kangyuzhe666/kintex-410t-devboard/clocks.kicad_sch

## KiCad design clocks.kicad_sch (2023-04-08)

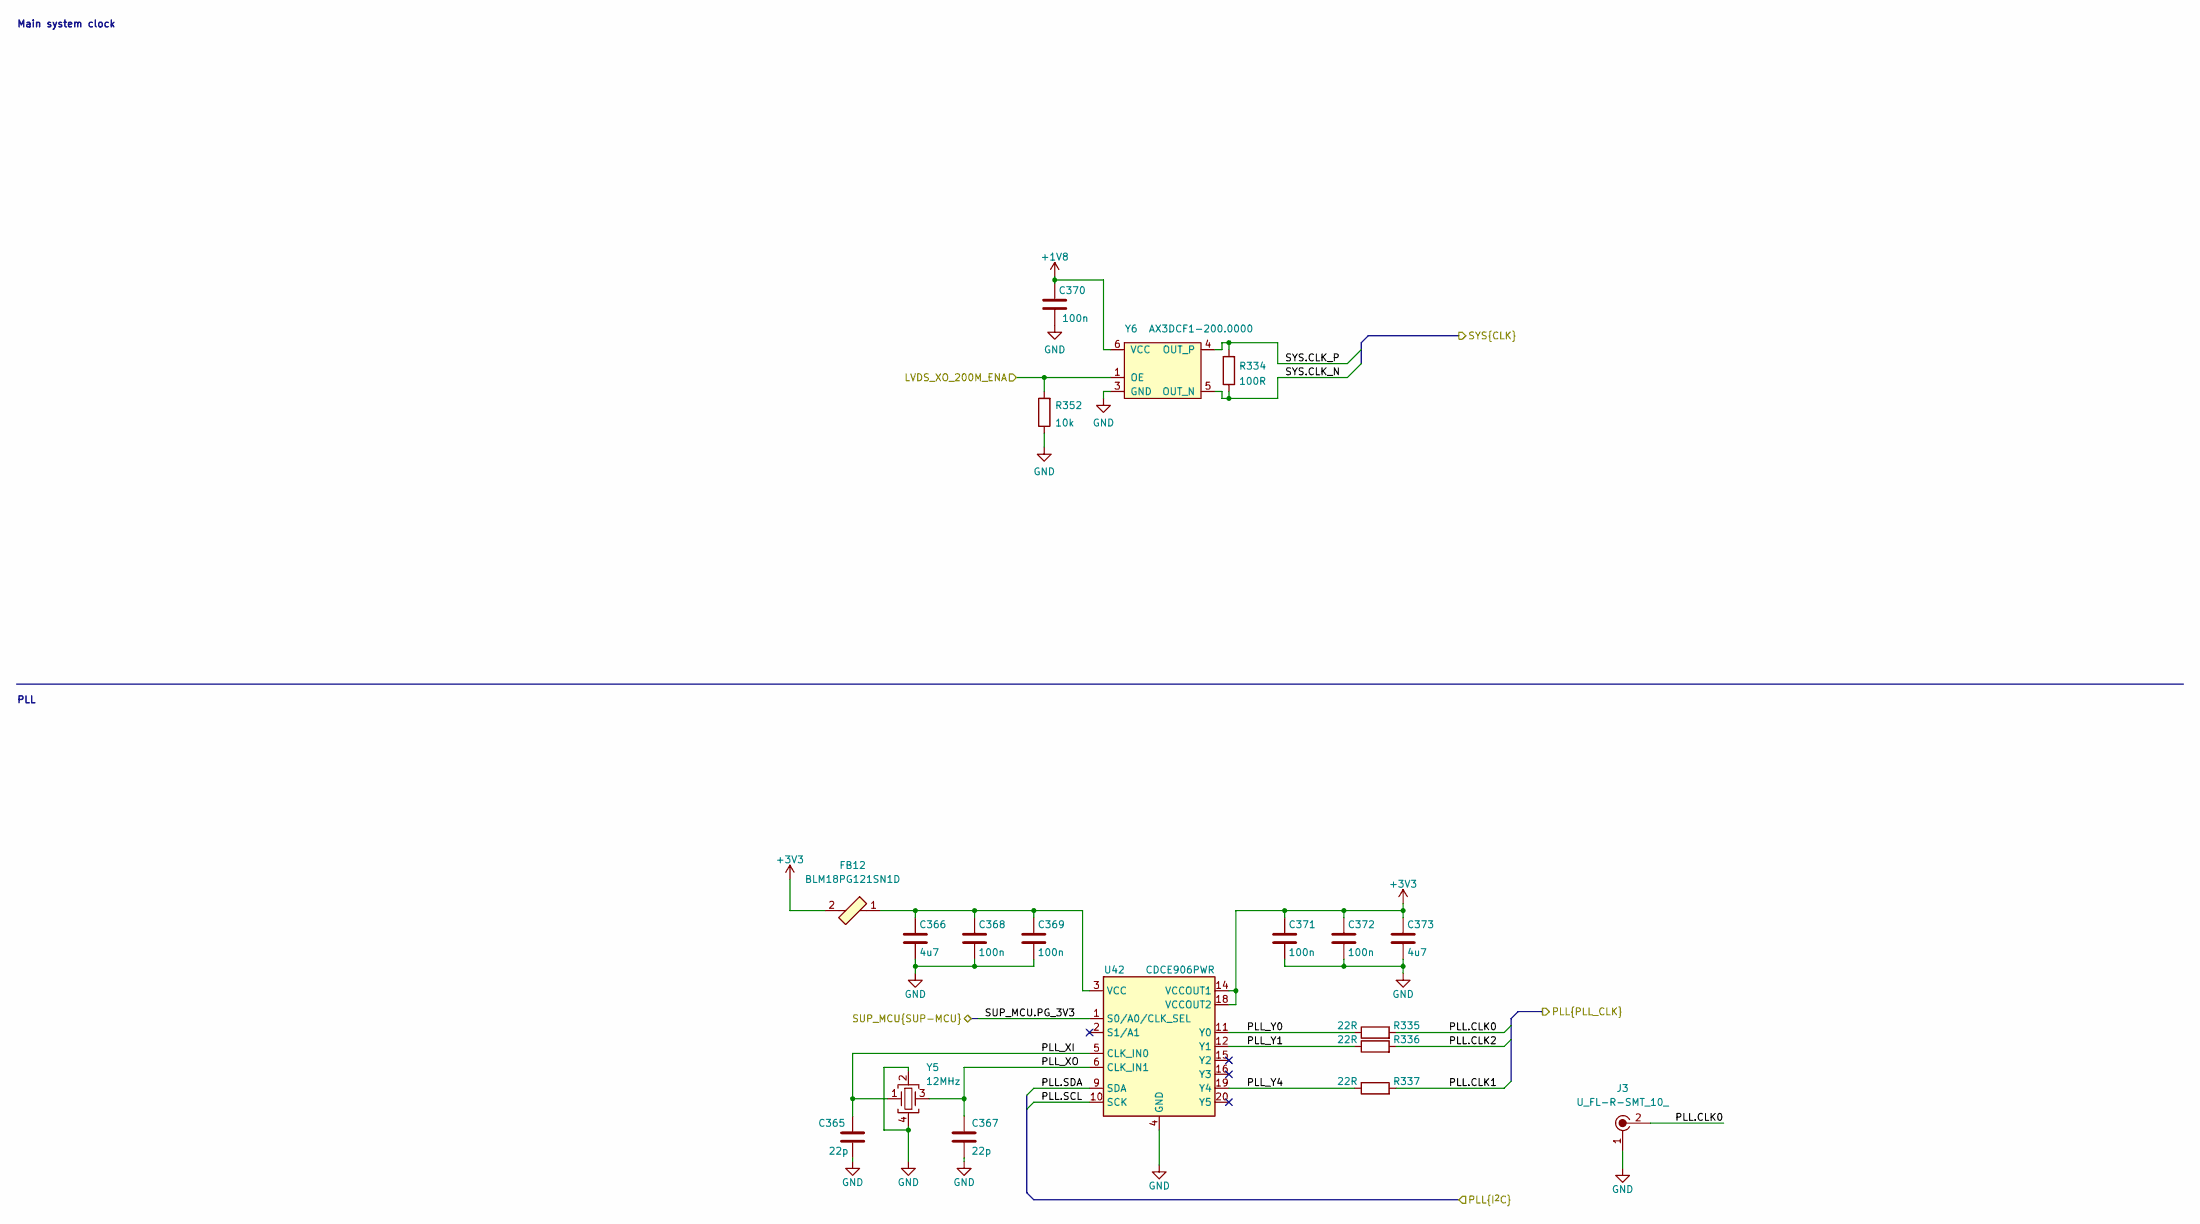
[picture p3: schematic clocks.kicad_sch]

Parts:
C365, C367: C_22p_0402; 0402-cap; MPN CC0402JRNPO9BN220
C366, C373: C_4u7_0201; 0201-cap; MPN GRM035R60J475ME15D
C368, C369, C370, C371, C372: C_100n_0402; 0402-cap; MPN GRM155R61H104KE14D
FB12: BLM18PG121SN1D; 0603-res; MPN BLM18PG121SN1D
J3: U_FL-R-SMT_10_; Coax_Conn_U.FL; MPN U.FL-R-SMT(10)
R334: R_100R_0402; 0402-res; MPN CR0402-FX-1000GLF
R335, R336, R337: R_22R_0402; 0402-res; MPN CRCW040222R0FKED
R352: R_10k_0402; 0402-res; MPN CRCW040210K0FKEDHP
U42: CDCE906PWR; TSSOP-20_W4.4mm; MPN CDCE906PWR
Y5: ABM8G-12.000MHZ-18-D2Y-T; KX-7; MPN ABM8G-12.000MHZ-18-D2Y-T
Y6: AX3DCF1-200.0000; AX3DAF1; MPN AX3DCF1-200.0000

Connections:
+1V8: C370.1, Y6.6 (VCC)
+3V3: C371.1, C372.1, C373.1, FB12.2, U42.14 (VCCOUT1), U42.18 (VCCOUT2)
GND: C365.2, C366.2, C367.2, C368.2, C369.2, C370.2, C371.2, C372.2, C373.2, J3.1, R352.1, U42.4 (GND), U42.8 (GND), U42.13 (GND), U42.17 (GND), Y5.2, Y5.4, Y6.3 (GND)
LVDS_XO_200M_ENA: R352.2, Y6.1 (OE)
unnamed: C366.1, C368.1, C369.1, FB12.1, U42.3 (VCC), U42.7 (VCC)
PLL.CLK0: J3.2, R335.2
PLL.CLK1: R337.2
PLL.CLK2: R336.2
PLL.SCL: U42.10 (SCK)
PLL.SDA: U42.9 (SDA)
PLL_XI: C365.1, U42.5 (CLK_IN0), Y5.1
PLL_XO: C367.1, U42.6 (CLK_IN1), Y5.3
PLL_Y0: R335.1, U42.11 (Y0)
PLL_Y1: R336.1, U42.12 (Y1)
PLL_Y4: R337.1, U42.19 (Y4)
SUP_MCU.PG_3V3: U42.1 (S0/A0/CLK_SEL)
SYS.CLK_N: R334.1, Y6.5 (OUT_N)
SYS.CLK_P: R334.2, Y6.4 (OUT_P)

Notes on the sheet:
Main system clock
PLL
