kangyuzhe666/kintex-410t-devboard/dc-dc.kicad_sch

## KiCad design dc-dc.kicad_sch (2023-02-02)

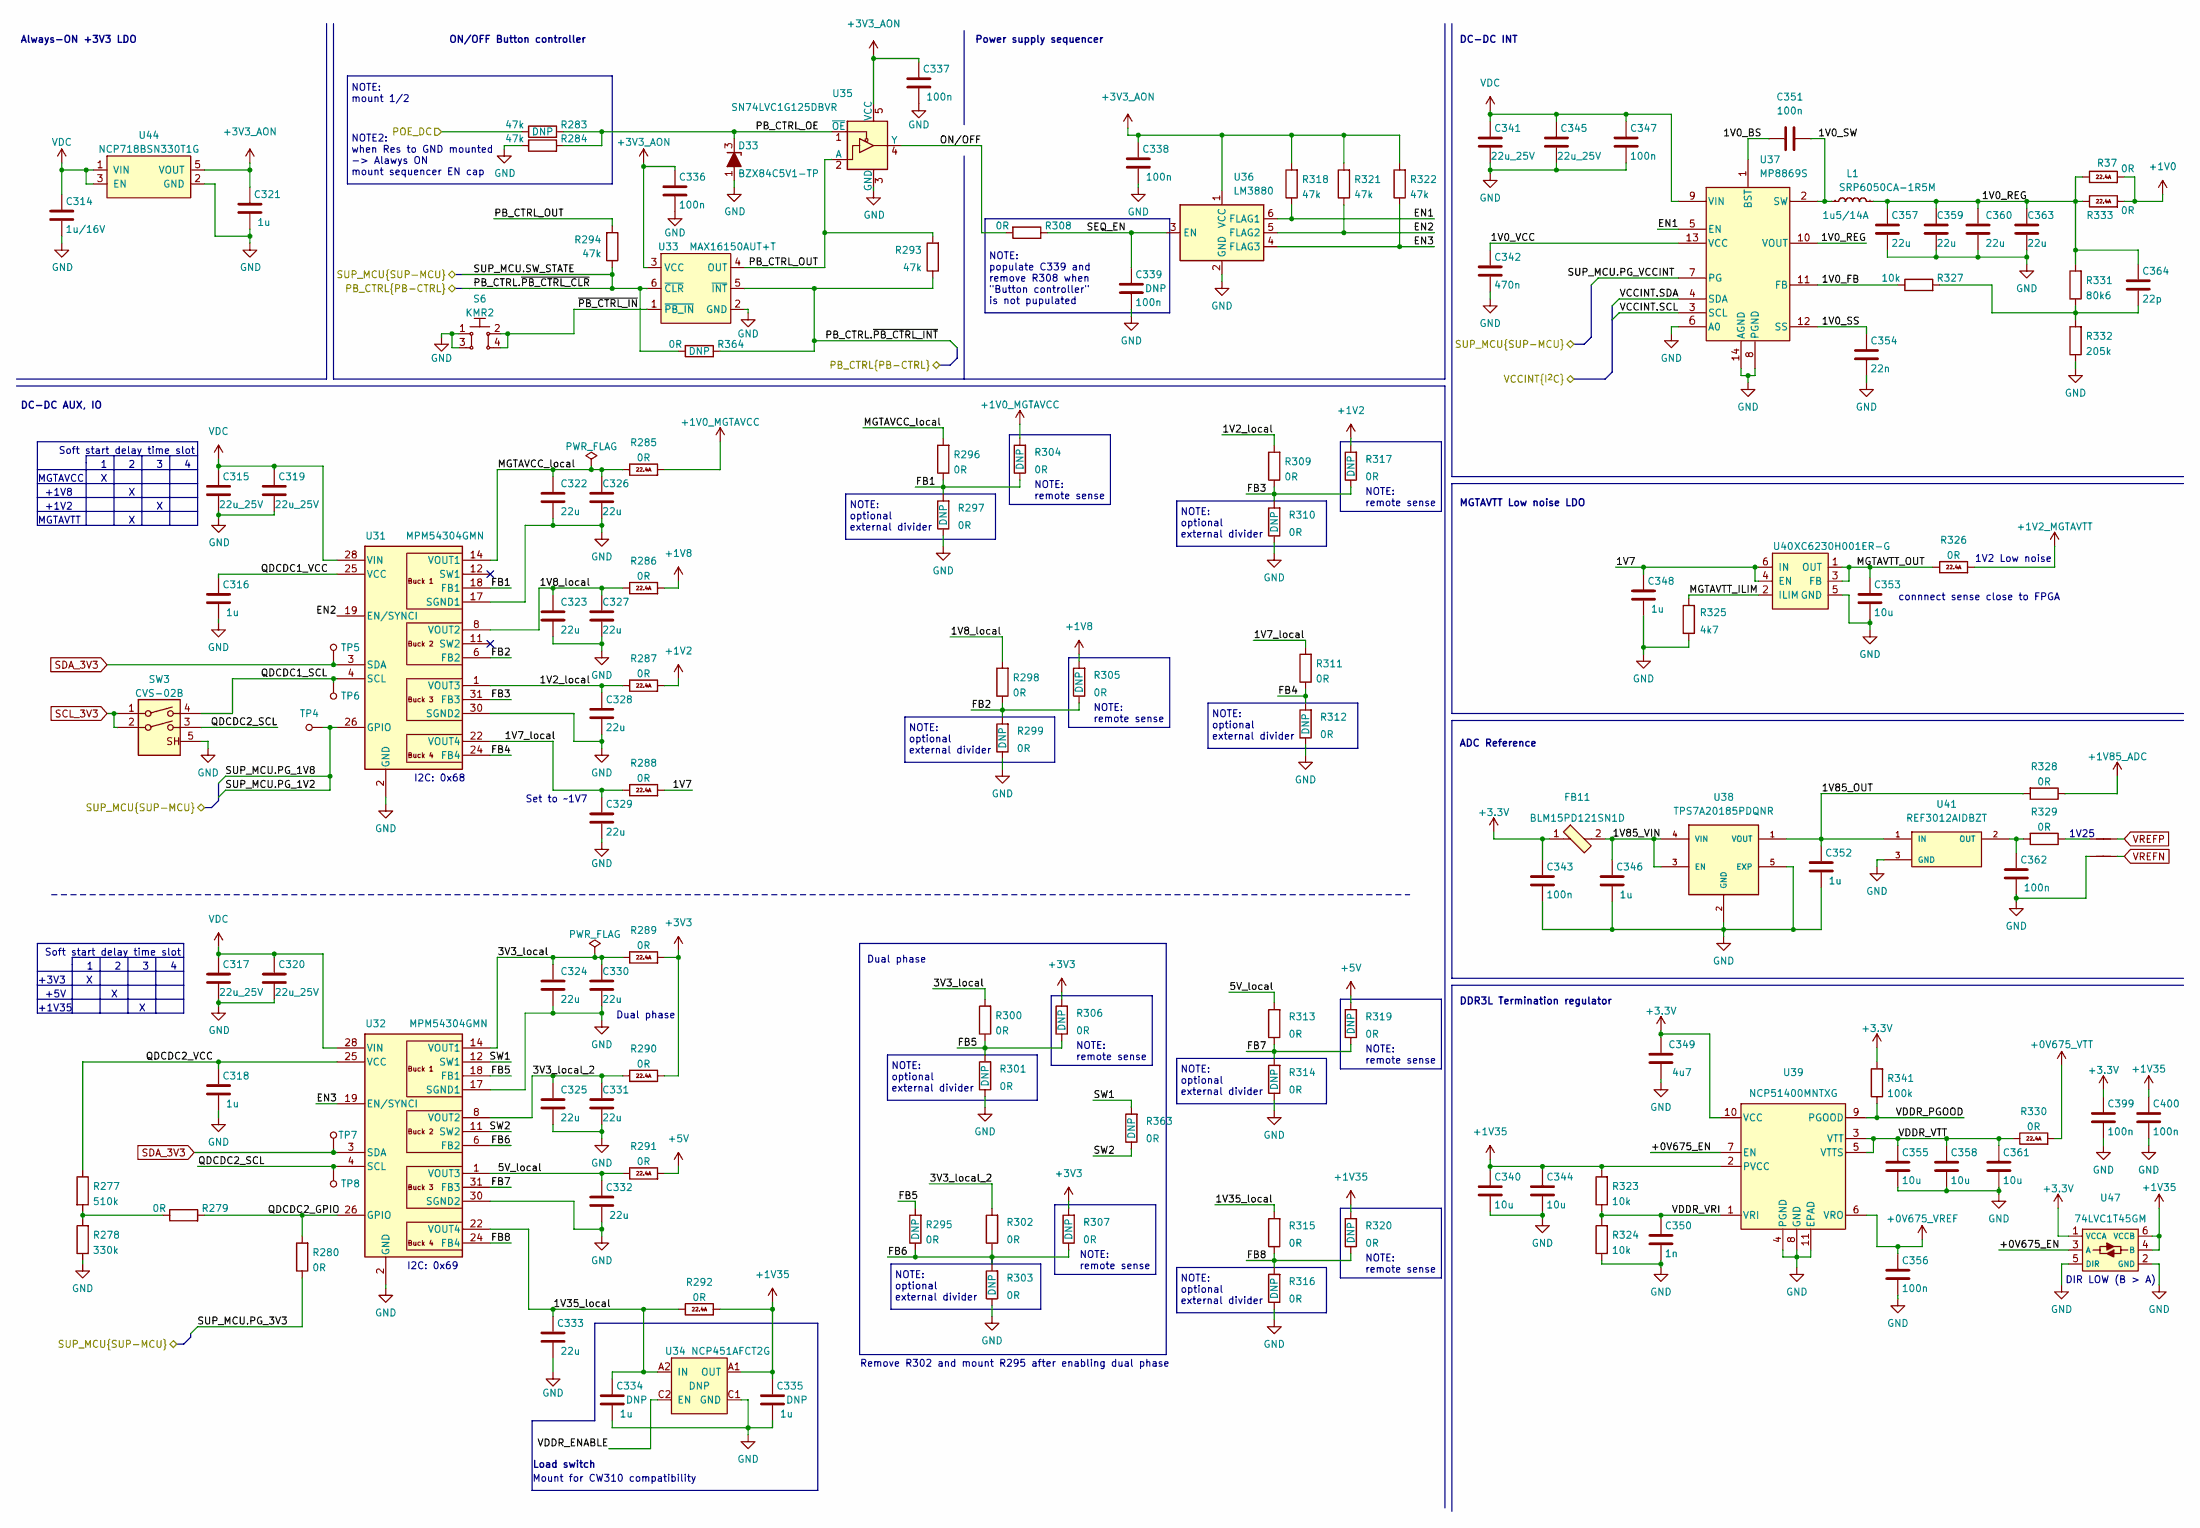
[picture p4: schematic dc-dc.kicad_sch]

Parts:
C314: C_1u_0402_16V; 0402-cap; MPN C0402C105M4PACTU
C315, C317, C319, C320, C341, C345: C_22u_0805_25V; 0805-cap; MPN CL21A226MAYNNNE
C316, C318, C321, C334, C335, C346, C348, C352: C_1u_0402; 0402-cap; MPN C1005X6S1A105K050BC
C322, C323, C324, C325, C326, C327, C328, C329, C330, C331, C332, C333, C357, C359, C360, C363: C_22u_0603; 0603-cap; MPN GRM188R60J226MEA0D
C336, C337, C338, C339, C343, C347, C351, C356, C362, C399, C400: C_100n_0402; 0402-cap; MPN GRM155R61H104KE14D
C340, C344, C353, C355, C358, C361: C_10u_0402; 0402-cap; MPN CC0402MRX5R5BB106
C342: C_470n_0402; 0402-cap; MPN C1005X5R1E474M050BB
C349: C_4u7_0201; 0201-cap; MPN GRM035R60J475ME15D
C350: C_1n_0402; 0402-res; MPN CC0402KRX7R9BB102
C354: C_22n_0402; 0402-cap; MPN GCM155R71H223MA55D
C364: C_22p_0402; 0402-cap; MPN CC0402JRNPO9BN220
D33: BZX84C5V1-TP; SOT-23-3; MPN BZX84C5V1-TP
FB11: BLM15PD121SN1D; 0402-res; MPN BLM15PD121SN1D
L1: SRP6050CA-1R5M; Bourns-SRP6050CA; MPN SRP6050CA-1R5M
NT1, NT2: NetTie_2; NetTie-2_SMD_Pad0.127mm
R37, R285, R286, R287, R288, R289, R290, R291, R292, R326, R330, R333: R_0R_0603_HPWR; 0603-res; MPN PMR03EZPJ000
R277: R_510k_0402; 0402-res; MPN MCWR04X5103FTL
R278: R_330k_0402; 0402-res; MPN ERJ-2RKF3303X
R279, R280, R295, R296, R297, R298, R299, R300, R301, R302, R303, R304, R305, R306, R307, R308, R309, R310, R311, R312, R313, R314, R315, R316, R317, R319, R320, R328, R329, R363, R364: R_0R_0402; 0402-res; MPN ERJ2GE0R00X
R283, R284, R293, R294, R318, R321, R322: R_47k_0402; 0402-res; MPN MCMR04X4702FTL
R323, R324, R327: R_10k_0402; 0402-res; MPN CRCW040210K0FKEDHP
R325: R_4k7_0402; 0402-res; MPN MCS04020C4701FE000
R331: R_80k6_0402; 0402-res; MPN ERJ2RKF8062X
R332: R_205k_0402; 0402-res; MPN CR0402-FX-2053GLF
R341: R_100k_0402; 0402-res; MPN CRCW0402100KFKEDHP
S6: KMR2; SW_SPST_4.2x2.8; MPN KMR211NGLFS
SW3: CVS-02B; SW_DIP_SPSTx02_Slide_Copal_CVS-02xB_W5.9mm_P1mm; MPN CVS-02B
TP4, TP5, TP6, TP7, TP8: TP_SMD_0_75MM; Testpoint_smd_0_75mm
U31, U32: MPM54304GMN; MPS_LGA-33; MPN MPM54304GMN-0000
U33: MAX16150AUT+T; SOT-23-6; MPN MAX16150AUT+T
U34: NCP451AFCT2G; Onsemi_WLCSP6_1.40x0.90; MPN NCP451AFCT2G
U35: SN74LVC1G125DBVR; SOT-753; MPN SN74LVC1G125DBVR
U36: LM3880; SOT-23-6; MPN LM3880MFX-1AA/NOPB
U37: MP8869S; MPS_QFN-14_MP8869S; MPN MP8869SGL-P
U38: TPS7A20185PDQNR; XDFN4; MPN TPS7A20185PDQNR
U39: NCP51400MNTXG; DFN-10-1EP_3x3mm; MPN NCP51400MNTXG
U40: XC6230H001ER-G; Torex_USP-6C; MPN XC6230H001ER-G
U41: REF3012AIDBZT; SOT-23-3; MPN REF3012AIDBZT
U44: NCP718BSN330T1G; SOT-23-5; MPN NCP718BSN330T1G
U47: 74LVC1T45GM; SOT-886; MPN 74LVC1T45GM-Q100X

Connections:
1V0_BS: C351.1, U37.1 (BST)
1V0_FB: R327.1, U37.11 (FB)
1V0_REG: C357.1, C359.1, C360.1, C363.1, C364.1, L1.2, R37.1, R331.2, R333.1, U37.10 (VOUT)
1V0_SS: C354.1, U37.12 (SS)
1V0_SW: C351.2, L1.1, U37.2 (SW)
1V0_VCC: C342.1, U37.13 (VCC)
1V2_local: C328.1, R287.1, R309.2, U31.1 (VOUT3), U31.32 (VOUT3)
1V7: C348.1, R288.2, U40.4 (EN), U40.6 (IN)
1V7_local: C329.1, R288.1, R311.2, U31.22 (VOUT4), U31.23 (VOUT4)
1V8_local: C323.1, C327.1, R286.1, R298.2, U31.8 (VOUT2), U31.9 (VOUT2)
1V35_local: C333.1, C334.1, R292.1, R315.2, U32.22 (VOUT4), U32.23 (VOUT4), U34.A2 (IN), U34.B2 (IN)
1V85_OUT: C352.1, R328.2, U38.1 (VOUT), U41.1 (IN)
1V85_VIN: C346.1, FB11.2, U38.3 (EN), U38.4 (VIN)
3V3_local: C324.1, C330.1, R289.1, R300.2, U32.14 (VOUT1), U32.15 (VOUT1)
3V3_local_2: C325.1, C331.1, R290.1, R302.2, U32.8 (VOUT2), U32.9 (VOUT2)
5V_local: C332.1, R291.1, R313.2, U32.1 (VOUT3), U32.32 (VOUT3)
+0V675_EN: U39.7 (EN), U47.3 (A)
+0V675_VREF: C356.1, U39.6 (VRO)
+0V675_VTT: R330.2
+1V0: R37.2, R333.2
+1V0_MGTAVCC: R285.2, R304.2
+1V2: R287.2, R317.2
+1V2_MGTAVTT: R326.2
+1V8: R286.2, R305.2
+1V35: C335.1, C340.1, C344.1, C400.1, R292.2, R320.2, R323.2, U34.A1 (OUT), U34.B1 (OUT), U39.2 (PVCC), U47.4 (B), U47.6 (VCCB)
+1V85_ADC: R328.1
+3.3V: C343.1, C349.1, C399.1, FB11.1, R341.2, U39.10 (VCC), U47.1 (VCCA)
+3V3: R289.2, R290.2, R306.2, R307.2
+3V3_AON: C321.1, C336.1, C337.1, C338.1, R318.2, R321.2, R322.2, U33.3 (VCC), U35.5 (VCC), U36.1 (VCC), U44.5 (VOUT)
+5V: R291.2, R319.2
EN1: R318.1, U36.6 (FLAG1), U37.5 (EN)
EN2: R321.1, U31.19 (EN/SYNCI), U36.5 (FLAG2)
EN3: R322.1, U32.19 (EN/SYNCI), U36.4 (FLAG3)
FB1: R296.1, R297.2, R304.1, U31.18 (FB1)
FB2: R298.1, R299.2, R305.1, U31.6 (FB2)
FB3: R309.1, R310.2, R317.1, U31.31 (FB3)
FB4: R311.1, R312.2, U31.24 (FB4)
FB5: R295.2, R300.1, R301.2, R306.1, U32.18 (FB1)
FB6: R295.1, R302.1, R303.2, R307.1, U32.6 (FB2)
FB7: R313.1, R314.2, R319.1, U32.31 (FB3)
FB8: R315.1, R316.2, R320.1, U32.24 (FB4)
GND: C314.2, C315.2, C316.2, C317.2, C318.2, C319.2, C320.2, C321.2, C322.2, C323.2, C324.2, C325.2, C326.2, C327.2, C328.2, C329.2, C330.2, C331.2, C332.2, C333.2, C334.2, C335.2, C336.2, C337.2, C338.2, C339.2, C340.2, C341.2, C342.2, C343.2, C344.2, C345.2, C346.2, C347.2, C348.2, C349.2, C350.2, C352.2, C353.2, C354.2, C355.2, C356.2, C357.2, C358.2, C359.2, C360.2, C361.2, C362.2, C363.2, C399.2, C400.2, D33.1, NT2.1, R278.1, R284.1, R297.1, R299.1, R301.1, R303.1, R310.1, R312.1, R314.1, R316.1, R324.1, R325.1, R332.1, S6.1, S6.3, SW3.5 (SH), U31.2 (GND), U31.5 (GND), U31.7 (GND), U31.10 (GND), U31.13 (GND), U31.16 (GND), U31.17 (SGND1), U31.20 (GND), U31.21 (GND), U31.27 (GND), U31.30 (SGND2), U31.33 (GND), U32.2 (GND), U32.5 (GND), U32.7 (GND), U32.10 (GND), U32.13 (GND), U32.16 (GND), U32.17 (SGND1), U32.20 (GND), U32.21 (GND), U32.27 (GND), U32.30 (SGND2), U32.33 (GND), U33.2 (GND), U34.C1 (GND), U35.3 (GND), U36.2 (GND), U37.6 (A0), U37.8 (PGND), U37.14 (AGND), U38.2 (GND), U38.5 (EXP), U39.4 (PGND), U39.8 (GND), U39.11 (EPAD), U40.5 (GND), U40.7 (EP), U41.3 (GND), U44.2 (GND), U47.2 (GND), U47.5 (DIR)
MGTAVCC_local: C322.1, C326.1, R285.1, R296.2, U31.14 (VOUT1), U31.15 (VOUT1)
MGTAVTT_ILIM: R325.2, U40.2 (ILIM)
MGTAVTT_OUT: C353.1, R326.1, U40.1 (OUT), U40.3 (FB)
unnamed: C362.1, R329.2, U41.2 (OUT)
unnamed: C364.2, R327.2, R331.1, R332.2
unnamed: NT1.1, R329.1
unnamed: R277.2, R278.2, R279.1
ON/OFF: R308.2, U35.4 (Y)
PB_CTRL.~PB_CTRL_CLR: R294.1, R364.2, U33.6 (~CLR)
PB_CTRL.~PB_CTRL_INT: R293.1, R364.1, U33.5 (~INT)
PB_CTRL_OE: D33.3, R283.2, R284.2, U35.1 (~OE)
PB_CTRL_OUT: R293.2, R294.2, U33.4 (OUT), U35.2 (A)
POE_DC: R283.1
QDCDC1_SCL: SW3.4, TP6.1, U31.4 (SCL)
QDCDC1_VCC: C316.1, U31.25 (VCC)
QDCDC2_GPIO: R279.2, R280.2, U32.26 (GPIO)
QDCDC2_SCL: SW3.3, TP8.1, U32.4 (SCL)
QDCDC2_VCC: C318.1, R277.1, U32.25 (VCC)
SCL_3V3: SW3.1, SW3.2
SDA_3V3: TP5.1, TP7.1, U31.3 (SDA), U32.3 (SDA)
SEQ_EN: C339.1, R308.1, U36.3 (EN)
SUP_MCU.PG_1V2: TP4.1, U31.26 (GPIO)
SUP_MCU.PG_3V3: R280.1
SUP_MCU.PG_VCCINT: U37.7 (PG)
SW1: R363.2, U32.12 (SW1)
SW2: R363.1, U32.11 (SW2)
VCCINT.SCL: U37.3 (SCL)
VCCINT.SDA: U37.4 (SDA)
VDC: C314.1, C315.1, C317.1, C319.1, C320.1, C341.1, C345.1, C347.1, U31.28 (VIN), U31.29 (VIN), U32.28 (VIN), U32.29 (VIN), U37.9 (VIN), U44.1 (VIN), U44.3 (EN)
VDDR_ENABLE: U34.C2 (EN)
VDDR_PGOOD: R341.1, U39.9 (PGOOD)
VDDR_VRI: C350.1, R323.1, R324.2, U39.1 (VRI)
VDDR_VTT: C355.1, C358.1, C361.1, R330.1, U39.3 (VTT), U39.5 (VTTS)
VREFN: NT2.2
VREFP: NT1.2
~PB_CTRL_IN: S6.2, S6.4, U33.1 (~PB_IN)

Notes on the sheet:
Dual phase
MGTAVCC
Always-ON +3V3 LDO
I2C: 0x68
Soft start delay time slot
Mount for CW310 compatibility
+1V8
ADC Reference
NOTE: populate C339 and remove R308 when "Button controller" is not pupulated
MGTAVTT
NOTE: optional external divider
NOTE: remote sense
DIR LOW (B > A)
Set to ~1V7
1 2 3 4
+1V35
connnect sense close to FPGA
+5V
MGTAVTT Low noise LDO
Power supply sequencer
DC-DC INT
Load switch
I2C: 0x69
DC-DC AUX, IO
+1V2
1V2 Low noise
1V25
ON/OFF Button controller
Remove R302 and mount R295 after enabling dual phase
NOTE: mount 1/2
+3V3
DDR3L Termination regulator
NOTE2: when Res to GND mounted -> Alawys ON mount sequencer EN cap
