kangyuzhe666/kintex-410t-devboard/fmc-hspc.kicad_sch

## KiCad design fmc-hspc.kicad_sch (2023-04-08)

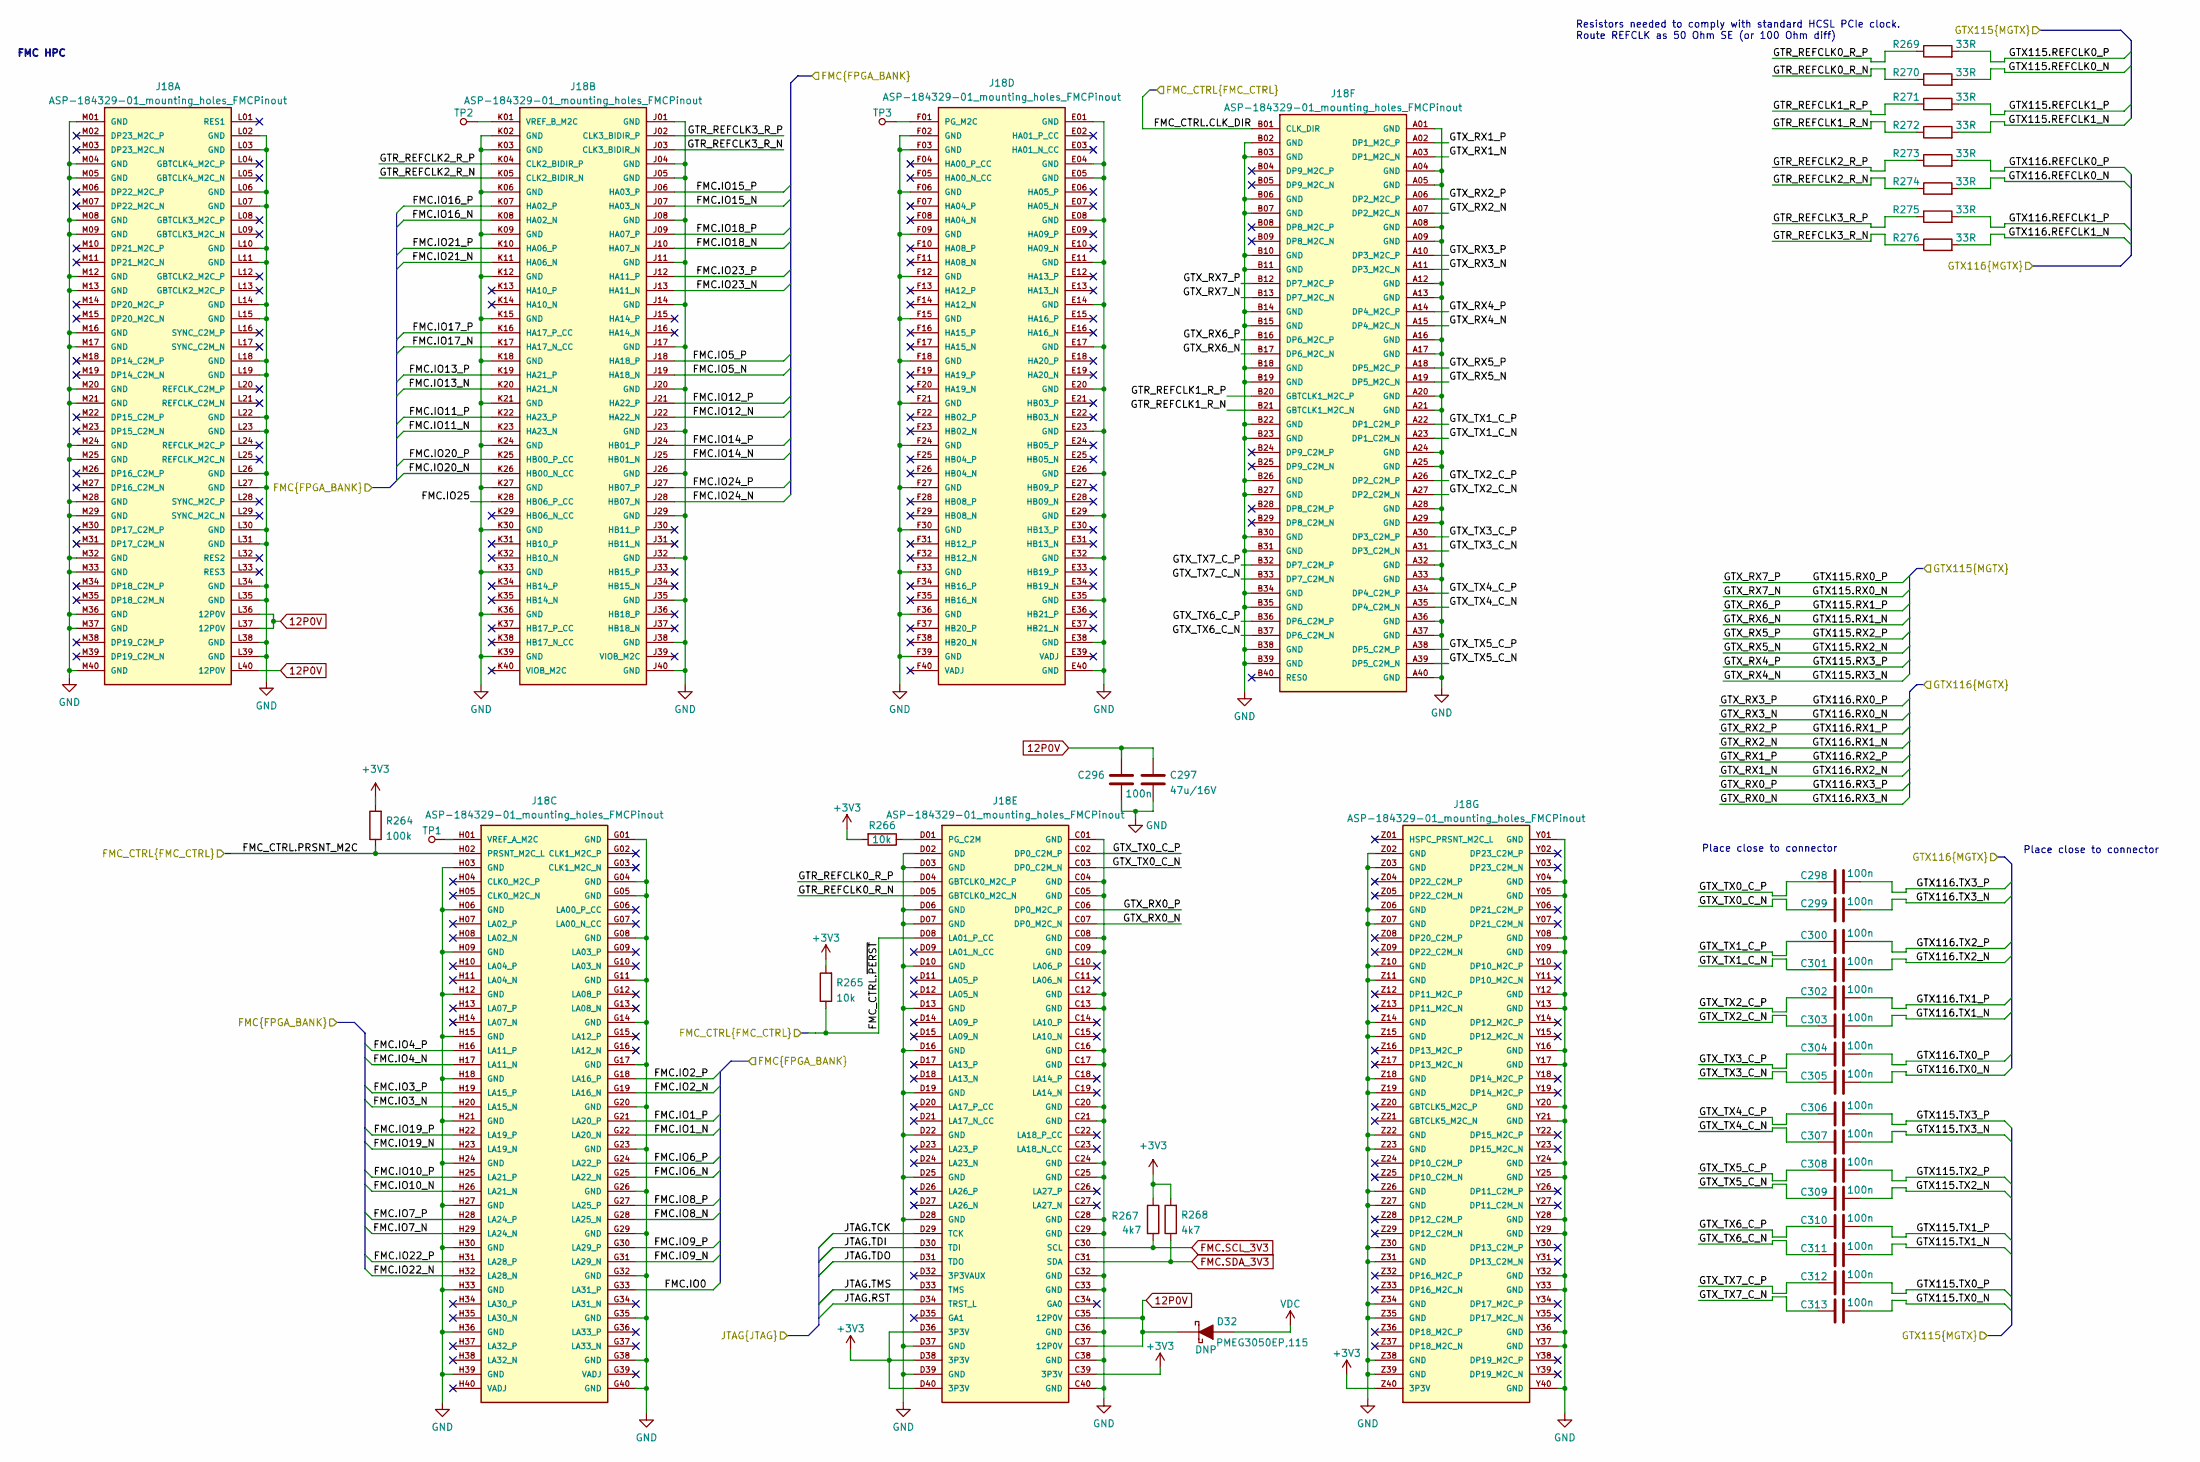
[picture p5: schematic fmc-hspc.kicad_sch]

Parts:
C296: C_100n_0402_EIA; 0402-cap_EIA; MPN GRM155R61H104KE14D
C297: C_47u_16V_1206; 1206-cap; MPN C3216X5R1C476M160AB
C298, C299, C300, C301, C302, C303, C304, C305, C306, C307, C308, C309, C310, C311, C312, C313: C_100n_0402; 0402-cap; MPN GRM155R61H104KE14D
D32: PMEG3050EP,115; Nexperia_SOD128; MPN PMEG3050EP,115
J18: ASP-184329-01_mounting_holes_FMCPinout; ASP-184329-01_mounting_holes; MPN ASP-184329-01
R264: R_100k_0402; 0402-res; MPN CRCW0402100KFKEDHP
R265, R266: R_10k_0402; 0402-res; MPN CRCW040210K0FKEDHP
R267, R268: R_4k7_0402; 0402-res; MPN MCS04020C4701FE000
R269, R270, R271, R272, R273, R274, R275, R276: R_33R_0402; 0402-res; MPN CRCW040233R0FKED
TP1, TP2, TP3: TP_SMD_0_75MM; Testpoint_smd_0_75mm

Connections:
12P0V: C296.1, C297.1, D32.1, J18.C35 (12P0V), J18.C37 (12P0V), J18.L36 (12P0V), J18.L37 (12P0V), J18.L40 (12P0V)
+3V3: J18.C39 (3P3V), J18.D36 (3P3V), J18.D38 (3P3V), J18.D40 (3P3V), J18.Z40 (3P3V), R264.2, R265.2, R266.2, R267.1, R268.2
FMC.IO0: J18.G33 (LA31_P)
FMC.IO1_N: J18.G22 (LA20_N)
FMC.IO1_P: J18.G21 (LA20_P)
FMC.IO2_N: J18.G19 (LA16_N)
FMC.IO2_P: J18.G18 (LA16_P)
FMC.IO3_N: J18.H20 (LA15_N)
FMC.IO3_P: J18.H19 (LA15_P)
FMC.IO4_N: J18.H17 (LA11_N)
FMC.IO4_P: J18.H16 (LA11_P)
FMC.IO5_N: J18.J19 (HA18_N)
FMC.IO5_P: J18.J18 (HA18_P)
FMC.IO6_N: J18.G25 (LA22_N)
FMC.IO6_P: J18.G24 (LA22_P)
FMC.IO7_N: J18.H29 (LA24_N)
FMC.IO7_P: J18.H28 (LA24_P)
FMC.IO8_N: J18.G28 (LA25_N)
FMC.IO8_P: J18.G27 (LA25_P)
FMC.IO9_N: J18.G31 (LA29_N)
FMC.IO9_P: J18.G30 (LA29_P)
FMC.IO10_N: J18.H26 (LA21_N)
FMC.IO10_P: J18.H25 (LA21_P)
FMC.IO11_N: J18.K23 (HA23_N)
FMC.IO11_P: J18.K22 (HA23_P)
FMC.IO12_N: J18.J22 (HA22_N)
FMC.IO12_P: J18.J21 (HA22_P)
FMC.IO13_N: J18.K20 (HA21_N)
FMC.IO13_P: J18.K19 (HA21_P)
FMC.IO14_N: J18.J25 (HB01_N)
FMC.IO14_P: J18.J24 (HB01_P)
FMC.IO15_N: J18.J07 (HA03_N)
FMC.IO15_P: J18.J06 (HA03_P)
FMC.IO16_N: J18.K08 (HA02_N)
FMC.IO16_P: J18.K07 (HA02_P)
FMC.IO17_N: J18.K17 (HA17_N_CC)
FMC.IO17_P: J18.K16 (HA17_P_CC)
FMC.IO18_N: J18.J10 (HA07_N)
FMC.IO18_P: J18.J09 (HA07_P)
FMC.IO19_N: J18.H23 (LA19_N)
FMC.IO19_P: J18.H22 (LA19_P)
FMC.IO20_N: J18.K26 (HB00_N_CC)
FMC.IO20_P: J18.K25 (HB00_P_CC)
FMC.IO21_N: J18.K11 (HA06_N)
FMC.IO21_P: J18.K10 (HA06_P)
FMC.IO22_N: J18.H32 (LA28_N)
FMC.IO22_P: J18.H31 (LA28_P)
FMC.IO23_N: J18.J13 (HA11_N)
FMC.IO23_P: J18.J12 (HA11_P)
FMC.IO24_N: J18.J28 (HB07_N)
FMC.IO24_P: J18.J27 (HB07_P)
FMC.IO25: J18.K28 (HB06_P_CC)
FMC.SCL_3V3: J18.C30 (SCL), R267.2
FMC.SDA_3V3: J18.C31 (SDA), R268.1
FMC_CTRL.CLK_DIR: J18.B01 (CLK_DIR)
FMC_CTRL.PRSNT_M2C: J18.H02 (PRSNT_M2C_L), R264.1
FMC_CTRL.~PERST: J18.D08 (LA01_P_CC), R265.1
GND: C296.2, C297.2, J18.A01 (GND), J18.A04 (GND), J18.A05 (GND), J18.A08 (GND), J18.A09 (GND), J18.A12 (GND), J18.A13 (GND), J18.A16 (GND), J18.A17 (GND), J18.A20 (GND), J18.A21 (GND), J18.A24 (GND), J18.A25 (GND), J18.A28 (GND), J18.A29 (GND), J18.A32 (GND), J18.A33 (GND), J18.A36 (GND), J18.A37 (GND), J18.A40 (GND), J18.B02 (GND), J18.B03 (GND), J18.B06 (GND), J18.B07 (GND), J18.B10 (GND), J18.B11 (GND), J18.B14 (GND), J18.B15 (GND), J18.B18 (GND), J18.B19 (GND), J18.B22 (GND), J18.B23 (GND), J18.B26 (GND), J18.B27 (GND), J18.B30 (GND), J18.B31 (GND), J18.B34 (GND), J18.B35 (GND), J18.B38 (GND), J18.B39 (GND), J18.C01 (GND), J18.C04 (GND), J18.C05 (GND), J18.C08 (GND), J18.C09 (GND), J18.C12 (GND), J18.C13 (GND), J18.C16 (GND), J18.C17 (GND), J18.C20 (GND), J18.C21 (GND), J18.C24 (GND), J18.C25 (GND), J18.C28 (GND), J18.C29 (GND), J18.C32 (GND), J18.C33 (GND), J18.C36 (GND), J18.C38 (GND), J18.C40 (GND), J18.D02 (GND), J18.D03 (GND), J18.D06 (GND), J18.D07 (GND), J18.D10 (GND), J18.D13 (GND), J18.D16 (GND), J18.D19 (GND), J18.D22 (GND), J18.D25 (GND), J18.D28 (GND), J18.D37 (GND), J18.D39 (GND), J18.E01 (GND), J18.E04 (GND), J18.E05 (GND), J18.E08 (GND), J18.E11 (GND), J18.E14 (GND), J18.E17 (GND), J18.E20 (GND), J18.E23 (GND), J18.E26 (GND), J18.E29 (GND), J18.E32 (GND), J18.E35 (GND), J18.E38 (GND), J18.E40 (GND), J18.F02 (GND), J18.F03 (GND), J18.F06 (GND), J18.F09 (GND), J18.F12 (GND), J18.F15 (GND), J18.F18 (GND), J18.F21 (GND), J18.F24 (GND), J18.F27 (GND), J18.F30 (GND), J18.F33 (GND), J18.F36 (GND), J18.F39 (GND), J18.G01 (GND), J18.G04 (GND), J18.G05 (GND), J18.G08 (GND), J18.G11 (GND), J18.G14 (GND), J18.G17 (GND), J18.G20 (GND), J18.G23 (GND), J18.G26 (GND), J18.G29 (GND), J18.G32 (GND), J18.G35 (GND), J18.G38 (GND), J18.G40 (GND), J18.H03 (GND), J18.H06 (GND), J18.H09 (GND), J18.H12 (GND), J18.H15 (GND), J18.H18 (GND), J18.H21 (GND), J18.H24 (GND), J18.H27 (GND), J18.H30 (GND), J18.H33 (GND), J18.H36 (GND), J18.H39 (GND), J18.J01 (GND), J18.J04 (GND), J18.J05 (GND), J18.J08 (GND), J18.J11 (GND), J18.J14 (GND), J18.J17 (GND), J18.J20 (GND), J18.J23 (GND), J18.J26 (GND), J18.J29 (GND), J18.J32 (GND), J18.J35 (GND), J18.J38 (GND), J18.J40 (GND), J18.K02 (GND), J18.K03 (GND), J18.K06 (GND), J18.K09 (GND), J18.K12 (GND), J18.K15 (GND), J18.K18 (GND), J18.K21 (GND), J18.K24 (GND), J18.K27 (GND), J18.K30 (GND), J18.K33 (GND), J18.K36 (GND), J18.K39 (GND), J18.L02 (GND), J18.L03 (GND), J18.L06 (GND), J18.L07 (GND), J18.L10 (GND), J18.L11 (GND), J18.L14 (GND), J18.L15 (GND), J18.L18 (GND), J18.L19 (GND), J18.L22 (GND), J18.L23 (GND), J18.L26 (GND), J18.L27 (GND), J18.L30 (GND), J18.L31 (GND), J18.L34 (GND), J18.L35 (GND), J18.L38 (GND), J18.L39 (GND), J18.M01 (GND), J18.M04 (GND), J18.M05 (GND), J18.M08 (GND), J18.M09 (GND), J18.M12 (GND), J18.M13 (GND), J18.M16 (GND), J18.M17 (GND), J18.M20 (GND), J18.M21 (GND), J18.M24 (GND), J18.M25 (GND), J18.M28 (GND), J18.M29 (GND), J18.M32 (GND), J18.M33 (GND), J18.M36 (GND), J18.M37 (GND), J18.M40 (GND), J18.Y01 (GND), J18.Y04 (GND), J18.Y05 (GND), J18.Y08 (GND), J18.Y09 (GND), J18.Y12 (GND), J18.Y13 (GND), J18.Y16 (GND), J18.Y17 (GND), J18.Y20 (GND), J18.Y21 (GND), J18.Y24 (GND), J18.Y25 (GND), J18.Y28 (GND), J18.Y29 (GND), J18.Y32 (GND), J18.Y33 (GND), J18.Y36 (GND), J18.Y37 (GND), J18.Y40 (GND), J18.Z02 (GND), J18.Z03 (GND), J18.Z06 (GND), J18.Z07 (GND), J18.Z10 (GND), J18.Z11 (GND), J18.Z14 (GND), J18.Z15 (GND), J18.Z18 (GND), J18.Z19 (GND), J18.Z22 (GND), J18.Z23 (GND), J18.Z26 (GND), J18.Z27 (GND), J18.Z30 (GND), J18.Z31 (GND), J18.Z34 (GND), J18.Z35 (GND), J18.Z38 (GND), J18.Z39 (GND)
GTR_REFCLK0_R_N: J18.D05 (GBTCLK0_M2C_N), R270.1
GTR_REFCLK0_R_P: J18.D04 (GBTCLK0_M2C_P), R269.1
GTR_REFCLK1_R_N: J18.B21 (GBTCLK1_M2C_N), R272.1
GTR_REFCLK1_R_P: J18.B20 (GBTCLK1_M2C_P), R271.1
GTR_REFCLK2_R_N: J18.K05 (CLK2_BIDIR_N), R274.1
GTR_REFCLK2_R_P: J18.K04 (CLK2_BIDIR_P), R273.1
GTR_REFCLK3_R_N: J18.J03 (CLK3_BIDIR_N), R276.1
GTR_REFCLK3_R_P: J18.J02 (CLK3_BIDIR_P), R275.1
GTX115.REFCLK0_N: R270.2
GTX115.REFCLK0_P: R269.2
GTX115.REFCLK1_N: R272.2
GTX115.REFCLK1_P: R271.2
GTX115.RX0_N: J18.B13 (DP7_M2C_N)
GTX115.RX0_P: J18.B12 (DP7_M2C_P)
GTX115.RX1_N: J18.B17 (DP6_M2C_N)
GTX115.RX1_P: J18.B16 (DP6_M2C_P)
GTX115.RX2_N: J18.A19 (DP5_M2C_N)
GTX115.RX2_P: J18.A18 (DP5_M2C_P)
GTX115.RX3_N: J18.A15 (DP4_M2C_N)
GTX115.RX3_P: J18.A14 (DP4_M2C_P)
GTX115.TX0_N: C313.2
GTX115.TX0_P: C312.2
GTX115.TX1_N: C311.2
GTX115.TX1_P: C310.2
GTX115.TX2_N: C309.2
GTX115.TX2_P: C308.2
GTX115.TX3_N: C307.2
GTX115.TX3_P: C306.2
GTX116.REFCLK0_N: R274.2
GTX116.REFCLK0_P: R273.2
GTX116.REFCLK1_N: R276.2
GTX116.REFCLK1_P: R275.2
GTX116.RX0_N: J18.A11 (DP3_M2C_N)
GTX116.RX0_P: J18.A10 (DP3_M2C_P)
GTX116.RX1_N: J18.A07 (DP2_M2C_N)
GTX116.RX1_P: J18.A06 (DP2_M2C_P)
GTX116.RX2_N: J18.A03 (DP1_M2C_N)
GTX116.RX2_P: J18.A02 (DP1_M2C_P)
GTX116.RX3_N: J18.C07 (DP0_M2C_N)
GTX116.RX3_P: J18.C06 (DP0_M2C_P)
GTX116.TX0_N: C305.2
GTX116.TX0_P: C304.2
GTX116.TX1_N: C303.2
GTX116.TX1_P: C302.2
GTX116.TX2_N: C301.2
GTX116.TX2_P: C300.2
GTX116.TX3_N: C299.2
GTX116.TX3_P: C298.2
GTX_TX0_C_N: C299.1, J18.C03 (DP0_C2M_N)
GTX_TX0_C_P: C298.1, J18.C02 (DP0_C2M_P)
GTX_TX1_C_N: C301.1, J18.A23 (DP1_C2M_N)
GTX_TX1_C_P: C300.1, J18.A22 (DP1_C2M_P)
GTX_TX2_C_N: C303.1, J18.A27 (DP2_C2M_N)
GTX_TX2_C_P: C302.1, J18.A26 (DP2_C2M_P)
GTX_TX3_C_N: C305.1, J18.A31 (DP3_C2M_N)
GTX_TX3_C_P: C304.1, J18.A30 (DP3_C2M_P)
GTX_TX4_C_N: C307.1, J18.A35 (DP4_C2M_N)
GTX_TX4_C_P: C306.1, J18.A34 (DP4_C2M_P)
GTX_TX5_C_N: C309.1, J18.A39 (DP5_C2M_N)
GTX_TX5_C_P: C308.1, J18.A38 (DP5_C2M_P)
GTX_TX6_C_N: C311.1, J18.B37 (DP6_C2M_N)
GTX_TX6_C_P: C310.1, J18.B36 (DP6_C2M_P)
GTX_TX7_C_N: C313.1, J18.B33 (DP7_C2M_N)
GTX_TX7_C_P: C312.1, J18.B32 (DP7_C2M_P)
JTAG.RST: J18.D34 (TRST_L)
JTAG.TCK: J18.D29 (TCK)
JTAG.TDI: J18.D30 (TDI)
JTAG.TDO: J18.D31 (TDO)
JTAG.TMS: J18.D33 (TMS)
unnamed: J18.D01 (PG_C2M), R266.1
unnamed: J18.F01 (PG_M2C), TP3.1
unnamed: J18.H01 (VREF_A_M2C), TP1.1
unnamed: J18.K01 (VREF_B_M2C), TP2.1
VDC: D32.2

Notes on the sheet:
FMC HPC
Place close to connector
Resistors needed to comply with standard HCSL PCIe clock. Route REFCLK as 50 Ohm SE (or 100 Ohm diff)
