kangyuzhe666/kintex-410t-devboard/fpga-bank-34.kicad_sch

## KiCad design fpga-bank-34.kicad_sch (2023-04-08)

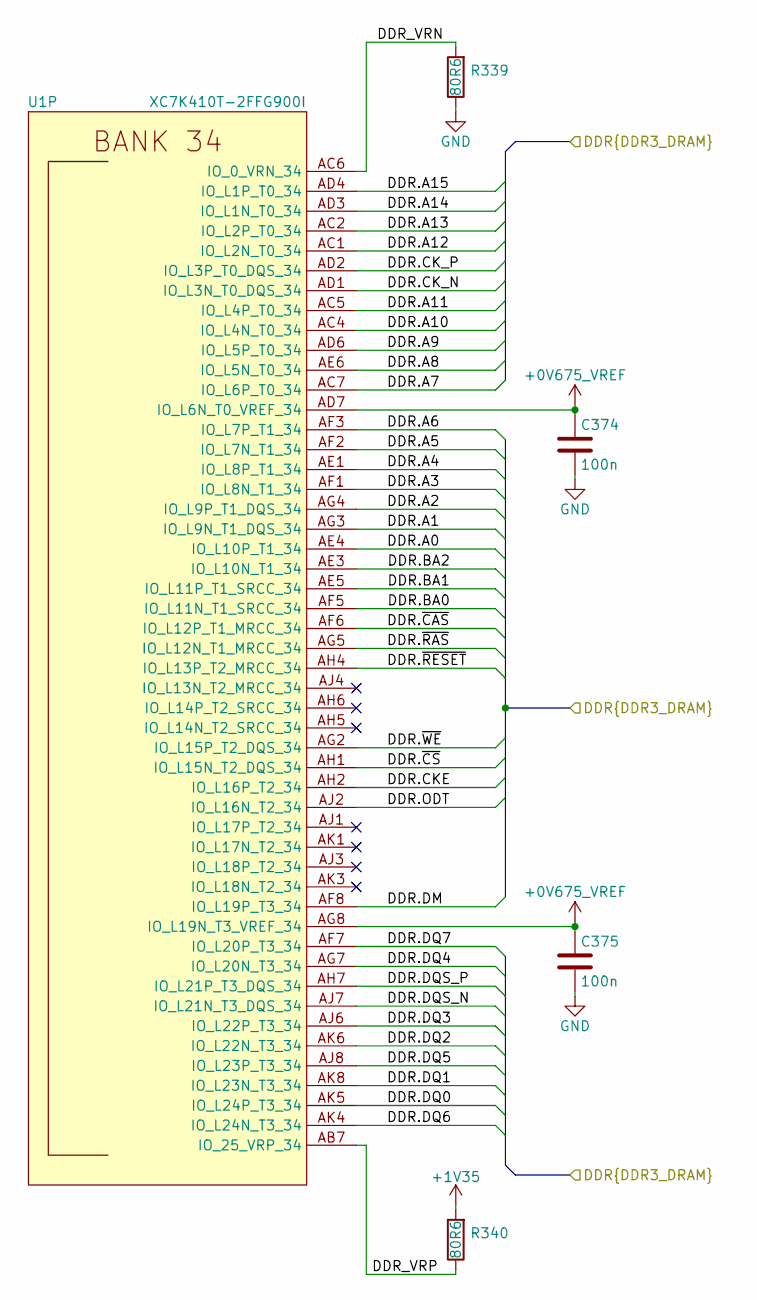
[picture p6: schematic fpga-bank-34.kicad_sch]

Parts:
C374, C375: C_100n_0402_EIA; 0402-cap_EIA; MPN GRM155R61H104KE14D
R339, R340: R_80R6_0402_EIA; 0402-res_EIA; MPN MC00625W0402180R6
U1: XC7K410T-2FFG900I; xc7k410t-2ffg900I; MPN XC7K410T-2FFG900I

Connections:
+0V675_VREF: C374.1, C375.1, U1.AD7 (IO_L6N_T0_VREF_34), U1.AG8 (IO_L19N_T3_VREF_34)
+1V35: R340.2
DDR.A0: U1.AE4 (IO_L10P_T1_34)
DDR.A1: U1.AG3 (IO_L9N_T1_DQS_34)
DDR.A2: U1.AG4 (IO_L9P_T1_DQS_34)
DDR.A3: U1.AF1 (IO_L8N_T1_34)
DDR.A4: U1.AE1 (IO_L8P_T1_34)
DDR.A5: U1.AF2 (IO_L7N_T1_34)
DDR.A6: U1.AF3 (IO_L7P_T1_34)
DDR.A7: U1.AC7 (IO_L6P_T0_34)
DDR.A8: U1.AE6 (IO_L5N_T0_34)
DDR.A9: U1.AD6 (IO_L5P_T0_34)
DDR.A10: U1.AC4 (IO_L4N_T0_34)
DDR.A11: U1.AC5 (IO_L4P_T0_34)
DDR.A12: U1.AC1 (IO_L2N_T0_34)
DDR.A13: U1.AC2 (IO_L2P_T0_34)
DDR.A14: U1.AD3 (IO_L1N_T0_34)
DDR.A15: U1.AD4 (IO_L1P_T0_34)
DDR.BA0: U1.AF5 (IO_L11N_T1_SRCC_34)
DDR.BA1: U1.AE5 (IO_L11P_T1_SRCC_34)
DDR.BA2: U1.AE3 (IO_L10N_T1_34)
DDR.CKE: U1.AH2 (IO_L16P_T2_34)
DDR.CK_N: U1.AD1 (IO_L3N_T0_DQS_34)
DDR.CK_P: U1.AD2 (IO_L3P_T0_DQS_34)
DDR.DM: U1.AF8 (IO_L19P_T3_34)
DDR.DQ0: U1.AK5 (IO_L24P_T3_34)
DDR.DQ1: U1.AK8 (IO_L23N_T3_34)
DDR.DQ2: U1.AK6 (IO_L22N_T3_34)
DDR.DQ3: U1.AJ6 (IO_L22P_T3_34)
DDR.DQ4: U1.AG7 (IO_L20N_T3_34)
DDR.DQ5: U1.AJ8 (IO_L23P_T3_34)
DDR.DQ6: U1.AK4 (IO_L24N_T3_34)
DDR.DQ7: U1.AF7 (IO_L20P_T3_34)
DDR.DQS_N: U1.AJ7 (IO_L21N_T3_DQS_34)
DDR.DQS_P: U1.AH7 (IO_L21P_T3_DQS_34)
DDR.ODT: U1.AJ2 (IO_L16N_T2_34)
DDR.~CAS: U1.AF6 (IO_L12P_T1_MRCC_34)
DDR.~CS: U1.AH1 (IO_L15N_T2_DQS_34)
DDR.~RAS: U1.AG5 (IO_L12N_T1_MRCC_34)
DDR.~RESET: U1.AH4 (IO_L13P_T2_MRCC_34)
DDR.~WE: U1.AG2 (IO_L15P_T2_DQS_34)
DDR_VRN: R339.2, U1.AC6 (IO_0_VRN_34)
DDR_VRP: R340.1, U1.AB7 (IO_25_VRP_34)
GND: C374.2, C375.2, R339.1
