kangyuzhe666/kintex-410t-devboard/fpga-config.kicad_sch

## KiCad design fpga-config.kicad_sch (2023-02-02)

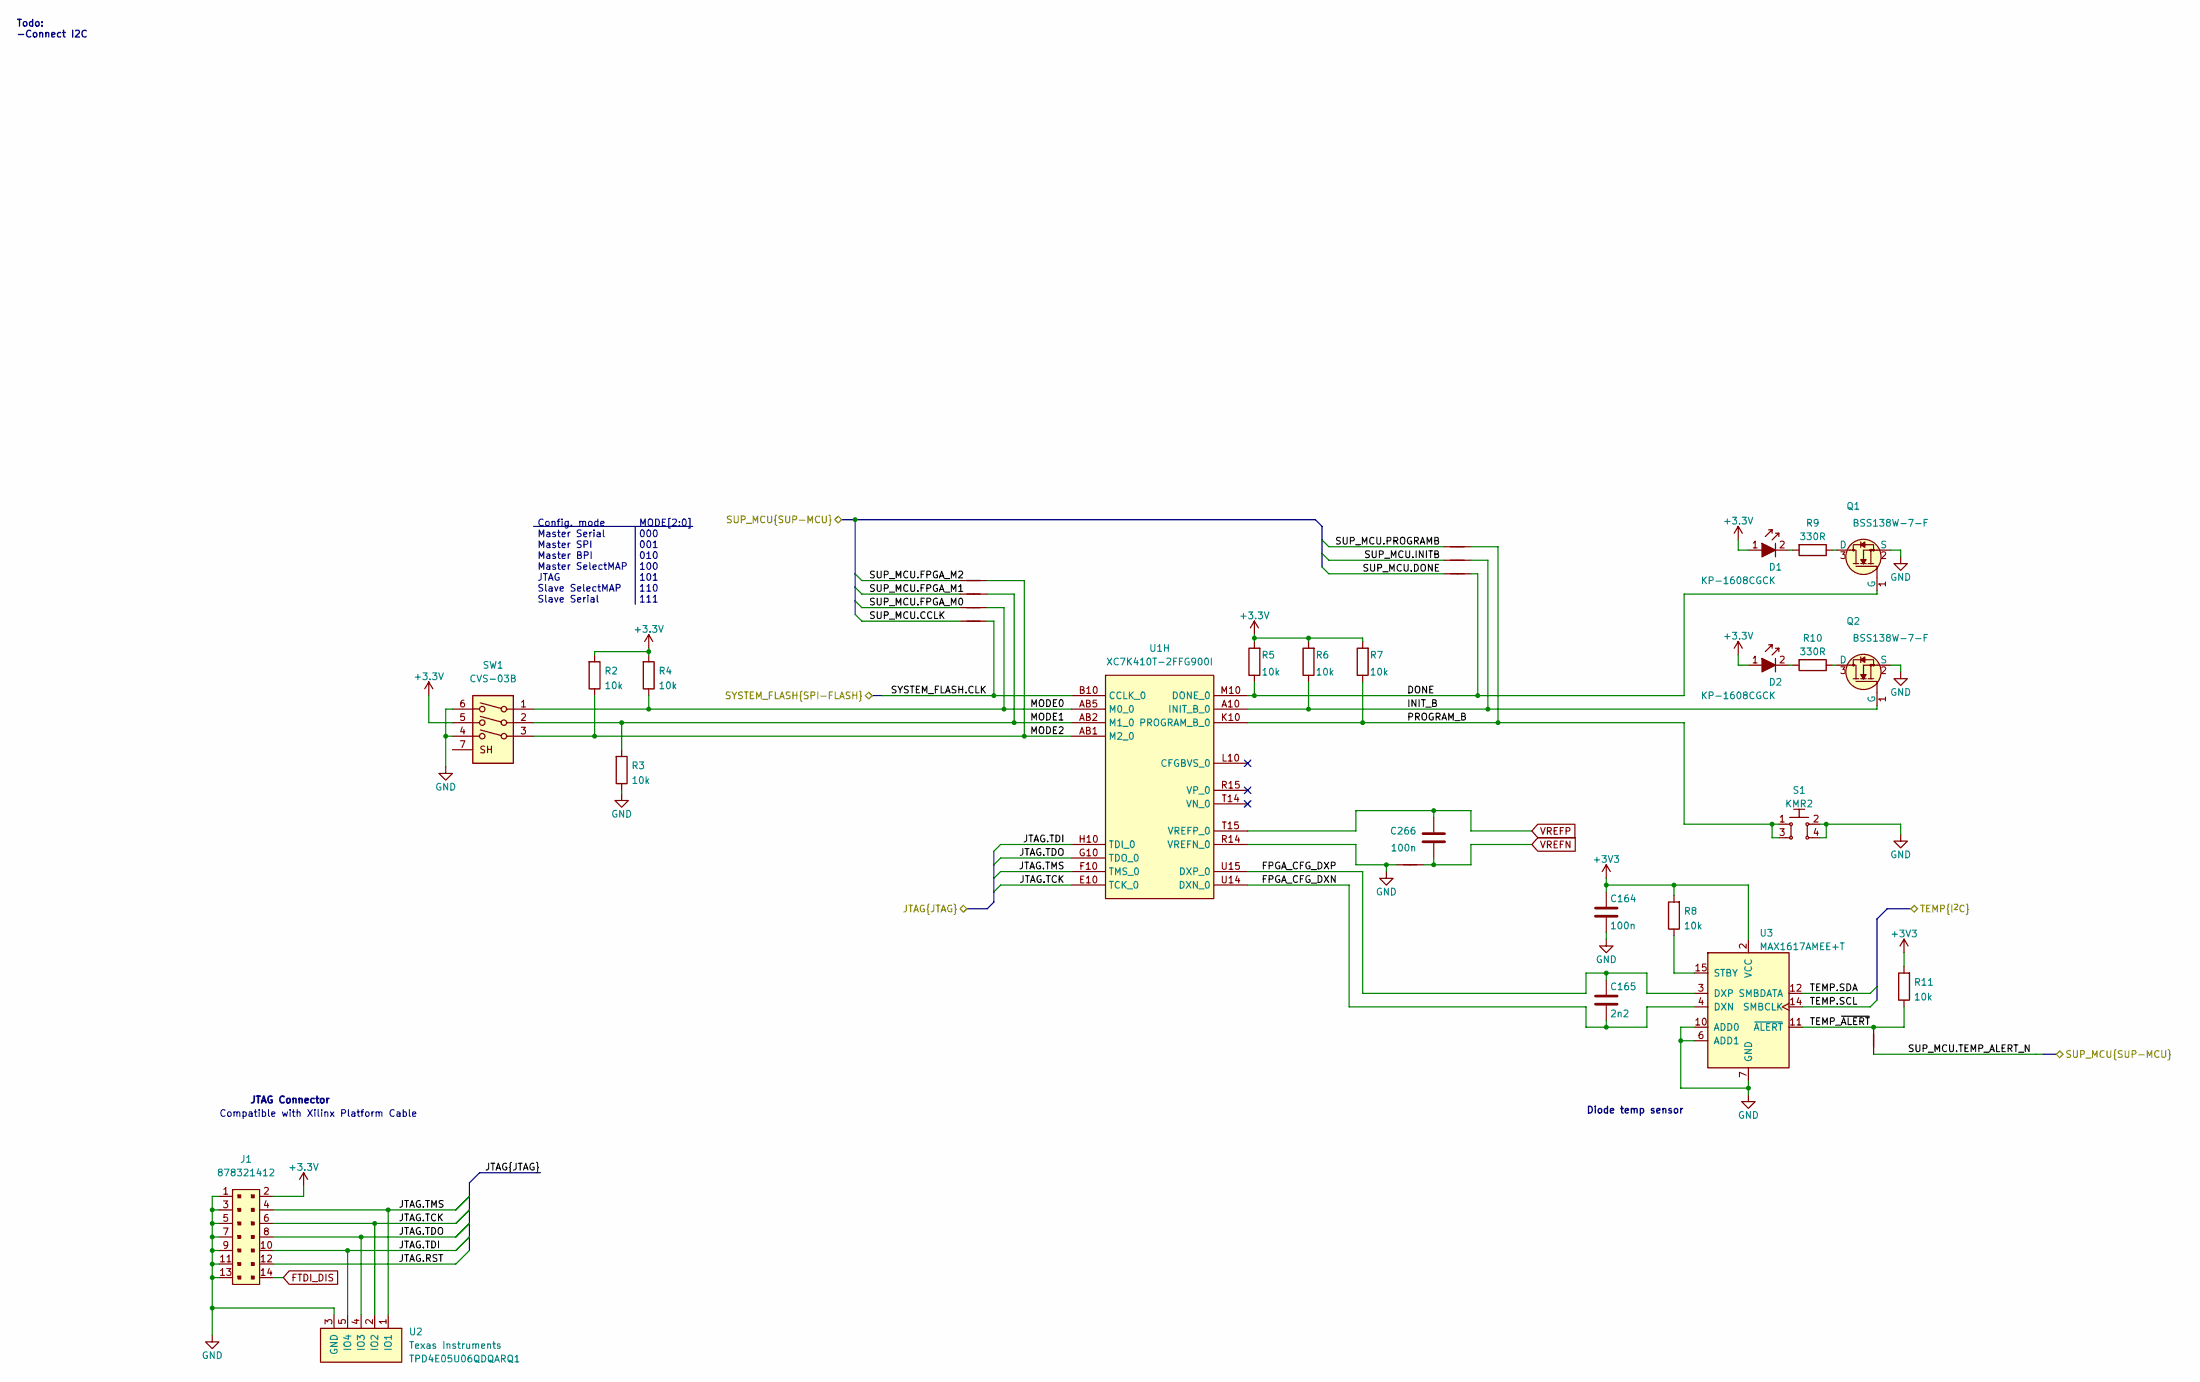
[picture p7: schematic fpga-config.kicad_sch]

Parts:
C164: C_100n_0402; 0402-cap; MPN GRM155R61H104KE14D
C165: C_2n2_0402; 0402-cap; MPN C0402C222J5RACTU
C266: C_100n_0201; 0201-cap; MPN CC0201KRX6S5BB104
D1, D2: KP-1608CGCK; LED_0603; MPN KP-1608CGCK
J1: 878321412; PinHeader_2x7_P2mm_SMD_no_locator; MPN 878321412
NT3, NT4, NT5, NT6, NT7, NT8, NT19, NT21, NT24: NetTie_2; NetTie-2_SMD_Pad0.127mm
Q1, Q2: BSS138W-7-F; SOT-323; MPN BSS138W-7-F
R2, R3, R4, R5, R6, R7, R8, R11: R_10k_0402; 0402-res; MPN CRCW040210K0FKEDHP
R9, R10: R_330R_0603; 0603-res; MPN CR0603-FX-3300GLF
S1: KMR2; SW_SPST_4.2x2.8; MPN KMR211NGLFS
SW1: CVS-03B; SW_DIP_SPSTx03_Slide_Copal_CVS-03xB_W5.9mm_P1mm; MPN CVS-03B
U1: XC7K410T-2FFG900I; xc7k410t-2ffg900I; MPN XC7K410T-2FFG900I
U2: TPD4E05U06QDQARQ1; USON-10_2.5x1.0mm_P0.5mm; MPN TPD4E05U06QDQARQ1
U3: MAX1617AMEE+T; QSOP-16_3.9x4.9mm_P0.635mm; MPN MAX1617AMEE+T

Connections:
+3.3V: D1.1, D2.1, J1.2, R2.2, R4.2, R5.2, R6.2, R7.2, SW1.5
+3V3: C164.1, R8.2, R11.2, U3.2 (VCC)
DONE: NT6.2, Q1.1 (G), R5.1, U1.M10 (DONE_0)
FPGA_CFG_DXN: C165.2, U1.U14 (DXN_0), U3.4 (DXN)
FPGA_CFG_DXP: C165.1, U1.U15 (DXP_0), U3.3 (DXP)
FTDI_DIS: J1.14
GND: C164.2, J1.1, J1.3, J1.5, J1.7, J1.9, J1.11, J1.13, NT24.2, Q1.2 (S), Q2.2 (S), R3.1, S1.2, S1.4, SW1.4, SW1.6, U1.R14 (VREFN_0), U2.3 (GND), U2.8 (GND), U3.6 (ADD1), U3.7 (GND), U3.8 (GND), U3.10 (ADD0)
INIT_B: NT7.2, Q2.1 (G), R6.1, U1.A10 (INIT_B_0)
JTAG.RST: J1.12
JTAG.TCK: J1.6, U1.E10 (TCK_0), U2.2 (IO2), U2.9 (IO2)
JTAG.TDI: J1.10, U1.H10 (TDI_0), U2.5 (IO4), U2.6 (IO4)
JTAG.TDO: J1.8, U1.G10 (TDO_0), U2.4 (IO3), U2.7 (IO3)
JTAG.TMS: J1.4, U1.F10 (TMS_0), U2.1 (IO1), U2.10 (IO1)
MODE0: NT3.2, R4.1, SW1.1, U1.AB5 (M0_0)
MODE1: NT4.2, R3.2, SW1.2, U1.AB2 (M1_0)
MODE2: NT5.2, R2.1, SW1.3, U1.AB1 (M2_0)
unnamed: D1.2, R9.2
unnamed: D2.2, R10.2
unnamed: Q1.3 (D), R9.1
unnamed: Q2.3 (D), R10.1
unnamed: R8.1, U3.15 (STBY)
unnamed: U3.1 (NC), U3.5 (NC), U3.9 (NC), U3.13 (NC), U3.16 (NC)
PROGRAM_B: NT8.2, R7.1, S1.1, S1.3, U1.K10 (PROGRAM_B_0)
SUP_MCU.CCLK: NT19.1
SUP_MCU.DONE: NT6.1
SUP_MCU.FPGA_M0: NT3.1
SUP_MCU.FPGA_M1: NT4.1
SUP_MCU.FPGA_M2: NT5.1
SUP_MCU.INITB: NT7.1
SUP_MCU.PROGRAMB: NT8.1
SUP_MCU.TEMP_ALERT_N: NT21.1
SYSTEM_FLASH.CLK: NT19.2, U1.B10 (CCLK_0)
TEMP.SCL: U3.14 (SMBCLK)
TEMP.SDA: U3.12 (SMBDATA)
TEMP_~ALERT: NT21.2, R11.1, U3.11 (~ALERT)
VREFN: C266.2, NT24.1
VREFP: C266.1, U1.T15 (VREFP_0)

Notes on the sheet:
JTAG Connector
Todo: -Connect I2C
Config. mode Master Serial Master SPI Master BPI Master SelectMAP JTAG Slave SelectMAP Slave Serial
Compatible with Xilinx Platform Cable
MODE[2:0] 000 001 010 100 101 110 111
Diode temp sensor
