kangyuzhe666/kintex-410t-devboard/fpga-supply.kicad_sch

## KiCad design fpga-supply.kicad_sch (2023-04-08)

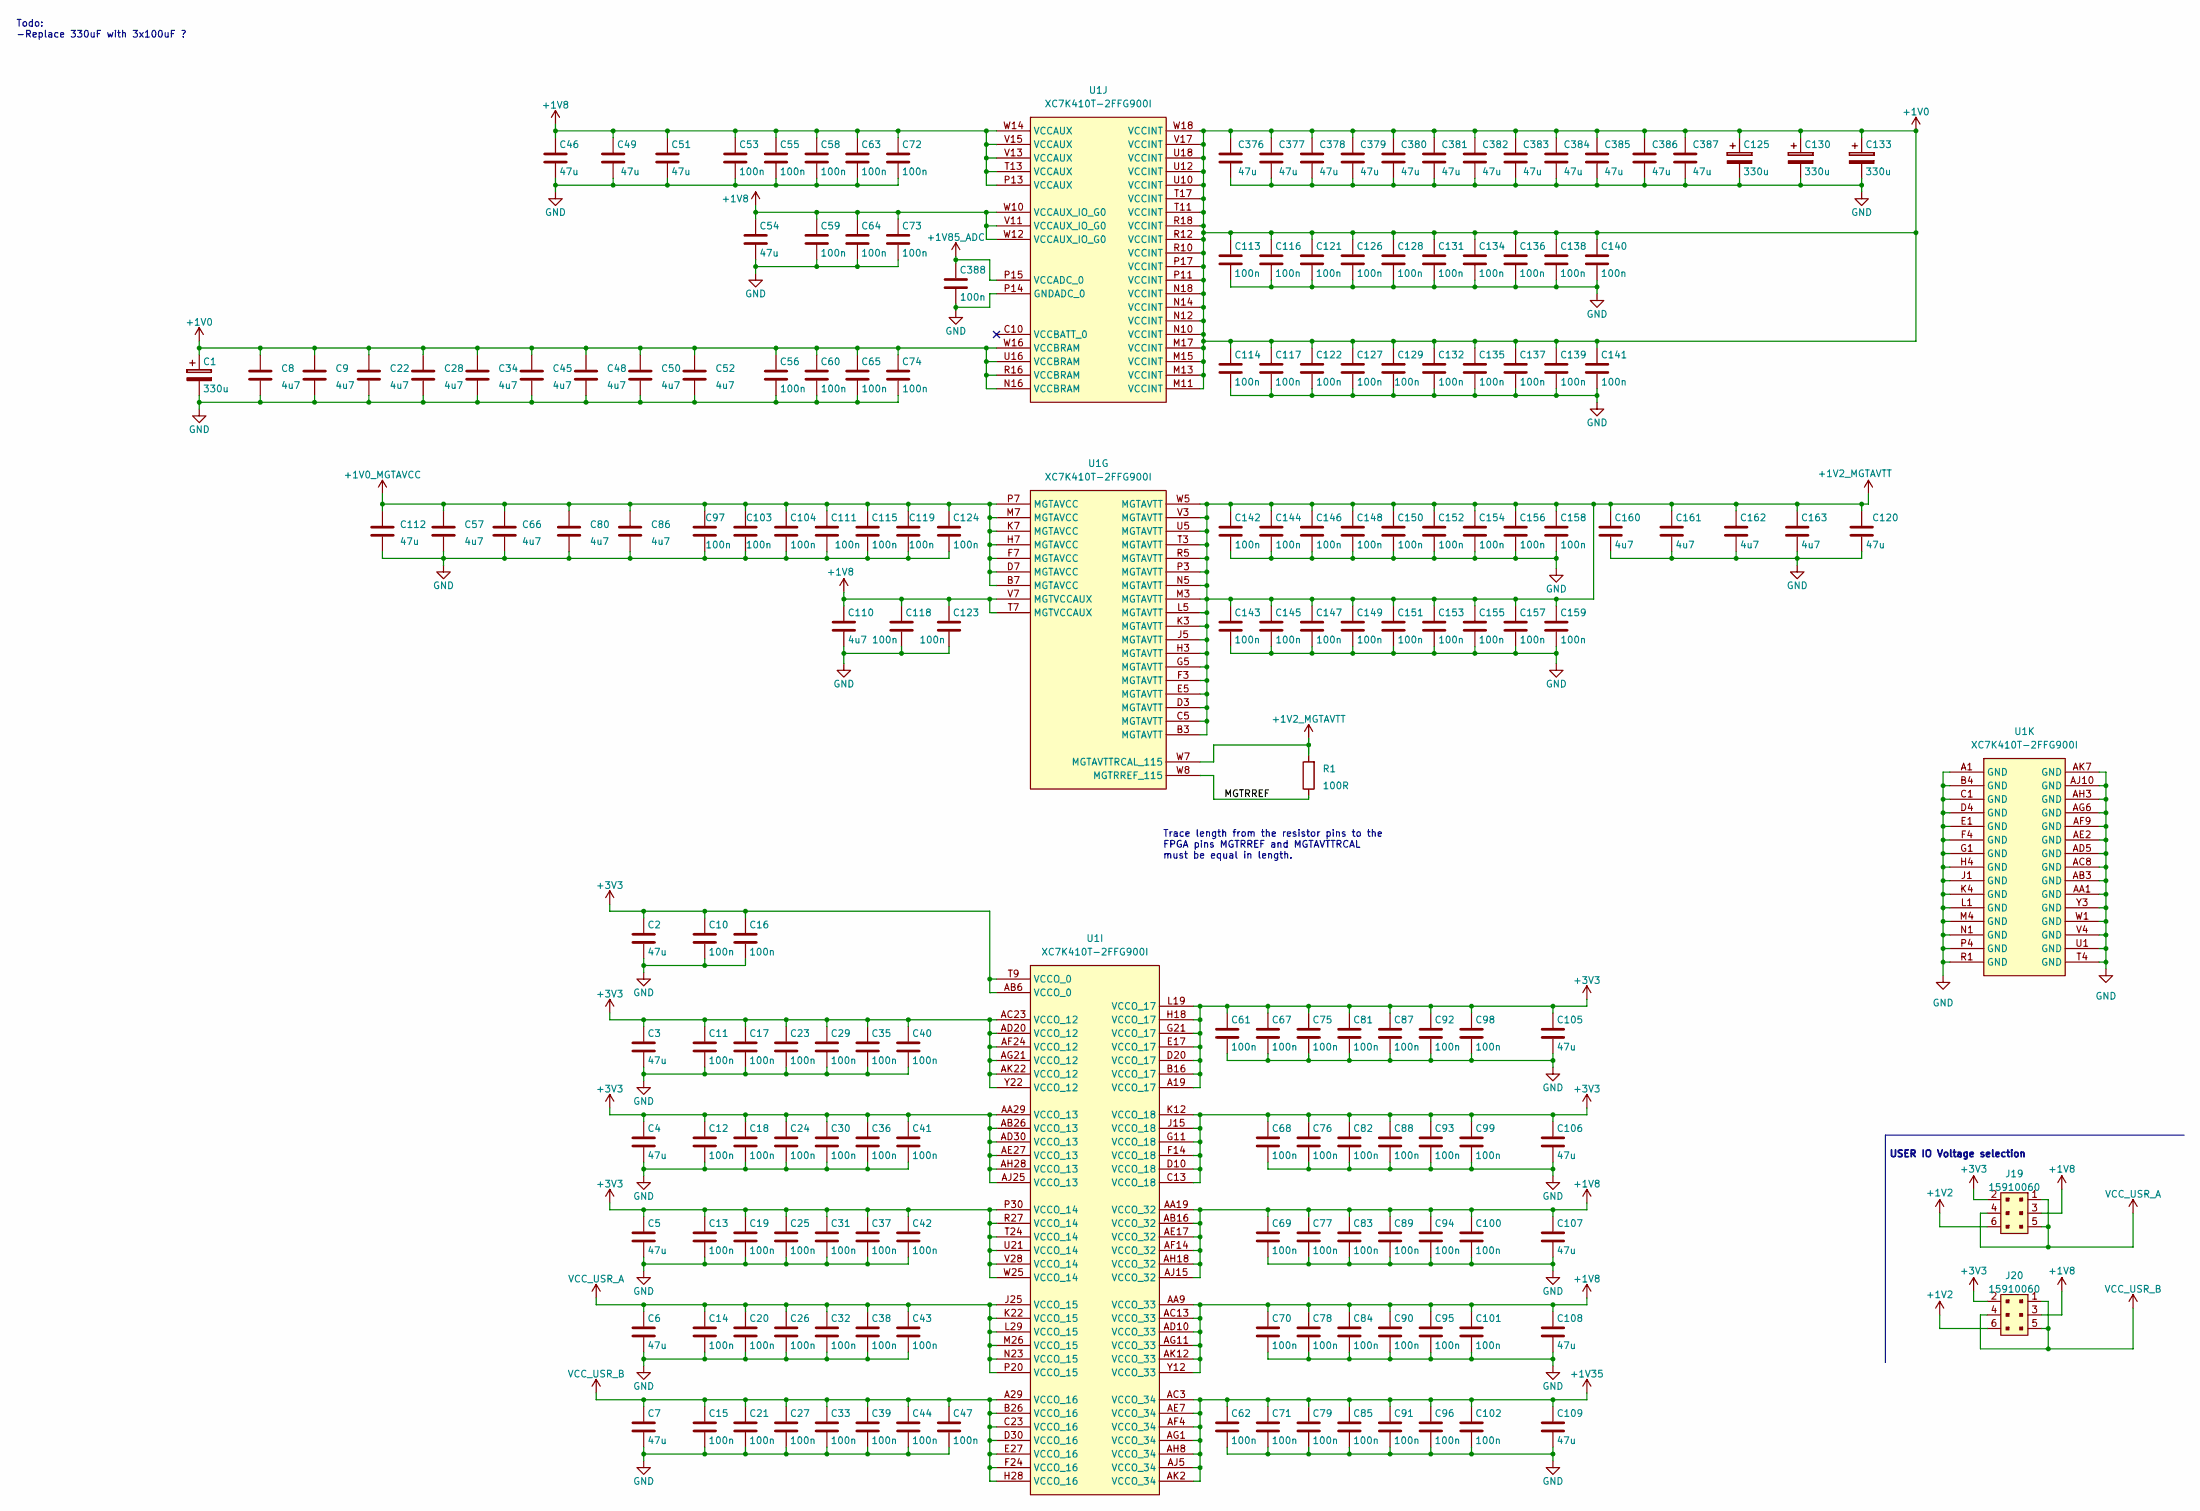
[picture p8: schematic fpga-supply.kicad_sch]

Parts:
C1, C125, C130, C133: C_330u_KEMET_B; KEMET_B; MPN T520B337M006ATE040
C2, C3, C4, C5, C6, C7, C46, C49, C51, C54, C105, C106, C107, C108, C109, C112, C120, C376, C377, C378, C379, C380, C381, C382, C383, C384, C385, C386, C387: C_47u_0603; 0603-cap; MPN GRM188R60J476ME15D
C8, C9, C22, C28, C34, C45, C48, C50, C52, C57, C66, C80, C86, C110, C160, C161, C162, C163: C_4u7_0201; 0201-cap; MPN GRM035R60J475ME15D
C10, C11, C12, C13, C14, C15, C16, C17, C18, C19, C20, C21, C23, C24, C25, C26, C27, C29, C30, C31, C32, C33, C35, C36, C37, C38, C39, C40, C41, C42, C43, C44, C47, C53, C55, C58, C59, C61, C62, C63, C64, C67, C68, C69, C70, C71, C72, C73, C75, C76, C77, C78, C79, C81, C82, C83, C84, C85, C87, C88, C89, C90, C91, C92, C93, C94, C95, C96, C98, C99, C100, C101, C102, C103, C111, C113, C114, C116, C117, C118, C119, C121, C123, C128, C131, C134, C136, C138, C140, C143, C155: C_100n_0402_EIA; 0402-cap_EIA; MPN GRM155R61H104KE14D
C56, C60, C65, C74, C97, C104, C115, C122, C124, C126, C127, C129, C132, C135, C137, C139, C141, C142, C144, C145, C146, C147, C148, C149, C150, C151, C152, C153, C154, C156, C157, C158, C159, C388: C_100n_0201; 0201-cap; MPN CC0201KRX6S5BB104
J19, J20: 15910060; MPN 15910060
R1: R_100R_0201; 0201-res; MPN CR0201AFW-1000GAS
U1: XC7K410T-2FFG900I; xc7k410t-2ffg900I; MPN XC7K410T-2FFG900I

Connections:
+1V0: C1.1, C8.1, C9.1, C22.1, C28.1, C34.1, C45.1, C48.1, C50.1, C52.1, C56.1, C60.1, C65.1, C74.1, C113.1, C114.1, C116.1, C117.1, C121.1, C122.1, C125.1, C126.1, C127.1, C128.1, C129.1, C130.1, C131.1, C132.1, C133.1, C134.1, C135.1, C136.1, C137.1, C138.1, C139.1, C140.1, C141.1, C376.1, C377.1, C378.1, C379.1, C380.1, C381.1, C382.1, C383.1, C384.1, C385.1, C386.1, C387.1, U1.M11 (VCCINT), U1.M13 (VCCINT), U1.M15 (VCCINT), U1.M17 (VCCINT), U1.N10 (VCCINT), U1.N12 (VCCINT), U1.N14 (VCCINT), U1.N16 (VCCBRAM), U1.N18 (VCCINT), U1.P11 (VCCINT), U1.P17 (VCCINT), U1.R10 (VCCINT), U1.R12 (VCCINT), U1.R16 (VCCBRAM), U1.R18 (VCCINT), U1.T11 (VCCINT), U1.T17 (VCCINT), U1.U10 (VCCINT), U1.U12 (VCCINT), U1.U16 (VCCBRAM), U1.U18 (VCCINT), U1.V17 (VCCINT), U1.W16 (VCCBRAM), U1.W18 (VCCINT)
+1V0_MGTAVCC: C57.1, C66.1, C80.1, C86.1, C97.1, C103.1, C104.1, C111.1, C112.1, C115.1, C119.1, C124.1, U1.B7 (MGTAVCC), U1.D7 (MGTAVCC), U1.F7 (MGTAVCC), U1.H7 (MGTAVCC), U1.K7 (MGTAVCC), U1.M7 (MGTAVCC), U1.P7 (MGTAVCC)
+1V2: J19.6, J20.6
+1V2_MGTAVTT: C120.1, C142.1, C143.1, C144.1, C145.1, C146.1, C147.1, C148.1, C149.1, C150.1, C151.1, C152.1, C153.1, C154.1, C155.1, C156.1, C157.1, C158.1, C159.1, C160.1, C161.1, C162.1, C163.1, R1.2, U1.B3 (MGTAVTT), U1.C5 (MGTAVTT), U1.D3 (MGTAVTT), U1.E5 (MGTAVTT), U1.F3 (MGTAVTT), U1.G5 (MGTAVTT), U1.H3 (MGTAVTT), U1.J5 (MGTAVTT), U1.K3 (MGTAVTT), U1.L5 (MGTAVTT), U1.M3 (MGTAVTT), U1.N5 (MGTAVTT), U1.P3 (MGTAVTT), U1.R5 (MGTAVTT), U1.T3 (MGTAVTT), U1.U5 (MGTAVTT), U1.V3 (MGTAVTT), U1.W5 (MGTAVTT), U1.W7 (MGTAVTTRCAL_115)
+1V8: C46.1, C49.1, C51.1, C53.1, C54.1, C55.1, C58.1, C59.1, C63.1, C64.1, C69.1, C70.1, C72.1, C73.1, C77.1, C78.1, C83.1, C84.1, C89.1, C90.1, C94.1, C95.1, C100.1, C101.1, C107.1, C108.1, C110.1, C118.1, C123.1, J19.3, J20.3, U1.AA9 (VCCO_33), U1.AA19 (VCCO_32), U1.AB16 (VCCO_32), U1.AC13 (VCCO_33), U1.AD10 (VCCO_33), U1.AE17 (VCCO_32), U1.AF14 (VCCO_32), U1.AG11 (VCCO_33), U1.AH18 (VCCO_32), U1.AJ15 (VCCO_32), U1.AK12 (VCCO_33), U1.P13 (VCCAUX), U1.T7 (MGTVCCAUX), U1.T13 (VCCAUX), U1.V7 (MGTVCCAUX), U1.V11 (VCCAUX_IO_G0), U1.V13 (VCCAUX), U1.V15 (VCCAUX), U1.W10 (VCCAUX_IO_G0), U1.W12 (VCCAUX_IO_G0), U1.W14 (VCCAUX), U1.Y12 (VCCO_33)
+1V35: C62.1, C71.1, C79.1, C85.1, C91.1, C96.1, C102.1, C109.1, U1.AC3 (VCCO_34), U1.AE7 (VCCO_34), U1.AF4 (VCCO_34), U1.AG1 (VCCO_34), U1.AH8 (VCCO_34), U1.AJ5 (VCCO_34), U1.AK2 (VCCO_34)
+1V85_ADC: C388.1, U1.P15 (VCCADC_0)
+3V3: C2.1, C3.1, C4.1, C5.1, C10.1, C11.1, C12.1, C13.1, C16.1, C17.1, C18.1, C19.1, C23.1, C24.1, C25.1, C29.1, C30.1, C31.1, C35.1, C36.1, C37.1, C40.1, C41.1, C42.1, C61.1, C67.1, C68.1, C75.1, C76.1, C81.1, C82.1, C87.1, C88.1, C92.1, C93.1, C98.1, C99.1, C105.1, C106.1, J19.2, J20.2, U1.A19 (VCCO_17), U1.AA29 (VCCO_13), U1.AB6 (VCCO_0), U1.AB26 (VCCO_13), U1.AC23 (VCCO_12), U1.AD20 (VCCO_12), U1.AD30 (VCCO_13), U1.AE27 (VCCO_13), U1.AF24 (VCCO_12), U1.AG21 (VCCO_12), U1.AH28 (VCCO_13), U1.AJ25 (VCCO_13), U1.AK22 (VCCO_12), U1.B16 (VCCO_17), U1.C13 (VCCO_18), U1.D10 (VCCO_18), U1.D20 (VCCO_17), U1.E17 (VCCO_17), U1.F14 (VCCO_18), U1.G11 (VCCO_18), U1.G21 (VCCO_17), U1.H18 (VCCO_17), U1.J15 (VCCO_18), U1.K12 (VCCO_18), U1.L19 (VCCO_17), U1.P30 (VCCO_14), U1.R27 (VCCO_14), U1.T9 (VCCO_0), U1.T24 (VCCO_14), U1.U21 (VCCO_14), U1.V28 (VCCO_14), U1.W25 (VCCO_14), U1.Y22 (VCCO_12)
GND: C1.2, C2.2, C3.2, C4.2, C5.2, C6.2, C7.2, C8.2, C9.2, C10.2, C11.2, C12.2, C13.2, C14.2, C15.2, C16.2, C17.2, C18.2, C19.2, C20.2, C21.2, C22.2, C23.2, C24.2, C25.2, C26.2, C27.2, C28.2, C29.2, C30.2, C31.2, C32.2, C33.2, C34.2, C35.2, C36.2, C37.2, C38.2, C39.2, C40.2, C41.2, C42.2, C43.2, C44.2, C45.2, C46.2, C47.2, C48.2, C49.2, C50.2, C51.2, C52.2, C53.2, C54.2, C55.2, C56.2, C57.2, C58.2, C59.2, C60.2, C61.2, C62.2, C63.2, C64.2, C65.2, C66.2, C67.2, C68.2, C69.2, C70.2, C71.2, C72.2, C73.2, C74.2, C75.2, C76.2, C77.2, C78.2, C79.2, C80.2, C81.2, C82.2, C83.2, C84.2, C85.2, C86.2, C87.2, C88.2, C89.2, C90.2, C91.2, C92.2, C93.2, C94.2, C95.2, C96.2, C97.2, C98.2, C99.2, C100.2, C101.2, C102.2, C103.2, C104.2, C105.2, C106.2, C107.2, C108.2, C109.2, C110.2, C111.2, C112.2, C113.2, C114.2, C115.2, C116.2, C117.2, C118.2, C119.2, C120.2, C121.2, C122.2, C123.2, C124.2, C125.2, C126.2, C127.2, C128.2, C129.2, C130.2, C131.2, C132.2, C133.2, C134.2, C135.2, C136.2, C137.2, C138.2, C139.2, C140.2, C141.2, C142.2, C143.2, C144.2, C145.2, C146.2, C147.2, C148.2, C149.2, C150.2, C151.2, C152.2, C153.2, C154.2, C155.2, C156.2, C157.2, C158.2, C159.2, C160.2, C161.2, C162.2, C163.2, C376.2, C377.2, C378.2, C379.2, C380.2, C381.2, C382.2, C383.2, C384.2, C385.2, C386.2, C387.2, C388.2, U1.A1 (GND), U1.A2 (GND), U1.A5 (GND), U1.A6 (GND), U1.A9 (GND), U1.A14 (GND), U1.A24 (GND), U1.AA1 (GND), U1.AA2 (GND), U1.AA5 (GND), U1.AA6 (GND), U1.AA7 (GND), U1.AA14 (GND), U1.AA24 (GND), U1.AB3 (GND), U1.AB4 (GND), U1.AB11 (GND), U1.AB21 (GND), U1.AC8 (GND), U1.AC18 (GND), U1.AC28 (GND), U1.AD5 (GND), U1.AD15 (GND), U1.AD25 (GND), U1.AE2 (GND), U1.AE12 (GND), U1.AE22 (GND), U1.AF9 (GND), U1.AF19 (GND), U1.AF29 (GND), U1.AG6 (GND), U1.AG16 (GND), U1.AG26 (GND), U1.AH3 (GND), U1.AH13 (GND), U1.AH23 (GND), U1.AJ10 (GND), U1.AJ20 (GND), U1.AJ30 (GND), U1.AK7 (GND), U1.AK17 (GND), U1.AK27 (GND), U1.B4 (GND), U1.B8 (GND), U1.B9 (GND), U1.B11 (GND), U1.B21 (GND), U1.C1 (GND), U1.C2 (GND), U1.C6 (GND), U1.C9 (GND), U1.C18 (GND), U1.C28 (GND), U1.D4 (GND), U1.D8 (GND), U1.D9 (GND), U1.D15 (GND), U1.D25 (GND), U1.E1 (GND), U1.E2 (GND), U1.E6 (GND), U1.E9 (GND), U1.E12 (GND), U1.E22 (GND), U1.F4 (GND), U1.F8 (GND), U1.F9 (GND), U1.F19 (GND), U1.F29 (GND), U1.G1 (GND), U1.G2 (GND), U1.G6 (GND), U1.G9 (GND), U1.G16 (GND), U1.G26 (GND), U1.H4 (GND), U1.H8 (GND), U1.H9 (GND), U1.H13 (GND), U1.H23 (GND), U1.J1 (GND), U1.J2 (GND), U1.J6 (GND), U1.J9 (GND), U1.J10 (GND), U1.J20 (GND), U1.J30 (GND), U1.K4 (GND), U1.K8 (GND), U1.K9 (GND), U1.K17 (GND), U1.K27 (GND), U1.L1 (GND), U1.L2 (GND), U1.L6 (GND), U1.L9 (GND), U1.L14 (GND), U1.L24 (GND), U1.M4 (GND), U1.M8 (GND), U1.M9 (GND), U1.M12 (GND), U1.M14 (GND), U1.M16 (GND), U1.M18 (GND), U1.M21 (GND), U1.N1 (GND), U1.N2 (GND), U1.N6 (GND), U1.N9 (GND), U1.N11 (GND), U1.N13 (GND), U1.N15 (GND), U1.N17 (GND), U1.N28 (GND), U1.P4 (GND), U1.P8 (GND), U1.P9 (GND), U1.P10 (GND), U1.P12 (GND), U1.P14 (GNDADC_0), U1.P16 (GND), U1.P18 (GND), U1.P25 (GND), U1.R1 (GND), U1.R2 (GND), U1.R6 (GND), U1.R9 (GND), U1.R11 (GND), U1.R13 (GND), U1.R17 (GND), U1.R22 (GND), U1.T4 (GND), U1.T8 (GND), U1.T10 (GND), U1.T12 (GND), U1.T16 (GND), U1.T18 (GND), U1.T19 (GND), U1.T29 (GND), U1.U1 (GND), U1.U2 (GND), U1.U6 (GND), U1.U9 (GND), U1.U11 (GND), U1.U13 (GND), U1.U17 (GND), U1.U26 (GND), U1.V4 (GND), U1.V8 (GND), U1.V9 (GND), U1.V10 (GND), U1.V12 (GND), U1.V14 (GND), U1.V16 (GND), U1.V18 (GND), U1.V23 (GND), U1.W1 (GND), U1.W2 (GND), U1.W6 (GND), U1.W9 (GND), U1.W11 (GND), U1.W13 (GND), U1.W15 (GND), U1.W17 (GND), U1.W20 (GND), U1.W30 (GND), U1.Y3 (GND), U1.Y4 (GND), U1.Y7 (GND), U1.Y8 (GND), U1.Y9 (GND), U1.Y17 (GND), U1.Y27 (GND)
MGTRREF: R1.1, U1.W8 (MGTRREF_115)
VCC_USR_A: C6.1, C14.1, C20.1, C26.1, C32.1, C38.1, C43.1, J19.1, J19.4, J19.5, U1.J25 (VCCO_15), U1.K22 (VCCO_15), U1.L29 (VCCO_15), U1.M26 (VCCO_15), U1.N23 (VCCO_15), U1.P20 (VCCO_15)
VCC_USR_B: C7.1, C15.1, C21.1, C27.1, C33.1, C39.1, C44.1, C47.1, J20.1, J20.4, J20.5, U1.A29 (VCCO_16), U1.B26 (VCCO_16), U1.C23 (VCCO_16), U1.D30 (VCCO_16), U1.E27 (VCCO_16), U1.F24 (VCCO_16), U1.H28 (VCCO_16)

Notes on the sheet:
Trace length from the resistor pins to the FPGA pins MGTRREF and MGTAVTTRCAL must be equal in length.
Todo: -Replace 330uF with 3x100uF ?
USER IO Voltage selection
