kangyuzhe666/kintex-410t-devboard/hdmi-ethernet.kicad_sch

## KiCad design hdmi-ethernet.kicad_sch (2023-04-08)

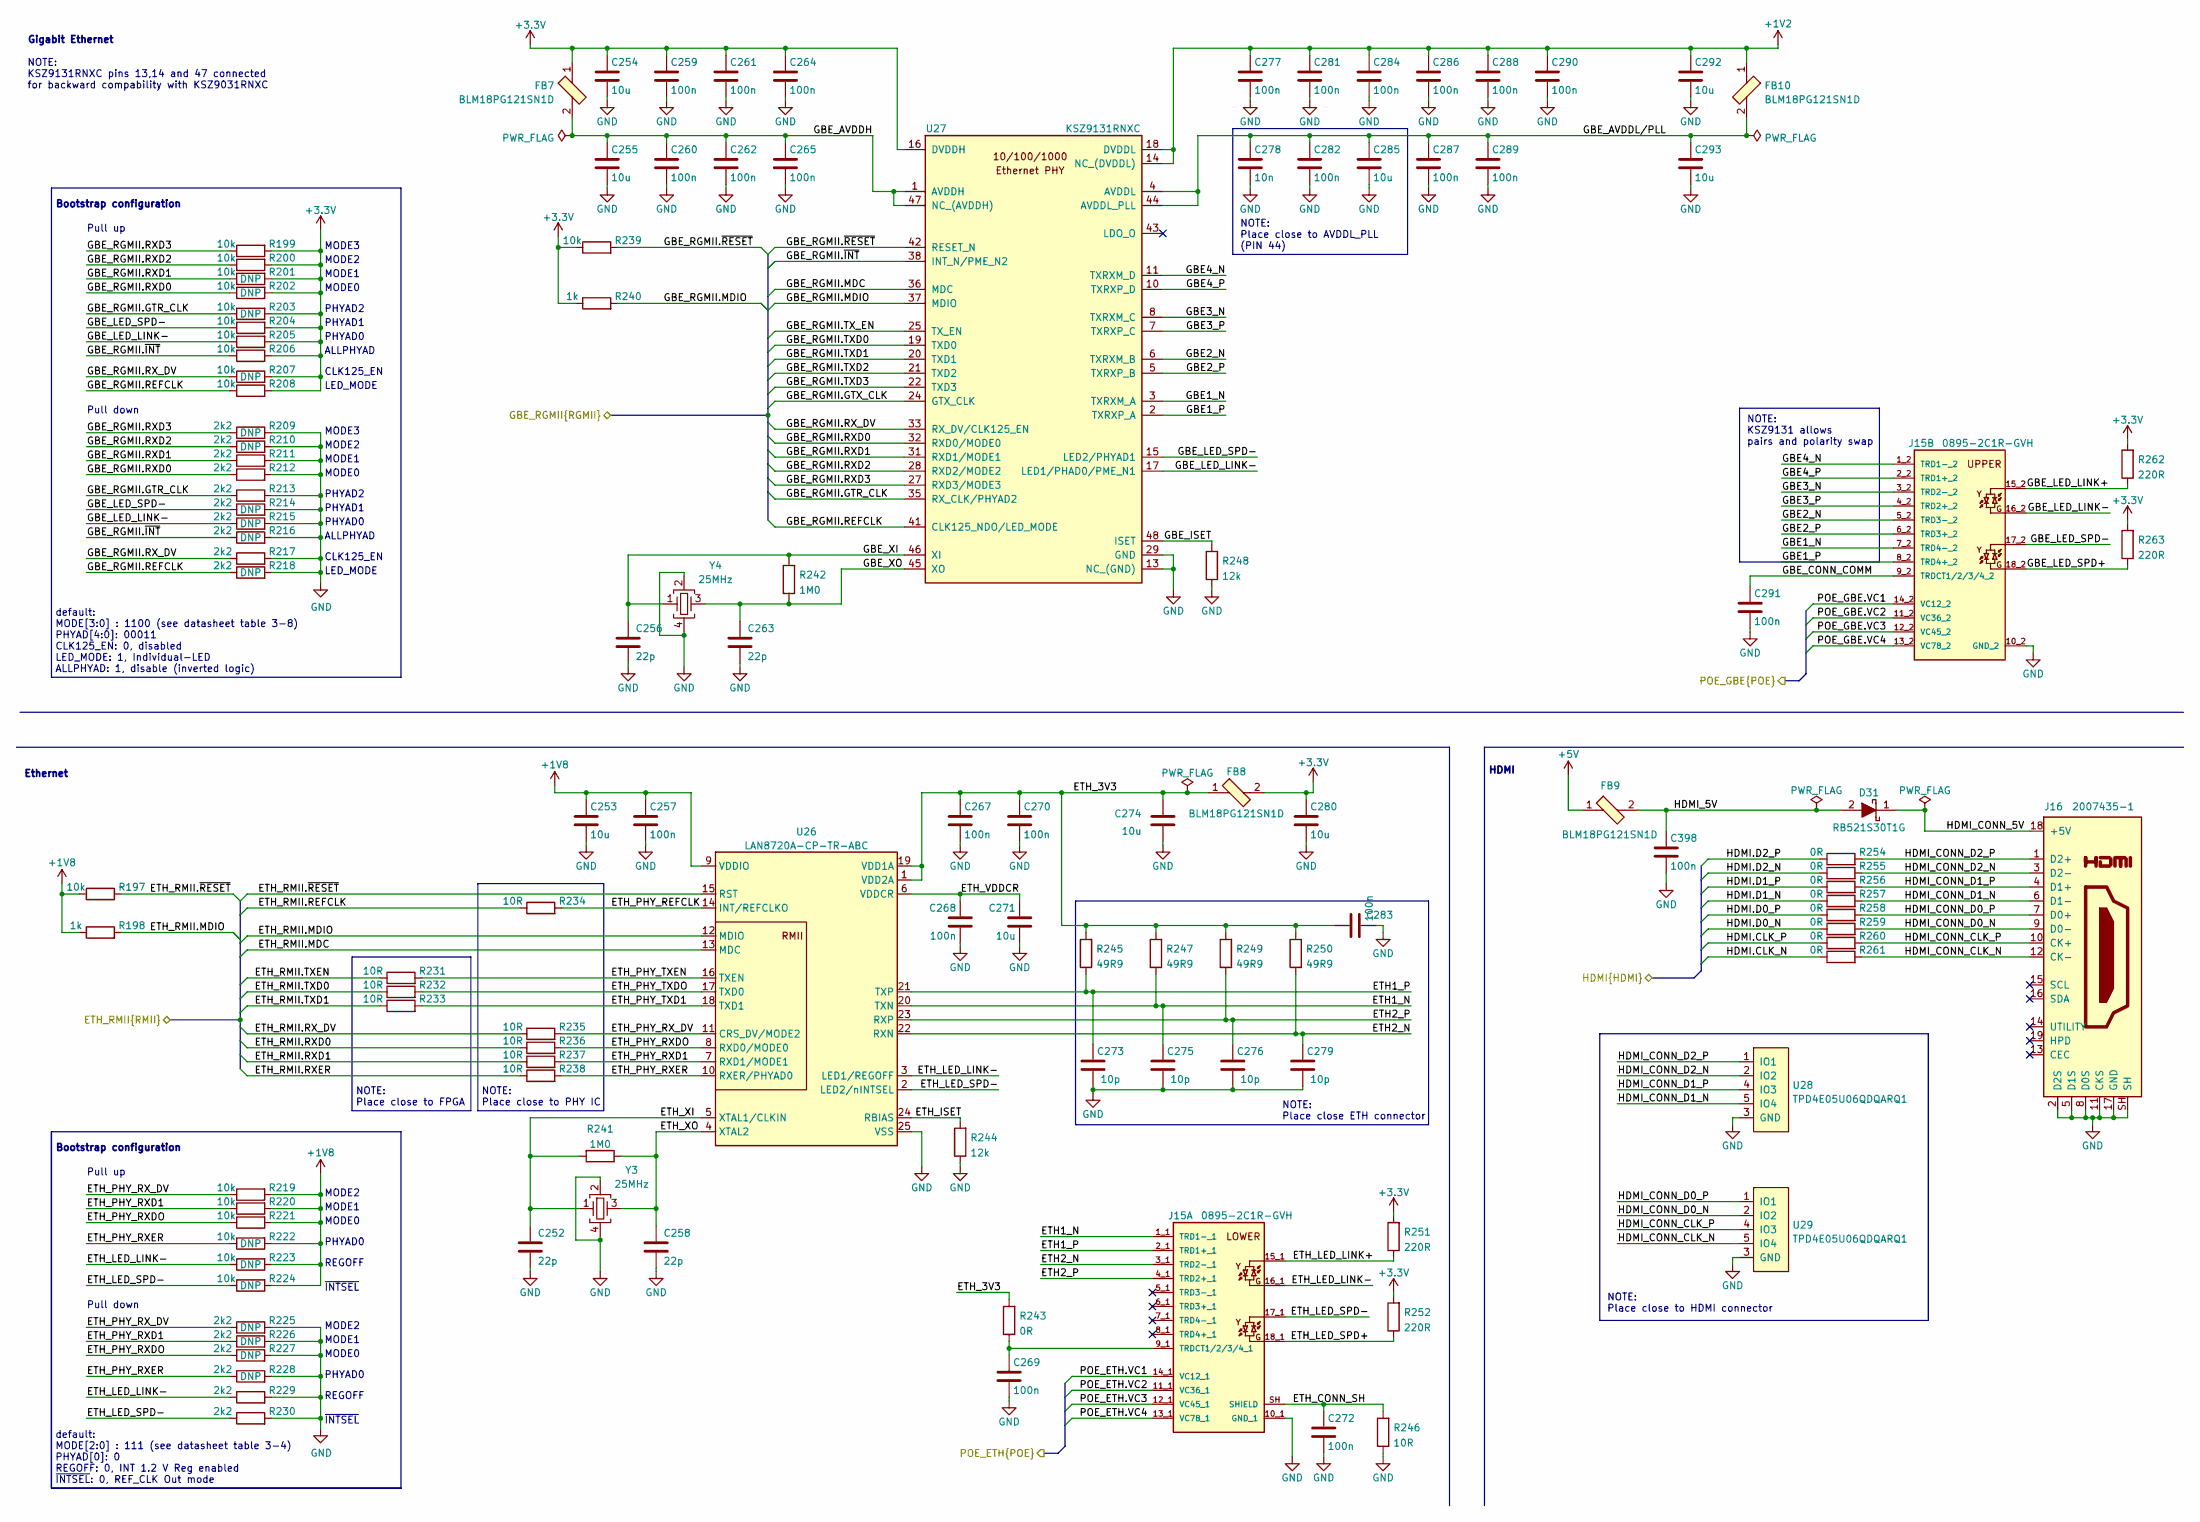
[picture p9: schematic hdmi-ethernet.kicad_sch]

Parts:
C252, C256, C258, C263: C_22p_0402; 0402-cap; MPN CC0402JRNPO9BN220
C253, C254, C255, C271, C274, C280, C285, C292, C293: C_10u_0402; 0402-cap; MPN CC0402MRX5R5BB106
C257, C259, C260, C261, C262, C264, C265, C267, C268, C269, C270, C272, C277, C281, C282, C283, C284, C286, C287, C288, C289, C290, C291, C398: C_100n_0402_EIA; 0402-cap_EIA; MPN GRM155R61H104KE14D
C273, C275, C276, C279: C_10p_0402; 0402-cap; MPN MC0402N100D500CT
C278: C_10n_0402; 0402-cap; MPN 04025G103ZAT2A
D31: RB521S30T1G; SOD-523; MPN RB521S30T1G
FB7, FB8, FB9, FB10: BLM18PG121SN1D; 0603-res; MPN BLM18PG121SN1D
J15: 0895-2C1R-GVH; MPN 0895-2C1R-GVH
J16: 2007435-1; TE_2007435-1; MPN 2007435-1
R197, R199, R200, R201, R202, R203, R204, R205, R206, R207, R208, R219, R220, R221, R222, R223, R224, R239: R_10k_0402; 0402-res; MPN CRCW040210K0FKEDHP
R198, R240: R_1k_0402; 0402-res; MPN CR0402-FX-1001GLF
R209, R210, R211, R212, R213, R214, R215, R216, R217, R218, R225, R226, R227, R228, R229, R230: R_2k2_0402; 0402-res; MPN RC0402FR-072K2L
R231, R232, R233, R234, R235, R236, R237, R238: R_10R_1%_0402; 0402-res; MPN CR0402-FX-10R0GLF
R241, R242: R_1M0_0402; 0402-res; MPN CRG0402F1M0
R243, R254, R255, R256, R257, R258, R259, R260, R261: R_0R_0402; 0402-res; MPN ERJ2GE0R00X
R244, R248: R_12k_0402; 0402-res; MPN CRCW040212K0FKEDHP
R245, R247, R249, R250: R_49R9_0402; 0402-res; MPN CRCW040249R9FKED
R246: R_10R_0603; 0603-res; MPN MCWR06X10R0FTL
R251, R252, R262, R263: R_220R_0603; 0603-res; MPN MCMR06X2200FTL
U26: LAN8720A-CP-TR-ABC; QFN-24-1EP_4x4mm_P0.5mm_EP2.6x2.6mm; MPN LAN8720A-CP-TR-ABC
U27: KSZ9131RNXC; QFN-48-Microchip-QFN77-48LD-PL-2; MPN KSZ9131RNXC
U28, U29: TPD4E05U06QDQARQ1; USON-10_2.5x1.0mm_P0.5mm; MPN TPD4E05U06QDQARQ1
Y3, Y4: ABM8G-25.000MHZ-18-D2Y-T; KX-7; MPN ABM8G-25.000MHZ-18-D2Y-T

Connections:
+1V2: C277.1, C281.1, C284.1, C286.1, C288.1, C290.1, C292.1, FB10.1, U27.14 (NC_(DVDDL)), U27.18 (DVDDL), U27.23 (DVDDL), U27.26 (DVDDL), U27.30 (DVDDL), U27.39 (DVDDL)
+1V8: C253.1, C257.1, R197.1, R198.1, R219.2, R220.2, R221.2, R222.2, R223.2, R224.2, U26.9 (VDDIO)
+3.3V: C254.1, C259.1, C261.1, C264.1, C280.1, FB7.1, FB8.2, R199.2, R200.2, R201.2, R202.2, R203.2, R204.2, R205.2, R206.2, R207.2, R208.2, R239.1, R240.1, R251.2, R252.2, R262.2, R263.2, U27.16 (DVDDH), U27.34 (DVDDH), U27.40 (DVDDH)
+5V: FB9.1
ETH1_N: C275.1, J15.1_1 (TRD1-_1), R247.1, U26.20 (TXN)
ETH1_P: C273.1, J15.2_1 (TRD1+_1), R245.1, U26.21 (TXP)
ETH2_N: C279.1, J15.3_1 (TRD2-_1), R250.1, U26.22 (RXN)
ETH2_P: C276.1, J15.4_1 (TRD2+_1), R249.1, U26.23 (RXP)
ETH_3V3: C267.1, C270.1, C274.1, C283.1, FB8.1, R243.2, R245.2, R247.2, R249.2, R250.2, U26.1 (VDD2A), U26.19 (VDD1A)
ETH_CONN_SH: C272.1, J15.SH (SHIELD), R246.2
ETH_ISET: R244.2, U26.24 (RBIAS)
ETH_LED_LINK+: J15.15_1, R251.1
ETH_LED_LINK-: J15.16_1, R223.1, R229.1, U26.3 (LED1/REGOFF)
ETH_LED_SPD+: J15.18_1, R252.1
ETH_LED_SPD-: J15.17_1, R224.1, R230.1, U26.2 (LED2/nINTSEL)
ETH_PHY_REFCLK: R234.2, U26.14 (INT/REFCLKO)
ETH_PHY_RXD1: R220.1, R226.1, R237.2, U26.7 (RXD1/MODE1)
ETH_PHY_RXDO: R221.1, R227.1, R236.2, U26.8 (RXD0/MODE0)
ETH_PHY_RXER: R222.1, R228.1, R238.2, U26.10 (RXER/PHYAD0)
ETH_PHY_RX_DV: R219.1, R225.1, R235.2, U26.11 (CRS_DV/MODE2)
ETH_PHY_TXD1: R233.2, U26.18 (TXD1)
ETH_PHY_TXDO: R232.2, U26.17 (TXD0)
ETH_PHY_TXEN: R231.2, U26.16 (TXEN)
ETH_RMII.MDC: U26.13 (MDC)
ETH_RMII.MDIO: R198.2, U26.12 (MDIO)
ETH_RMII.REFCLK: R234.1
ETH_RMII.RXD0: R236.1
ETH_RMII.RXD1: R237.1
ETH_RMII.RXER: R238.1
ETH_RMII.RX_DV: R235.1
ETH_RMII.TXD0: R232.1
ETH_RMII.TXD1: R233.1
ETH_RMII.TXEN: R231.1
ETH_RMII.~RESET: R197.2, U26.15 (RST)
ETH_VDDCR: C268.1, C271.1, U26.6 (VDDCR)
ETH_XI: C252.1, R241.2, U26.5 (XTAL1/CLKIN), Y3.1
ETH_XO: C258.1, R241.1, U26.4 (XTAL2), Y3.3
GBE1_N: J15.7_2 (TRD4-_2), U27.3 (TXRXM_A)
GBE1_P: J15.8_2 (TRD4+_2), U27.2 (TXRXP_A)
GBE2_N: J15.5_2 (TRD3-_2), U27.6 (TXRXM_B)
GBE2_P: J15.6_2 (TRD3+_2), U27.5 (TXRXP_B)
GBE3_N: J15.3_2 (TRD2-_2), U27.8 (TXRXM_C)
GBE3_P: J15.4_2 (TRD2+_2), U27.7 (TXRXP_C)
GBE4_N: J15.1_2 (TRD1-_2), U27.11 (TXRXM_D)
GBE4_P: J15.2_2 (TRD1+_2), U27.10 (TXRXP_D)
GBE_AVDDH: C255.1, C260.1, C262.1, C265.1, FB7.2, U27.1 (AVDDH), U27.12 (AVDDH), U27.47 (NC_(AVDDH))
GBE_AVDDL/PLL: C278.1, C282.1, C285.1, C287.1, C289.1, C293.1, FB10.2, U27.4 (AVDDL), U27.9 (AVDDL), U27.44 (AVDDL_PLL)
GBE_CONN_COMM: C291.1, J15.9_2 (TRDCT1/2/3/4_2)
GBE_ISET: R248.2, U27.48 (ISET)
GBE_LED_LINK+: J15.15_2, R262.1
GBE_LED_LINK-: J15.16_2, R205.1, R215.1, U27.17 (LED1/PHAD0/PME_N1)
GBE_LED_SPD+: J15.18_2, R263.1
GBE_LED_SPD-: J15.17_2, R204.1, R214.1, U27.15 (LED2/PHYAD1)
GBE_RGMII.GTR_CLK: R203.1, R213.1, U27.35 (RX_CLK/PHYAD2)
GBE_RGMII.GTX_CLK: U27.24 (GTX_CLK)
GBE_RGMII.MDC: U27.36 (MDC)
GBE_RGMII.MDIO: R240.2, U27.37 (MDIO)
GBE_RGMII.REFCLK: R208.1, R218.1, U27.41 (CLK125_NDO/LED_MODE)
GBE_RGMII.RXD0: R202.1, R212.1, U27.32 (RXD0/MODE0)
GBE_RGMII.RXD1: R201.1, R211.1, U27.31 (RXD1/MODE1)
GBE_RGMII.RXD2: R200.1, R210.1, U27.28 (RXD2/MODE2)
GBE_RGMII.RXD3: R199.1, R209.1, U27.27 (RXD3/MODE3)
GBE_RGMII.RX_DV: R207.1, R217.1, U27.33 (RX_DV/CLK125_EN)
GBE_RGMII.TXD0: U27.19 (TXD0)
GBE_RGMII.TXD1: U27.20 (TXD1)
GBE_RGMII.TXD2: U27.21 (TXD2)
GBE_RGMII.TXD3: U27.22 (TXD3)
GBE_RGMII.TX_EN: U27.25 (TX_EN)
GBE_RGMII.~INT: R206.1, R216.1, U27.38 (INT_N/PME_N2)
GBE_RGMII.~RESET: R239.2, U27.42 (RESET_N)
GBE_XI: C256.1, R242.2, U27.46 (XI), Y4.1
GBE_XO: C263.1, R242.1, U27.45 (XO), Y4.3
GND: C252.2, C253.2, C254.2, C255.2, C256.2, C257.2, C258.2, C259.2, C260.2, C261.2, C262.2, C263.2, C264.2, C265.2, C267.2, C268.2, C269.2, C270.2, C271.2, C272.2, C273.2, C274.2, C275.2, C276.2, C277.2, C278.2, C279.2, C280.2, C281.2, C282.2, C283.2, C284.2, C285.2, C286.2, C287.2, C288.2, C289.2, C290.2, C291.2, C292.2, C293.2, C398.2, J15.10_1 (GND_1), J15.10_2 (GND_2), J16.2 (D2S), J16.5 (D1S), J16.8 (D0S), J16.11 (CKS), J16.17 (GND), J16.SH, R209.2, R210.2, R211.2, R212.2, R213.2, R214.2, R215.2, R216.2, R217.2, R218.2, R225.2, R226.2, R227.2, R228.2, R229.2, R230.2, R244.1, R246.1, R248.1, U26.25 (VSS), U27.13 (NC_(GND)), U27.29 (GND), U27.49 (GND), U28.3 (GND), U28.8 (GND), U29.3 (GND), U29.8 (GND), Y3.2, Y3.4, Y4.2, Y4.4
HDMI.CLK_N: R261.1
HDMI.CLK_P: R260.1
HDMI.D0_N: R259.1
HDMI.D0_P: R258.1
HDMI.D1_N: R257.1
HDMI.D1_P: R256.1
HDMI.D2_N: R255.1
HDMI.D2_P: R254.1
HDMI_5V: C398.1, D31.2, FB9.2
HDMI_CONN_5V: D31.1, J16.18 (+5V)
HDMI_CONN_CLK_N: J16.12 (CK-), R261.2, U29.5 (IO4), U29.6 (IO4)
HDMI_CONN_CLK_P: J16.10 (CK+), R260.2, U29.4 (IO3), U29.7 (IO3)
HDMI_CONN_D0_N: J16.9 (D0-), R259.2, U29.2 (IO2), U29.9 (IO2)
HDMI_CONN_D0_P: J16.7 (D0+), R258.2, U29.1 (IO1), U29.10 (IO1)
HDMI_CONN_D1_N: J16.6 (D1-), R257.2, U28.5 (IO4), U28.6 (IO4)
HDMI_CONN_D1_P: J16.4 (D1+), R256.2, U28.4 (IO3), U28.7 (IO3)
HDMI_CONN_D2_N: J16.3 (D2-), R255.2, U28.2 (IO2), U28.9 (IO2)
HDMI_CONN_D2_P: J16.1 (D2+), R254.2, U28.1 (IO1), U28.10 (IO1)
unnamed: C269.1, J15.9_1 (TRDCT1/2/3/4_1), R243.1
POE_ETH.VC1: J15.14_1 (VC12_1)
POE_ETH.VC2: J15.11_1 (VC36_1)
POE_ETH.VC3: J15.12_1 (VC45_1)
POE_ETH.VC4: J15.13_1 (VC78_1)
POE_GBE.VC1: J15.14_2 (VC12_2)
POE_GBE.VC2: J15.11_2 (VC36_2)
POE_GBE.VC3: J15.12_2 (VC45_2)
POE_GBE.VC4: J15.13_2 (VC78_2)

Notes on the sheet:
MODE2
Pull up
LED_MODE
PHYAD0
MODE0
default: MODE[2:0] : 111 (see datasheet table 3-4) PHYAD[0]: 0 REGOFF: 0, INT 1.2 V Reg enabled ~{INTSEL}: 0, REF_CLK Out mode
MODE1
MODE3
NOTE: Place close to PHY IC
ALLPHYAD
NOTE: KSZ9131RNXC pins 13,14 and 47 connected for backward compability with KSZ9031RNXC
~{INTSEL}
PHYAD2
PHYAD1
NOTE: Place close to AVDDL_PLL (PIN 44)
CLK125_EN
REGOFF
Pull down
NOTE: Place close to HDMI connector
default: MODE[3:0] : 1100 (see datasheet table 3-8) PHYAD[4:0]: 00011 CLK125_EN: 0, disabled LED_MODE: 1, Individual-LED ALLPHYAD: 1, disable (inverted logic)
Ethernet
Bootstrap configuration
HDMI
NOTE: Place close to FPGA
Gigabit Ethernet
NOTE: Place close ETH connector
NOTE: KSZ9131 allows pairs and polarity swap
