kangyuzhe666/kintex-410t-devboard/power-supply.kicad_sch

## KiCad design power-supply.kicad_sch (2023-02-02)

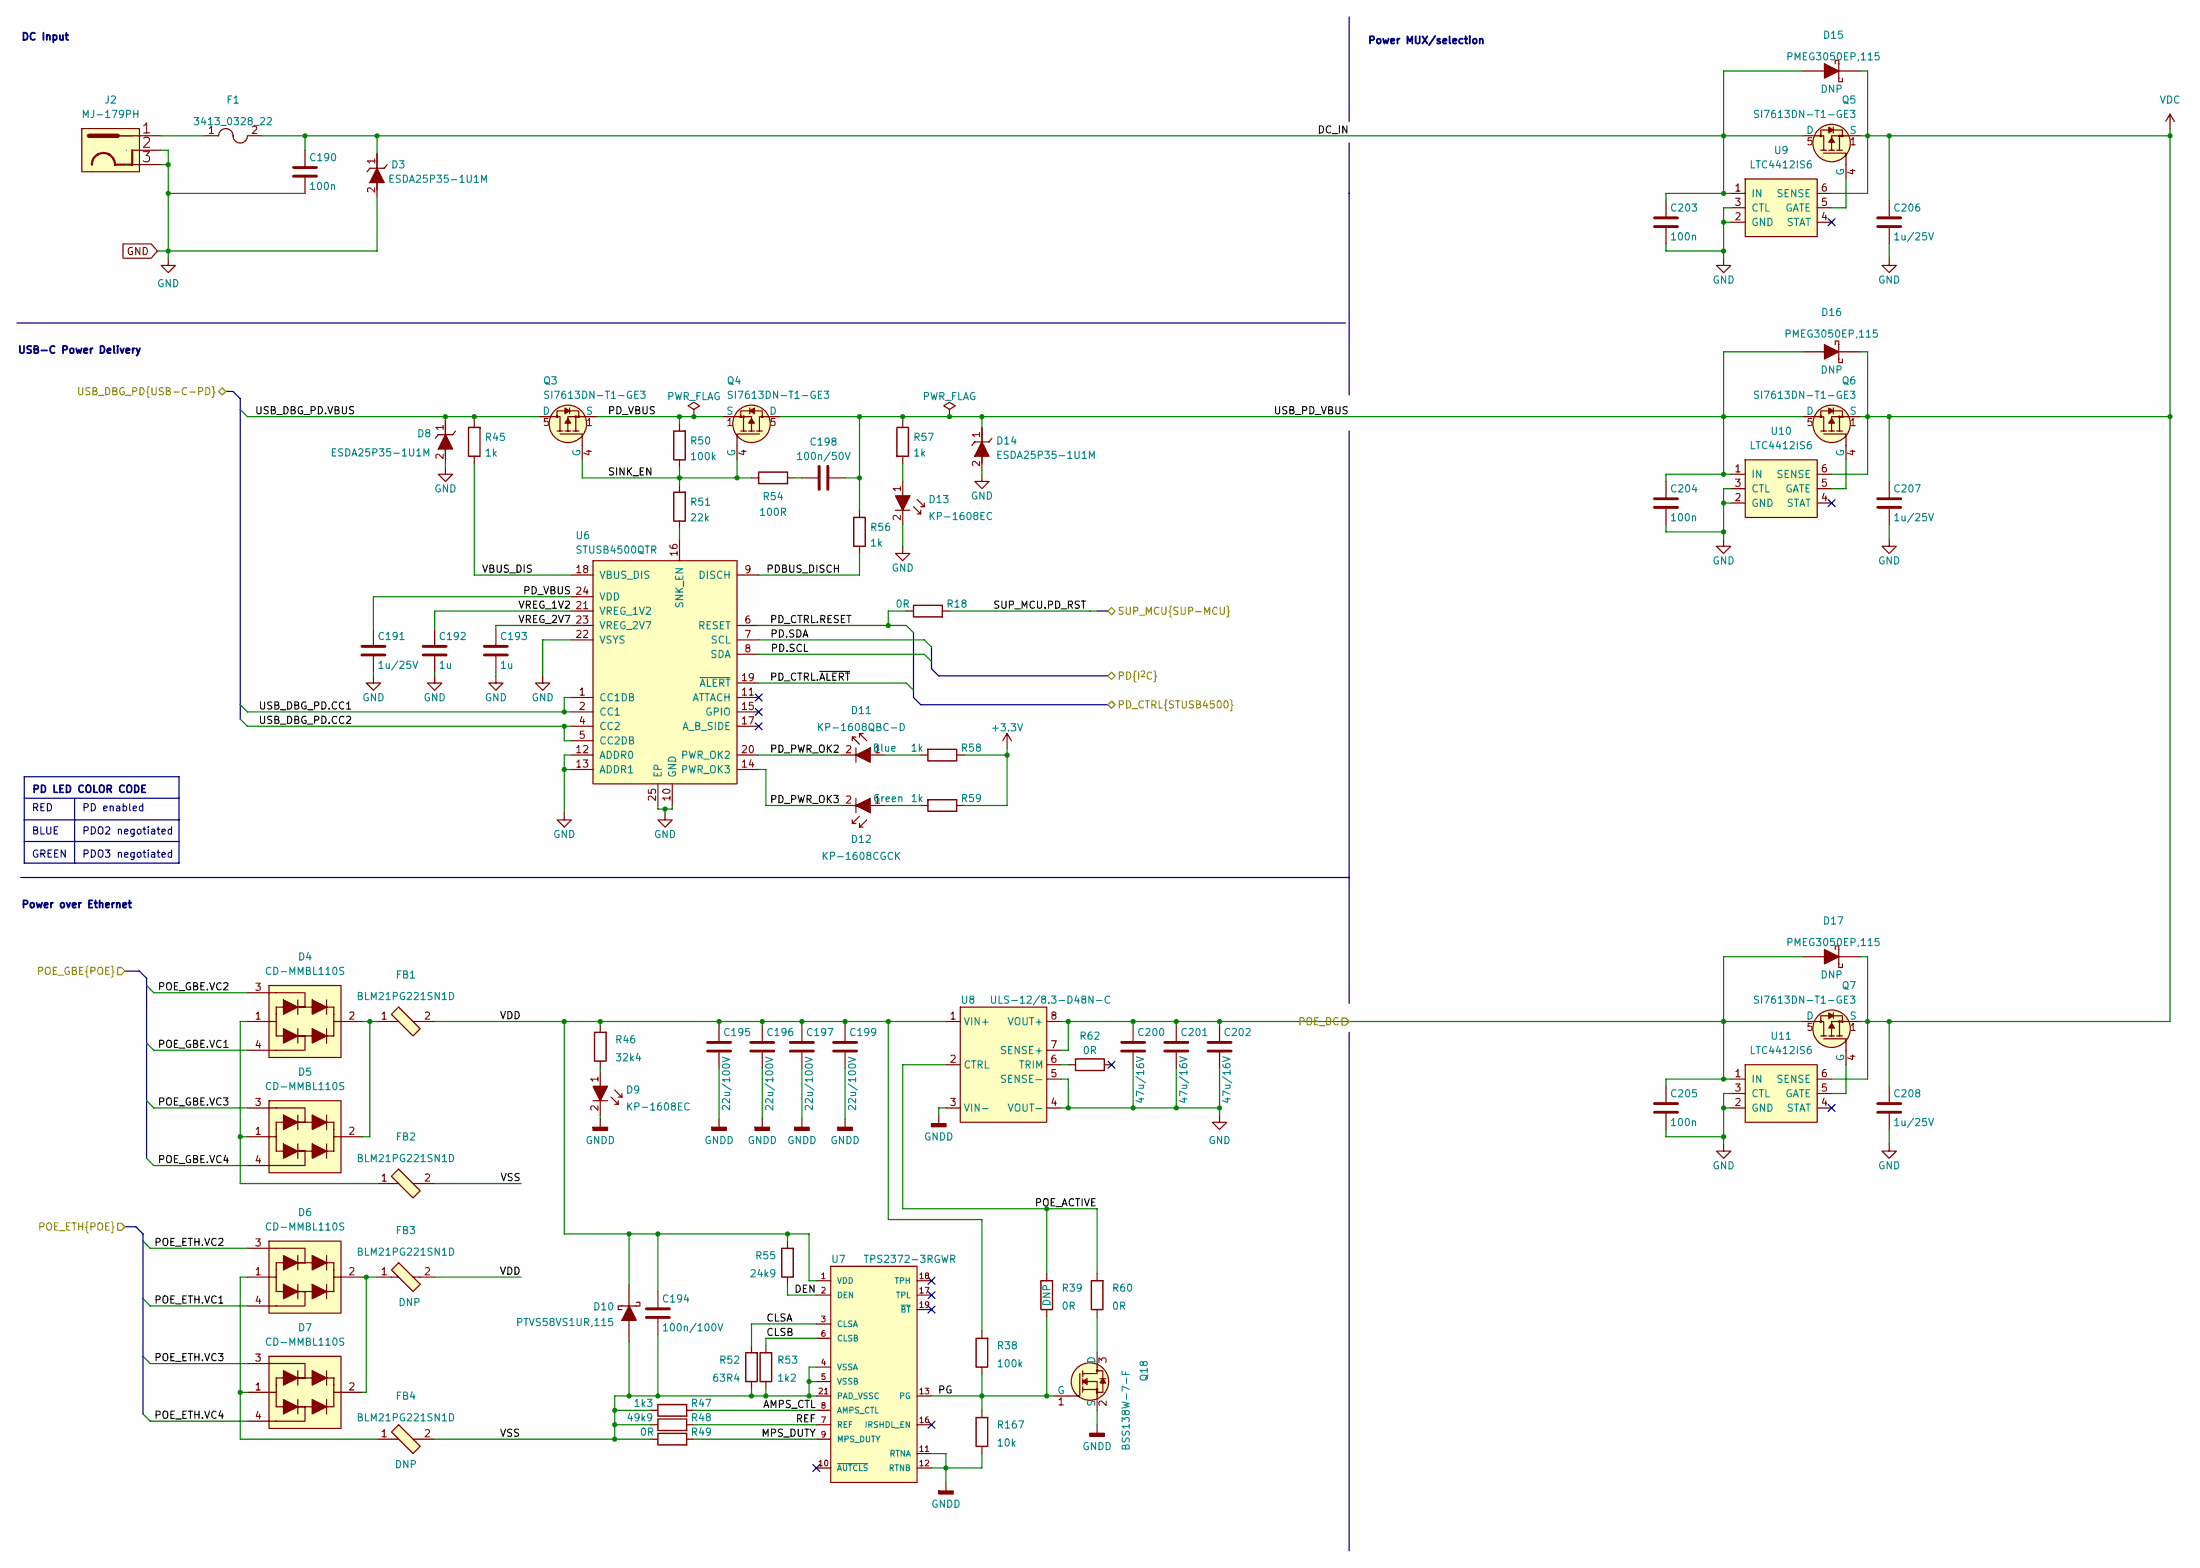
[picture p10: schematic power-supply.kicad_sch]

Parts:
C190, C203, C204, C205: C_100n_0402; 0402-cap; MPN GRM155R61H104KE14D
C191, C206, C207, C208: C_1u_0603_25V; 0603-cap; MPN CL10A105KA8NNNC
C192, C193: C_1u_0402; 0402-cap; MPN C1005X6S1A105K050BC
C194: C_100n_0805_100V; 0805-cap; MPN CL21B104KCFNNNE
C195, C196, C197, C199: C_22u_2220_100V; 2220-cap; MPN C5750X7S2A226M280KB
C198: C_100n_0402_50V; 0402-cap; MPN GRM155R71H104KE14D
C200, C201, C202: C_47u_16V_1206; 1206-cap; MPN C3216X5R1C476M160AB
D3, D8, D14: ESDA25P35-1U1M; 0603-diode; MPN ESDA25P35-1U1M
D4, D5, D6, D7: CD-MMBL110S; DFN3538; MPN CD-MMBL110S
D9, D13: KP-1608EC; LED_0603; MPN KP-1608EC
D10: PTVS58VS1UR,115; SOD-123F; MPN PTVS58VS1UR,115
D11: KP-1608QBC-D; LED_0603; MPN KP-1608QBC-D
D12: KP-1608CGCK; LED_0603; MPN KP-1608CGCK
D15, D16, D17: PMEG3050EP,115; Nexperia_SOD128; MPN PMEG3050EP,115
F1: 3413_0328_22; 1206-res; MPN 3413.0328.22
FB1, FB2, FB3, FB4: BLM21PG221SN1D; 0805-res; MPN BLM21PG221SN1D
J2: DC_SOCKET; MPN MJ-179PH
Q3, Q4, Q5, Q6, Q7: SI7613DN-T1-GE3; Vishay_PowerPAK_1212-8_Single; MPN SI7613DN-T1-GE3
Q18: BSS138W-7-F; SOT-323; MPN BSS138W-7-F
R18, R39, R49, R60, R62: R_0R_0402; 0402-res; MPN ERJ2GE0R00X
R38, R50: R_100k_0402; 0402-res; MPN CRCW0402100KFKEDHP
R45, R56, R57, R58, R59: R_1k_0402; 0402-res; MPN CR0402-FX-1001GLF
R46: R_32k4_0402; 0402-res; MPN ERA-2ARB3242X
R47: R_1k3_0402; 0402-res; MPN CR0402-FX-1301GLF
R48: R_49k9_0402; 0402-res; MPN CRCW040249K9FKED
R51: R_22k_0402; 0402-res; MPN ERJ-2RKF2202X
R52: R_63R4_0603; 0603-res; MPN ERJPA3F63R4V
R53: R_1k2_0402; 0402-res; MPN ERJ2RKF1201X
R54: R_100R_0402; 0402-res; MPN CR0402-FX-1000GLF
R55: R_24k9_0402; 0402-res; MPN WR04X2492FTL
R167: R_10k_0402; 0402-res; MPN CRCW040210K0FKEDHP
U6: STUSB4500QTR; QFN50P400X400X90-25N; MPN STUSB4500QTR
U7: TPS2372-3RGWR; Texas_RGW0020B; MPN TPS2372-3RGWR
U8: ULS-12/8.3-D48N-C; ULS-12_5-D48N-C; MPN ULS-12/8.3-D48N-C
U9, U10, U11: LTC4412IS6; SOT-23-6; MPN LTC4412IS6#TRMPBF

Connections:
+3.3V: R58.1, R59.1
AMPS_CTL: R47.2, U7.8 (AMPS_CTL)
CLSA: R52.2, U7.3 (CLSA)
CLSB: R53.2, U7.6 (CLSB)
DC_IN: C190.1, C203.1, D3.1, D15.2, F1.2, Q5.5 (D), U9.1 (IN)
DEN: R55.1, U7.2 (DEN)
GND: C190.2, C191.2, C192.2, C193.2, C200.2, C201.2, C202.2, C203.2, C204.2, C205.2, C206.2, C207.2, C208.2, D3.2, D8.2, D13.2, D14.2, J2.2, J2.3, U6.10 (GND), U6.12 (ADDR0), U6.13 (ADDR1), U6.22 (VSYS), U6.25 (EP), U8.4 (VOUT-), U8.5 (SENSE-), U9.2 (GND), U9.3 (CTL), U10.2 (GND), U10.3 (CTL), U11.2 (GND), U11.3 (CTL)
GNDD: C195.2, C196.2, C197.2, C199.2, D9.2, Q18.2 (S), R167.1, U7.11 (RTNA), U7.12 (RTNB), U8.3 (VIN-)
MPS_DUTY: R49.2, U7.9 (MPS_DUTY)
unnamed: C198.1, R54.2
unnamed: D4.1, D5.1, FB2.1
unnamed: D4.2, D5.2, FB1.1
unnamed: D6.1, D7.1, FB4.1
unnamed: D6.2, D7.2, FB3.1
unnamed: D9.1, R46.1
unnamed: D11.1, R58.2
unnamed: D12.1, R59.2
unnamed: D13.1, R57.2
unnamed: F1.1, J2.1
unnamed: Q5.4 (G), U9.5 (GATE)
unnamed: Q6.4 (G), U10.5 (GATE)
unnamed: Q7.4 (G), U11.5 (GATE)
unnamed: Q18.3 (D), R60.1
unnamed: R51.1, U6.16 (SNK_EN)
unnamed: R62.1, U8.6 (TRIM)
PD.SCL: U6.8 (SDA)
PD.SDA: U6.7 (SCL)
PDBUS_DISCH: R56.2, U6.9 (DISCH)
PD_CTRL.RESET: R18.1, U6.6 (RESET)
PD_CTRL.~ALERT: U6.19 (~ALERT)
PD_PWR_OK2: D11.2, U6.20 (PWR_OK2)
PD_PWR_OK3: D12.2, U6.14 (PWR_OK3)
PD_VBUS: C191.1, Q3.1 (S), Q3.2 (S), Q3.3 (S), Q4.1 (S), Q4.2 (S), Q4.3 (S), R50.2, U6.24 (VDD)
PG: Q18.1 (G), R38.1, R39.1, R167.2, U7.13 (PG)
POE_ACTIVE: R39.2, R60.2, U8.2 (CTRL)
POE_DC: C200.1, C201.1, C202.1, C205.1, D17.2, Q7.5 (D), U8.7 (SENSE+), U8.8 (VOUT+), U11.1 (IN)
POE_ETH.VC1: D6.4
POE_ETH.VC2: D6.3
POE_ETH.VC3: D7.3
POE_ETH.VC4: D7.4
POE_GBE.VC1: D4.4
POE_GBE.VC2: D4.3
POE_GBE.VC3: D5.3
POE_GBE.VC4: D5.4
REF: R48.2, U7.7 (REF)
SINK_EN: Q3.4 (G), Q4.4 (G), R50.1, R51.2, R54.1
SUP_MCU.PD_RST: R18.2
USB_DBG_PD.CC1: U6.1 (CC1DB), U6.2 (CC1)
USB_DBG_PD.CC2: U6.4 (CC2), U6.5 (CC2DB)
USB_DBG_PD.VBUS: D8.1, Q3.5 (D), R45.2
USB_PD_VBUS: C198.2, C204.1, D14.1, D16.2, Q4.5 (D), Q6.5 (D), R56.1, R57.1, U10.1 (IN)
VBUS_DIS: R45.1, U6.18 (VBUS_DIS)
VDC: C206.1, C207.1, C208.1, D15.1, D16.1, D17.1, Q5.1 (S), Q5.2 (S), Q5.3 (S), Q6.1 (S), Q6.2 (S), Q6.3 (S), Q7.1 (S), Q7.2 (S), Q7.3 (S), U9.6 (SENSE), U10.6 (SENSE), U11.6 (SENSE)
VDD: C194.1, C195.1, C196.1, C197.1, C199.1, D10.K, FB1.2, FB3.2, R38.2, R46.2, R55.2, U7.1 (VDD), U8.1 (VIN+)
VREG_1V2: C192.1, U6.21 (VREG_1V2)
VREG_2V7: C193.1, U6.23 (VREG_2V7)
VSS: C194.2, D10.A, FB2.2, FB4.2, R47.1, R48.1, R49.1, R52.1, R53.1, U7.4 (VSSA), U7.5 (VSSB), U7.21 (PAD_VSSC)

Notes on the sheet:
Power over Ethernet
Power MUX/selection
PD enabled PDO2 negotiated PDO3 negotiated
PD LED COLOR CODE
RED BLUE GREEN
DC Input
USB-C Power Delivery
