kangyuzhe666/kintex-410t-devboard/ram.kicad_sch

## KiCad design ram.kicad_sch (2023-04-08)

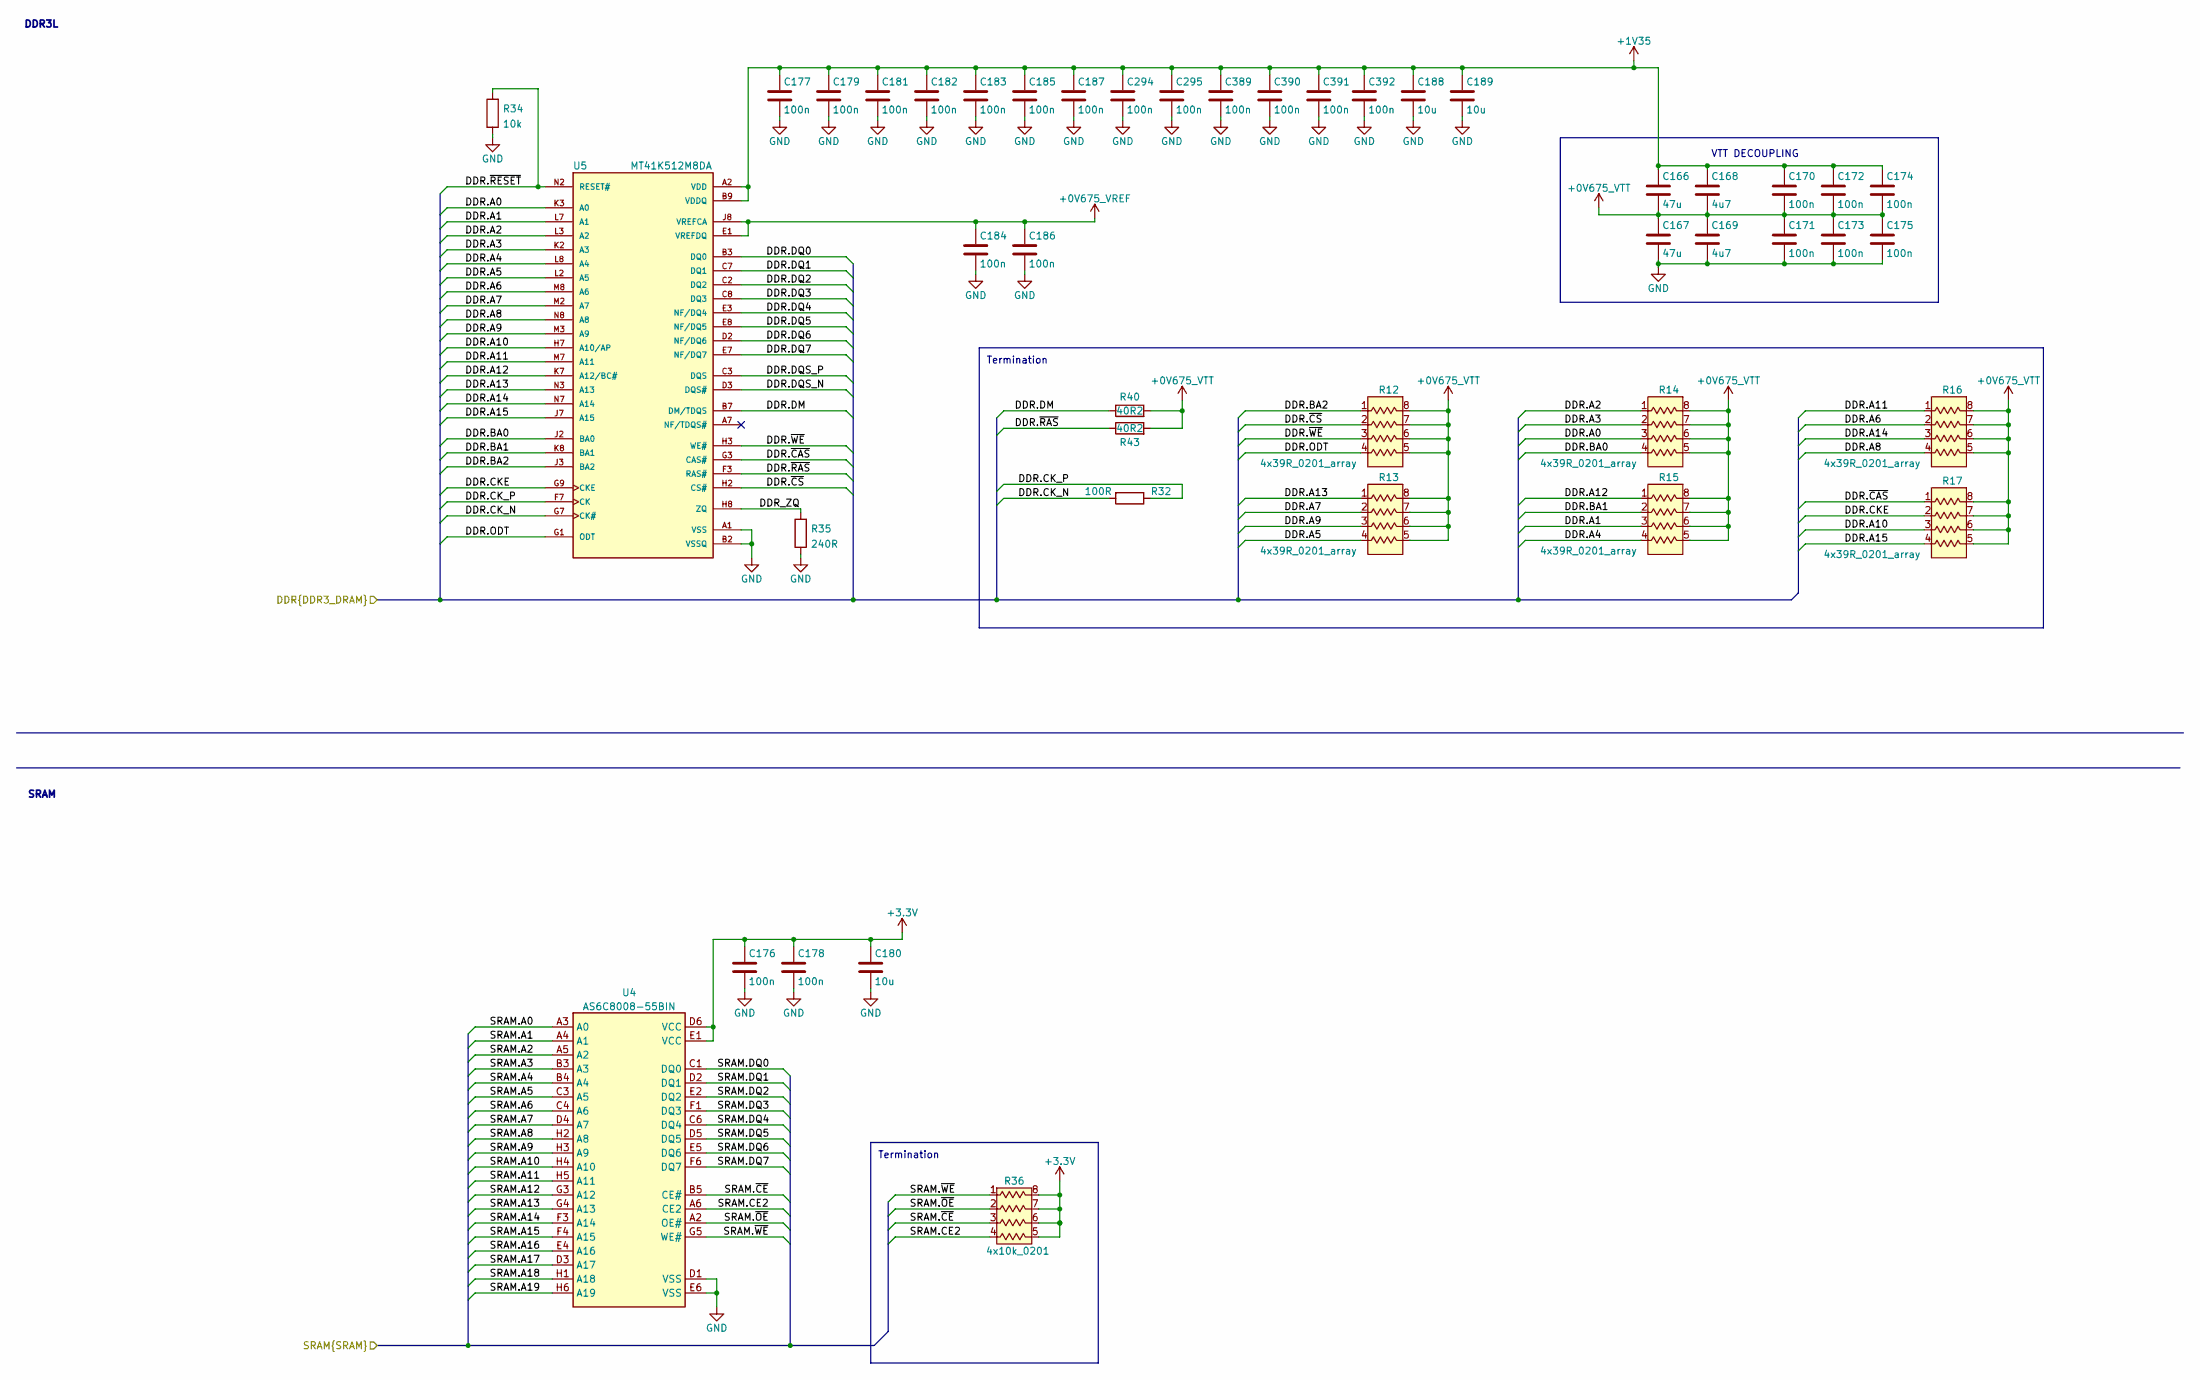
[picture p11: schematic ram.kicad_sch]

Parts:
C166, C167: C_47u_0603; 0603-cap; MPN GRM188R60J476ME15D
C168, C169: C_4u7_0201; 0201-cap; MPN GRM035R60J475ME15D
C170, C171, C172, C173, C174, C175, C176, C177, C178, C179, C181, C182, C183, C184, C185, C186, C187, C294, C295, C389, C390, C391, C392: C_100n_0402_EIA; 0402-cap_EIA; MPN GRM155R61H104KE14D
C180, C188, C189: C_10u_0402; 0402-cap; MPN CC0402MRX5R5BB106
R12, R13, R14, R15, R16, R17: 4x39R_0201_array; EXB18V; MPN EXB-18V390JX
R32: R_100R_0201; 0402-res; MPN CR0402-FX-1000GLF
R34: R_10k_0402; 0402-res; MPN CRCW040210K0FKEDHP
R35: R_240R_1%_0402; 0402-res; MPN RC0402FR-13240RL
R36: 4x10k_0201_array; EXB18V; MPN EXB-18V103JX
R40, R43: R_40R2_0402; 0402-res; MPN MCWR04X40R2FTL
U4: AS6C8008-55BIN; Alliance_TFBGA-48; MPN AS6C8008-55BIN
U5: MT41K512M8DA; Micron_FBGA-78; MPN MT41K512M8DA-107 XIT:P TR

Connections:
+0V675_VREF: C184.1, C186.1, U5.E1 (VREFDQ), U5.J8 (VREFCA)
+0V675_VTT: C166.2, C167.1, C168.2, C169.1, C170.2, C171.1, C172.2, C173.1, C174.2, C175.1, R12.5, R12.6, R12.7, R12.8, R13.5, R13.6, R13.7, R13.8, R14.5, R14.6, R14.7, R14.8, R15.5, R15.6, R15.7, R15.8, R16.5, R16.6, R16.7, R16.8, R17.5, R17.6, R17.7, R17.8, R40.2, R43.2
+1V35: C166.1, C168.1, C170.1, C172.1, C174.1, C177.1, C179.1, C181.1, C182.1, C183.1, C185.1, C187.1, C188.1, C189.1, C294.1, C295.1, C389.1, C390.1, C391.1, C392.1, U5.A2 (VDD), U5.A9 (VDD), U5.B9 (VDDQ), U5.C1 (VDDQ), U5.D7 (VDD), U5.E2 (VDDQ), U5.E9 (VDDQ), U5.G2 (VDD), U5.G8 (VDD), U5.K1 (VDD), U5.K9 (VDD), U5.M1 (VDD), U5.M9 (VDD)
+3.3V: C176.1, C178.1, C180.1, R36.5, R36.6, R36.7, R36.8, U4.D6 (VCC), U4.E1 (VCC)
DDR.A0: R14.3, U5.K3 (A0)
DDR.A1: R15.3, U5.L7 (A1)
DDR.A2: R14.1, U5.L3 (A2)
DDR.A3: R14.2, U5.K2 (A3)
DDR.A4: R15.4, U5.L8 (A4)
DDR.A5: R13.4, U5.L2 (A5)
DDR.A6: R16.2, U5.M8 (A6)
DDR.A7: R13.2, U5.M2 (A7)
DDR.A8: R16.4, U5.N8 (A8)
DDR.A9: R13.3, U5.M3 (A9)
DDR.A10: R17.3, U5.H7 (A10/AP)
DDR.A11: R16.1, U5.M7 (A11)
DDR.A12: R15.1, U5.K7 (A12/BC#)
DDR.A13: R13.1, U5.N3 (A13)
DDR.A14: R16.3, U5.N7 (A14)
DDR.A15: R17.4, U5.J7 (A15)
DDR.BA0: R14.4, U5.J2 (BA0)
DDR.BA1: R15.2, U5.K8 (BA1)
DDR.BA2: R12.1, U5.J3 (BA2)
DDR.CKE: R17.2, U5.G9 (CKE)
DDR.CK_N: R32.2, U5.G7 (CK#)
DDR.CK_P: R32.1, U5.F7 (CK)
DDR.DM: R40.1, U5.B7 (DM/TDQS)
DDR.DQ0: U5.B3 (DQ0)
DDR.DQ1: U5.C7 (DQ1)
DDR.DQ2: U5.C2 (DQ2)
DDR.DQ3: U5.C8 (DQ3)
DDR.DQ4: U5.E3 (NF/DQ4)
DDR.DQ5: U5.E8 (NF/DQ5)
DDR.DQ6: U5.D2 (NF/DQ6)
DDR.DQ7: U5.E7 (NF/DQ7)
DDR.DQS_N: U5.D3 (DQS#)
DDR.DQS_P: U5.C3 (DQS)
DDR.ODT: R12.4, U5.G1 (ODT)
DDR.~CAS: R17.1, U5.G3 (CAS#)
DDR.~CS: R12.2, U5.H2 (CS#)
DDR.~RAS: R43.1, U5.F3 (RAS#)
DDR.~RESET: R34.2, U5.N2 (RESET#)
DDR.~WE: R12.3, U5.H3 (WE#)
DDR_ZQ: R35.2, U5.H8 (ZQ)
GND: C167.2, C169.2, C171.2, C173.2, C175.2, C176.2, C177.2, C178.2, C179.2, C180.2, C181.2, C182.2, C183.2, C184.2, C185.2, C186.2, C187.2, C188.2, C189.2, C294.2, C295.2, C389.2, C390.2, C391.2, C392.2, R34.1, R35.1, U4.D1 (VSS), U4.E6 (VSS), U5.A1 (VSS), U5.A8 (VSS), U5.B1 (VSS), U5.B2 (VSSQ), U5.B8 (VSSQ), U5.C9 (VSSQ), U5.D1 (VSSQ), U5.D8 (VSS), U5.D9 (VSSQ), U5.F2 (VSS), U5.F8 (VSS), U5.J1 (VSS), U5.J9 (VSS), U5.L1 (VSS), U5.L9 (VSS), U5.N1 (VSS), U5.N9 (VSS)
SRAM.A0: U4.A3 (A0)
SRAM.A1: U4.A4 (A1)
SRAM.A2: U4.A5 (A2)
SRAM.A3: U4.B3 (A3)
SRAM.A4: U4.B4 (A4)
SRAM.A5: U4.C3 (A5)
SRAM.A6: U4.C4 (A6)
SRAM.A7: U4.D4 (A7)
SRAM.A8: U4.H2 (A8)
SRAM.A9: U4.H3 (A9)
SRAM.A10: U4.H4 (A10)
SRAM.A11: U4.H5 (A11)
SRAM.A12: U4.G3 (A12)
SRAM.A13: U4.G4 (A13)
SRAM.A14: U4.F3 (A14)
SRAM.A15: U4.F4 (A15)
SRAM.A16: U4.E4 (A16)
SRAM.A17: U4.D3 (A17)
SRAM.A18: U4.H1 (A18)
SRAM.A19: U4.H6 (A19)
SRAM.CE2: R36.4, U4.A6 (CE2)
SRAM.DQ0: U4.C1 (DQ0)
SRAM.DQ1: U4.D2 (DQ1)
SRAM.DQ2: U4.E2 (DQ2)
SRAM.DQ3: U4.F1 (DQ3)
SRAM.DQ4: U4.C6 (DQ4)
SRAM.DQ5: U4.D5 (DQ5)
SRAM.DQ6: U4.E5 (DQ6)
SRAM.DQ7: U4.F6 (DQ7)
SRAM.~CE: R36.3, U4.B5 (CE#)
SRAM.~OE: R36.2, U4.A2 (OE#)
SRAM.~WE: R36.1, U4.G5 (WE#)

Notes on the sheet:
DDR3L
VTT DECOUPLING
Termination
SRAM
