kangyuzhe666/kintex-410t-devboard/usb-phy.kicad_sch

## KiCad design usb-phy.kicad_sch (2023-04-08)

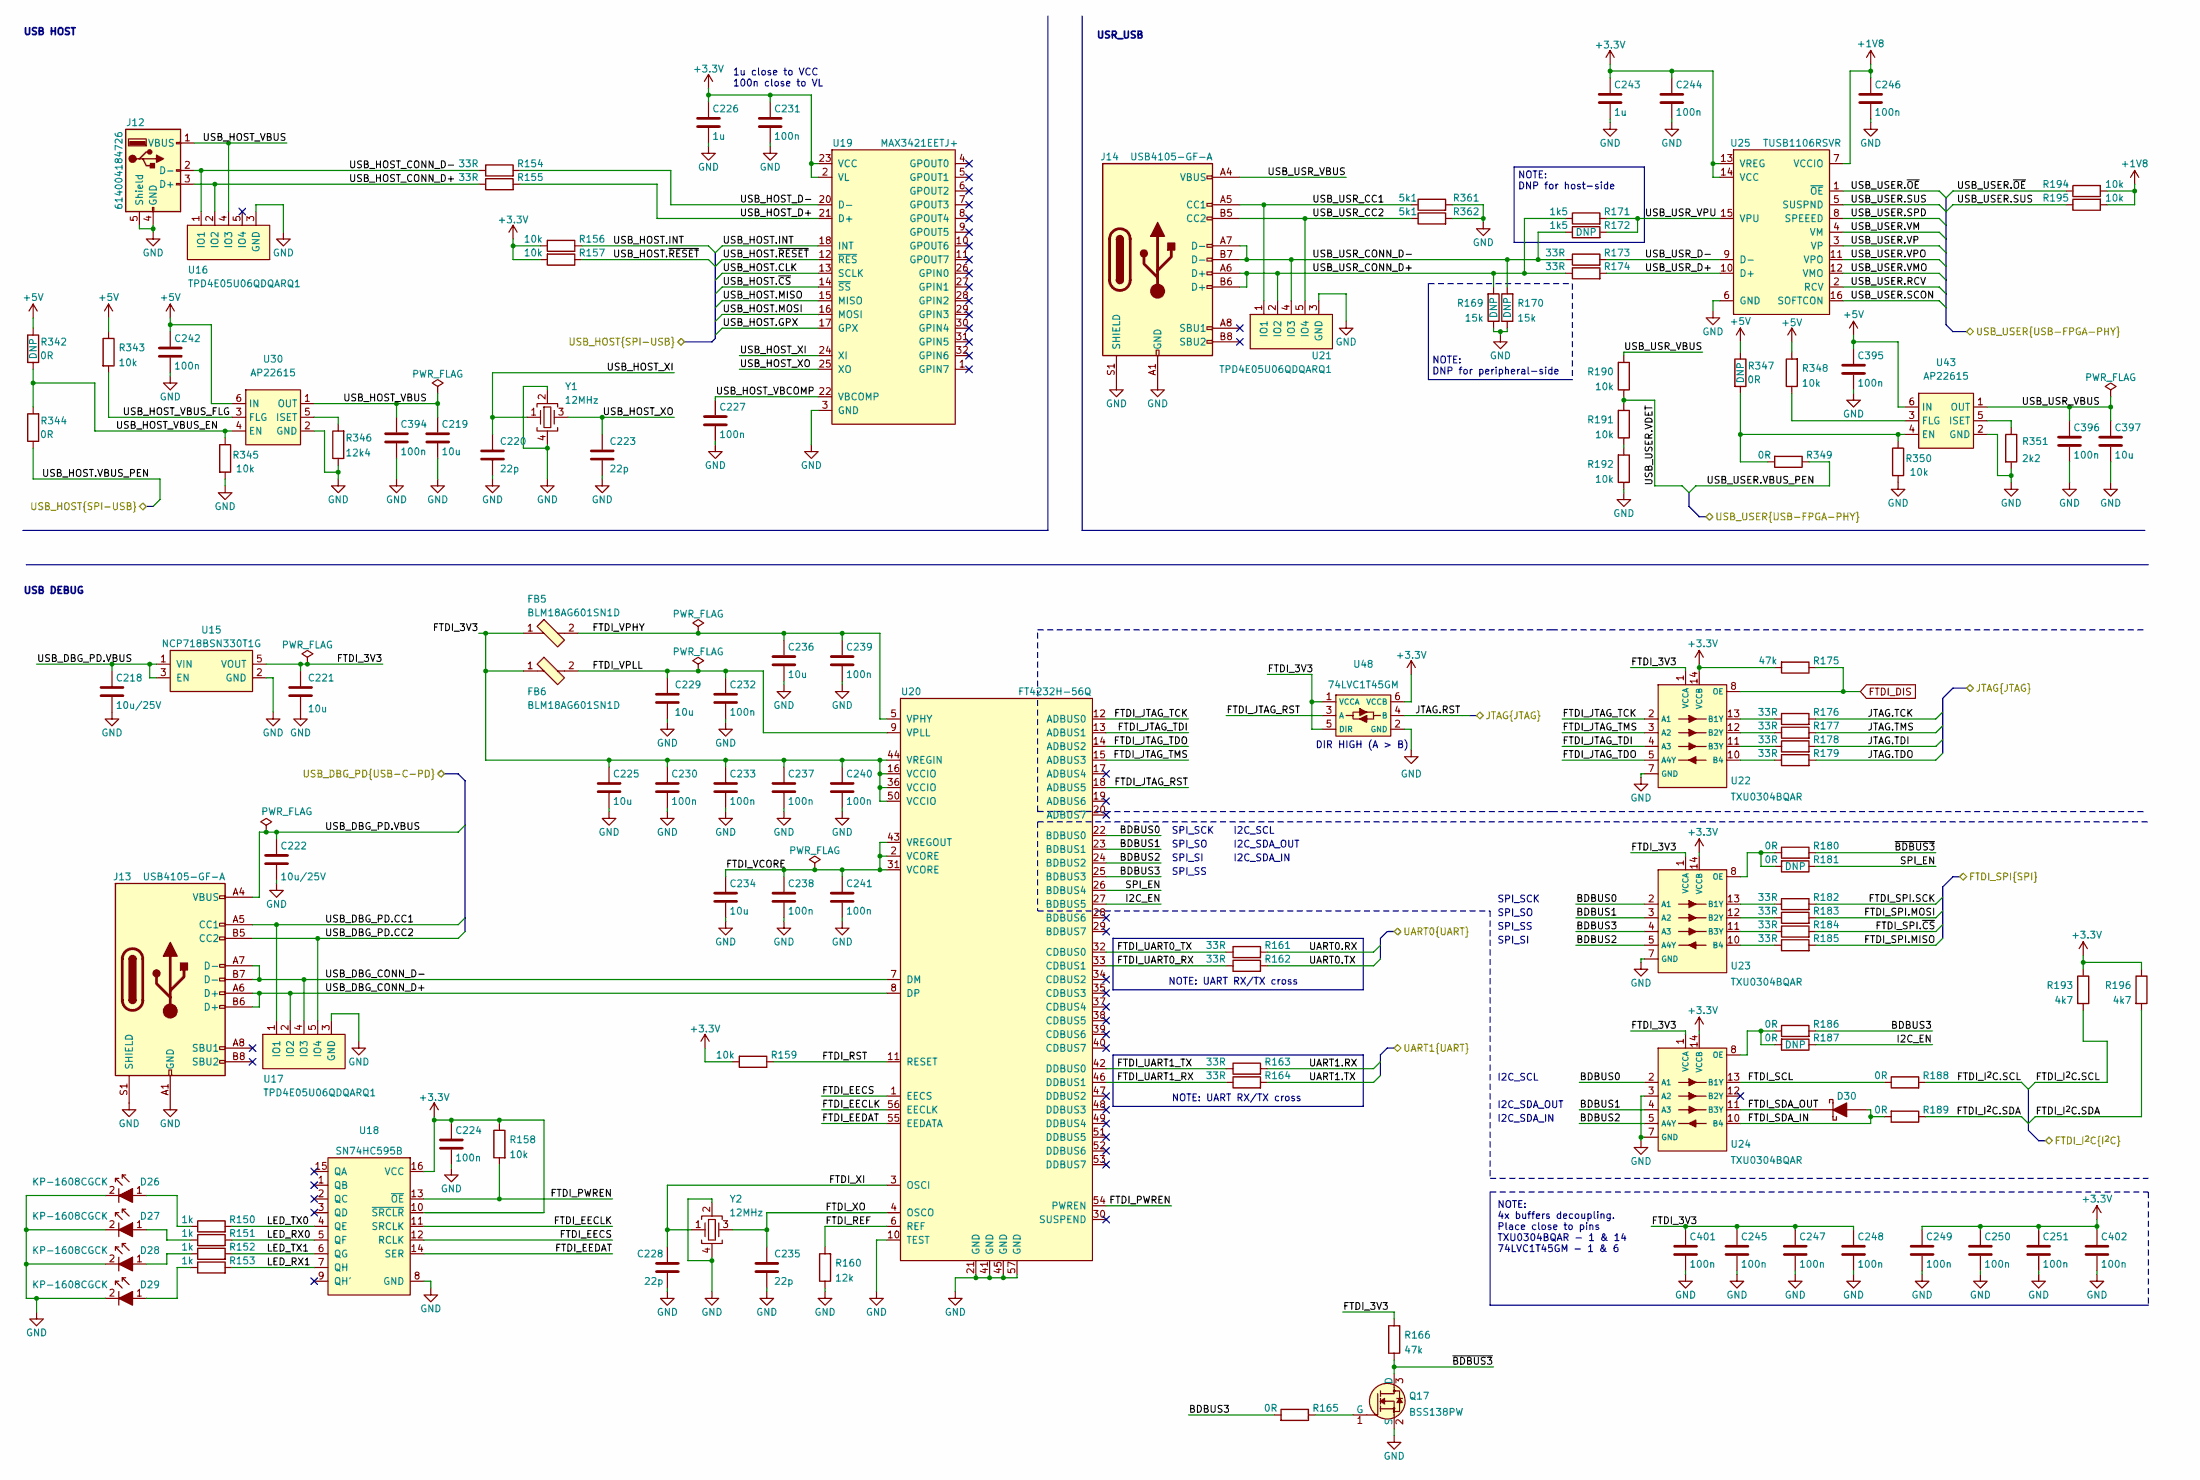
[picture p12: schematic usb-phy.kicad_sch]

Parts:
C218, C222: C_10u_25V_0603; 0603-cap; MPN C1608X5R1E106M080AC
C219, C221, C225, C229, C234, C236, C397: C_10u_0402; 0402-cap; MPN CC0402MRX5R5BB106
C220, C223, C228, C235: C_22p_0402; 0402-cap; MPN CC0402JRNPO9BN220
C224, C227, C230, C231, C232, C233, C237, C238, C239, C240, C241, C242, C244, C245, C246, C247, C248, C249, C250, C251, C394, C395, C396, C401, C402: C_100n_0402_EIA; 0402-cap_EIA; MPN GRM155R61H104KE14D
C226, C243: C_1u_0402; 0402-cap; MPN C1005X6S1A105K050BC
D26, D27, D28, D29: KP-1608CGCK; LED_0603; MPN KP-1608CGCK
D30: BAT54-02V-V-G; SOD-523; MPN BAT54
FB5, FB6: BLM18AG601SN1D; 0603; MPN BLM18AG601SN1D
J12: 614004184726; MPN 614004184726
J13, J14: USB4105-GF-A; GCT_USB4105-GF-A; MPN USB4105-GF-A
Q17: BSS138PW; SC70-3; MPN BSS138PW
R150, R151, R152, R153: R_1k_0402; 0402-res; MPN CR0402-FX-1001GLF
R154, R155, R161, R162, R163, R164, R173, R174, R176, R177, R178, R179, R182, R183, R184, R185: R_33R_0402; 0402-res; MPN CRCW040233R0FKED
R156, R157, R158, R159, R190, R191, R192, R194, R195, R343, R345, R348, R350: R_10k_0402; 0402-res; MPN CRCW040210K0FKEDHP
R160: R_12k_0402; 0402-res; MPN CRCW040212K0FKEDHP
R165, R180, R181, R186, R187, R188, R189, R342, R344, R347, R349: R_0R_0402; 0402-res; MPN ERJ2GE0R00X
R166, R175: R_47k_0402; 0402-res; MPN MCMR04X4702FTL
R169, R170: R_15k_0402; 0402-res; MPN SFR01MZPF1502
R171, R172: R_1k5_0402; 0402-res; MPN MP000515
R193, R196: R_4k7_0402; 0402-res; MPN MCS04020C4701FE000
R346: R_12k4_0402; 0402-res; MPN ERJ2RKF1242X
R351: R_2k2_0402; 0402-res; MPN RC0402FR-072K2L
R361, R362: R_5k1_0402; 0402-res; MPN SFR01MZPJ512
U15: NCP718BSN330T1G; SOT-23-5; MPN NCP718BSN330T1G
U16, U17, U21: TPD4E05U06QDQARQ1; USON-10_2.5x1.0mm_P0.5mm; MPN TPD4E05U06QDQARQ1
U18: SN74HC595B; X1QFN-16-1EP_2.5x2.5mm; MPN SN74HC595BRWNR
U19: MAX3421EETJ+; QFN-32-1EP_5x5mm; MPN MAX3421EETJ+
U20: FT4232H-56Q; QFN-56-1EP_8x8mm_P0.5mm_EP5.5.9x5.9mm; MPN FT4232H-56Q-REEL
U22, U23, U24: TXU0304BQAR; DHVQFN14; MPN TXU0304BQAR
U25: TUSB1106RSVR; Texas_16-UFQFN; MPN TUSB1106RSVR
U30, U43: AP22615; TSOT23-6; MPN AP22615AWU-7
U48: 74LVC1T45GM; SOT-886; MPN 74LVC1T45GM-Q100X
Y1, Y2: ABM8G-12.000MHZ-18-D2Y-T; KX-7; MPN ABM8G-12.000MHZ-18-D2Y-T

Connections:
+1V8: C246.1, R194.2, R195.2, U25.7 (VCCIO)
+3.3V: C224.1, C226.1, C231.1, C243.1, C244.1, C249.1, C250.1, C251.1, C402.1, R156.2, R157.2, R158.1, R159.2, R175.2, R193.1, R196.1, U18.10 (~SRCLR), U18.16 (VCC), U19.2 (VL), U19.23 (VCC), U22.14 (VCCB), U23.14 (VCCB), U24.14 (VCCB), U25.13 (VREG), U25.14 (VCC), U48.6 (VCCB)
+5V: C242.1, C395.1, R342.1, R343.1, R347.1, R348.2, U30.6 (IN), U43.6 (IN)
BDBUS0: U20.22 (BDBUS0), U23.2 (A1), U24.2 (A1)
BDBUS1: U20.23 (BDBUS1), U23.3 (A2), U24.4 (A3)
BDBUS2: U20.24 (BDBUS2), U23.5 (A4Y), U24.5 (A4Y)
BDBUS3: R165.2, R186.2, U20.25 (BDBUS3), U23.4 (A3)
FTDI_3V3: C221.1, C225.1, C230.1, C233.1, C237.1, C240.1, C245.1, C247.1, C248.1, C401.1, FB5.1, FB6.1, R166.2, U15.5 (VOUT), U20.16 (VCCIO), U20.36 (VCCIO), U20.44 (VREGIN), U20.50 (VCCIO), U22.1 (VCCA), U23.1 (VCCA), U24.1 (VCCA), U48.1 (VCCA), U48.5 (DIR)
FTDI_DIS: R175.1, U22.8 (OE)
FTDI_EECLK: U18.11 (SRCLK), U20.56 (EECLK)
FTDI_EECS: U18.12 (RCLK), U20.1 (EECS)
FTDI_EEDAT: U18.14 (SER), U20.55 (EEDATA)
FTDI_I^{2}C.SCL: R188.2, R193.2
FTDI_I^{2}C.SDA: R189.1, R196.2
FTDI_JTAG_RST: U20.18 (ADBUS5), U48.3 (A)
FTDI_JTAG_TCK: U20.12 (ADBUS0), U22.2 (A1)
FTDI_JTAG_TDI: U20.13 (ADBUS1), U22.4 (A3)
FTDI_JTAG_TDO: U20.14 (ADBUS2), U22.5 (A4Y)
FTDI_JTAG_TMS: U20.15 (ADBUS3), U22.3 (A2)
FTDI_PWREN: R158.2, U18.13 (~OE), U20.54 (PWREN)
FTDI_REF: R160.2, U20.6 (REF)
FTDI_RST: R159.1, U20.11 (RESET)
FTDI_SCL: R188.1, U24.13 (B1Y)
FTDI_SDA_IN: D30.2, R189.2, U24.10 (B4)
FTDI_SDA_OUT: D30.1, U24.11 (B3Y)
FTDI_SPI.MISO: R185.2
FTDI_SPI.MOSI: R183.2
FTDI_SPI.SCK: R182.2
FTDI_SPI.~CS: R184.2
FTDI_UART0_RX: R162.1, U20.33 (CDBUS1)
FTDI_UART0_TX: R161.1, U20.32 (CDBUS0)
FTDI_UART1_RX: R164.1, U20.46 (DDBUS1)
FTDI_UART1_TX: R163.1, U20.42 (DDBUS0)
FTDI_VCORE: C234.1, C238.1, C241.1, U20.2 (VCORE), U20.31 (VCORE), U20.43 (VREGOUT)
FTDI_VPHY: C236.1, C239.1, FB5.2, U20.5 (VPHY)
FTDI_VPLL: C229.1, C232.1, FB6.2, U20.9 (VPLL)
FTDI_XI: C228.1, U20.3 (OSCI), Y2.1
FTDI_XO: C235.1, U20.4 (OSCO), Y2.3
GND: C218.2, C219.2, C220.2, C221.2, C222.2, C223.2, C224.2, C225.2, C226.2, C227.2, C228.2, C229.2, C230.2, C231.2, C232.2, C233.2, C234.2, C235.2, C236.2, C237.2, C238.2, C239.2, C240.2, C241.2, C242.2, C243.2, C244.2, C245.2, C246.2, C247.2, C248.2, C249.2, C250.2, C251.2, C394.2, C395.2, C396.2, C397.2, C401.2, C402.2, D26.2, D27.2, D28.2, D29.2, J12.4 (GND), J12.5 (Shield), J13.A1 (GND), J13.A12 (GND), J13.B1 (GND), J13.B12 (GND), J13.S1 (SHIELD), J14.A1 (GND), J14.A12 (GND), J14.B1 (GND), J14.B12 (GND), J14.S1 (SHIELD), Q17.2 (S), R160.1, R169.1, R170.1, R192.1, R345.2, R346.1, R350.2, R351.2, R361.2, R362.2, U15.2 (GND), U16.3 (GND), U16.8 (GND), U17.3 (GND), U17.8 (GND), U18.8 (GND), U19.3 (GND), U19.19 (GND), U19.33 (EP), U20.10 (TEST), U20.21 (GND), U20.41 (GND), U20.45 (GND), U20.57 (GND), U21.3 (GND), U21.8 (GND), U22.7 (GND), U22.15 (GND), U23.7 (GND), U23.15 (GND), U24.3 (A2), U24.7 (GND), U24.15 (GND), U25.6 (GND), U30.2 (GND), U43.2 (GND), U48.2 (GND), Y1.2, Y1.4, Y2.2, Y2.4
I2C_EN: R187.1, U20.27 (BDBUS5)
JTAG.RST: U48.4 (B)
JTAG.TCK: R176.2
JTAG.TDI: R178.2
JTAG.TDO: R179.2
JTAG.TMS: R177.2
LED_RX0: R151.2, U18.5 (QF)
LED_RX1: R153.2, U18.7 (QH)
LED_TX0: R150.2, U18.4 (QE)
LED_TX1: R152.2, U18.6 (QG)
unnamed: D26.1, R150.1
unnamed: D27.1, R151.1
unnamed: D28.1, R152.1
unnamed: D29.1, R153.1
unnamed: Q17.1 (G), R165.1
unnamed: R176.1, U22.13 (B1Y)
unnamed: R177.1, U22.12 (B2Y)
unnamed: R178.1, U22.11 (B3Y)
unnamed: R179.1, U22.10 (B4)
unnamed: R180.1, R181.2, U23.8 (OE)
unnamed: R182.1, U23.13 (B1Y)
unnamed: R183.1, U23.12 (B2Y)
unnamed: R184.1, U23.11 (B3Y)
unnamed: R185.1, U23.10 (B4)
unnamed: R186.1, R187.2, U24.8 (OE)
unnamed: R191.1, R192.2
unnamed: R346.2, U30.5 (ISET)
unnamed: R347.2, R349.2, R350.1, U43.4 (EN)
unnamed: R348.1, U43.3 (FLG)
unnamed: R351.1, U43.5 (ISET)
unnamed: U16.5 (IO4), U16.6 (IO4)
SPI_EN: R181.1, U20.26 (BDBUS4)
UART0.RX: R161.2
UART0.TX: R162.2
UART1.RX: R163.2
UART1.TX: R164.2
USB_DBG_CONN_D+: J13.A6 (D+), J13.B6 (D+), U17.2 (IO2), U17.9 (IO2), U20.8 (DP)
USB_DBG_CONN_D-: J13.A7 (D-), J13.B7 (D-), U17.4 (IO3), U17.7 (IO3), U20.7 (DM)
USB_DBG_PD.CC1: J13.A5 (CC1), U17.1 (IO1), U17.10 (IO1)
USB_DBG_PD.CC2: J13.B5 (CC2), U17.5 (IO4), U17.6 (IO4)
USB_DBG_PD.VBUS: C218.1, C222.1, J13.A4 (VBUS), J13.A9 (VBUS), J13.B4 (VBUS), J13.B9 (VBUS), U15.1 (VIN), U15.3 (EN)
USB_HOST.CLK: U19.13 (SCLK)
USB_HOST.GPX: U19.17 (GPX)
USB_HOST.INT: R156.1, U19.18 (INT)
USB_HOST.MISO: U19.15 (MISO)
USB_HOST.MOSI: U19.16 (MOSI)
USB_HOST.VBUS_PEN: R344.1
USB_HOST.~CS: U19.14 (~SS)
USB_HOST.~RESET: R157.1, U19.12 (~RES)
USB_HOST_CONN_D+: J12.3 (D+), R155.1, U16.2 (IO2), U16.9 (IO2)
USB_HOST_CONN_D-: J12.2 (D-), R154.1, U16.1 (IO1), U16.10 (IO1)
USB_HOST_D+: R155.2, U19.21 (D+)
USB_HOST_D-: R154.2, U19.20 (D-)
USB_HOST_VBCOMP: C227.1, U19.22 (VBCOMP)
USB_HOST_VBUS: C219.1, C394.1, J12.1 (VBUS), U16.4 (IO3), U16.7 (IO3), U30.1 (OUT)
USB_HOST_VBUS_EN: R342.2, R344.2, R345.1, U30.4 (EN)
USB_HOST_VBUS_FLG: R343.2, U30.3 (FLG)
USB_HOST_XI: C220.1, U19.24 (XI), Y1.1
USB_HOST_XO: C223.1, U19.25 (XO), Y1.3
USB_USER.RCV: U25.2 (RCV)
USB_USER.SCON: U25.16 (SOFTCON)
USB_USER.SPD: U25.8 (SPEEED)
USB_USER.SUS: R195.1, U25.5 (SUSPND)
USB_USER.VBUS_PEN: R349.1
USB_USER.VDET: R190.1, R191.2
USB_USER.VM: U25.4 (VM)
USB_USER.VMO: U25.12 (VMO)
USB_USER.VP: U25.3 (VP)
USB_USER.VPO: U25.11 (VPO)
USB_USER.~OE: R194.1, U25.1 (~OE)
USB_USR_CC1: J14.A5 (CC1), R361.1, U21.1 (IO1), U21.10 (IO1)
USB_USR_CC2: J14.B5 (CC2), R362.1, U21.5 (IO4), U21.6 (IO4)
USB_USR_CONN_D+: J14.A6 (D+), J14.B6 (D+), R169.2, R171.1, R174.1, U21.2 (IO2), U21.9 (IO2)
USB_USR_CONN_D-: J14.A7 (D-), J14.B7 (D-), R170.2, R172.1, R173.1, U21.4 (IO3), U21.7 (IO3)
USB_USR_D+: R174.2, U25.10 (D+)
USB_USR_D-: R173.2, U25.9 (D-)
USB_USR_VBUS: C396.1, C397.1, J14.A4 (VBUS), J14.A9 (VBUS), J14.B4 (VBUS), J14.B9 (VBUS), R190.2, U43.1 (OUT)
USB_USR_VPU: R171.2, R172.2, U25.15 (VPU)
~BDBUS3: Q17.3 (D), R166.1, R180.2

Notes on the sheet:
NOTE: DNP for host-side
NOTE: DNP for peripheral-side
NOTE: UART RX/TX cross
I2C_SDA_OUT
DIR HIGH (A > B)
SPI_SCK
I2C_SCL
SPI_SS
NOTE: 4x buffers decoupling. Place close to pins TXU0304BQAR - 1 & 14 74LVC1T45GM - 1 & 6
USR_USB
SPI_SI
1u close to VCC 100n close to VL
I2C_SDA_IN
SPI_SO
USB HOST
USB DEBUG
