kangyuzhe666/kintex-410t-devboard/user-gpio.kicad_sch

## KiCad design user-gpio.kicad_sch (2023-02-02)

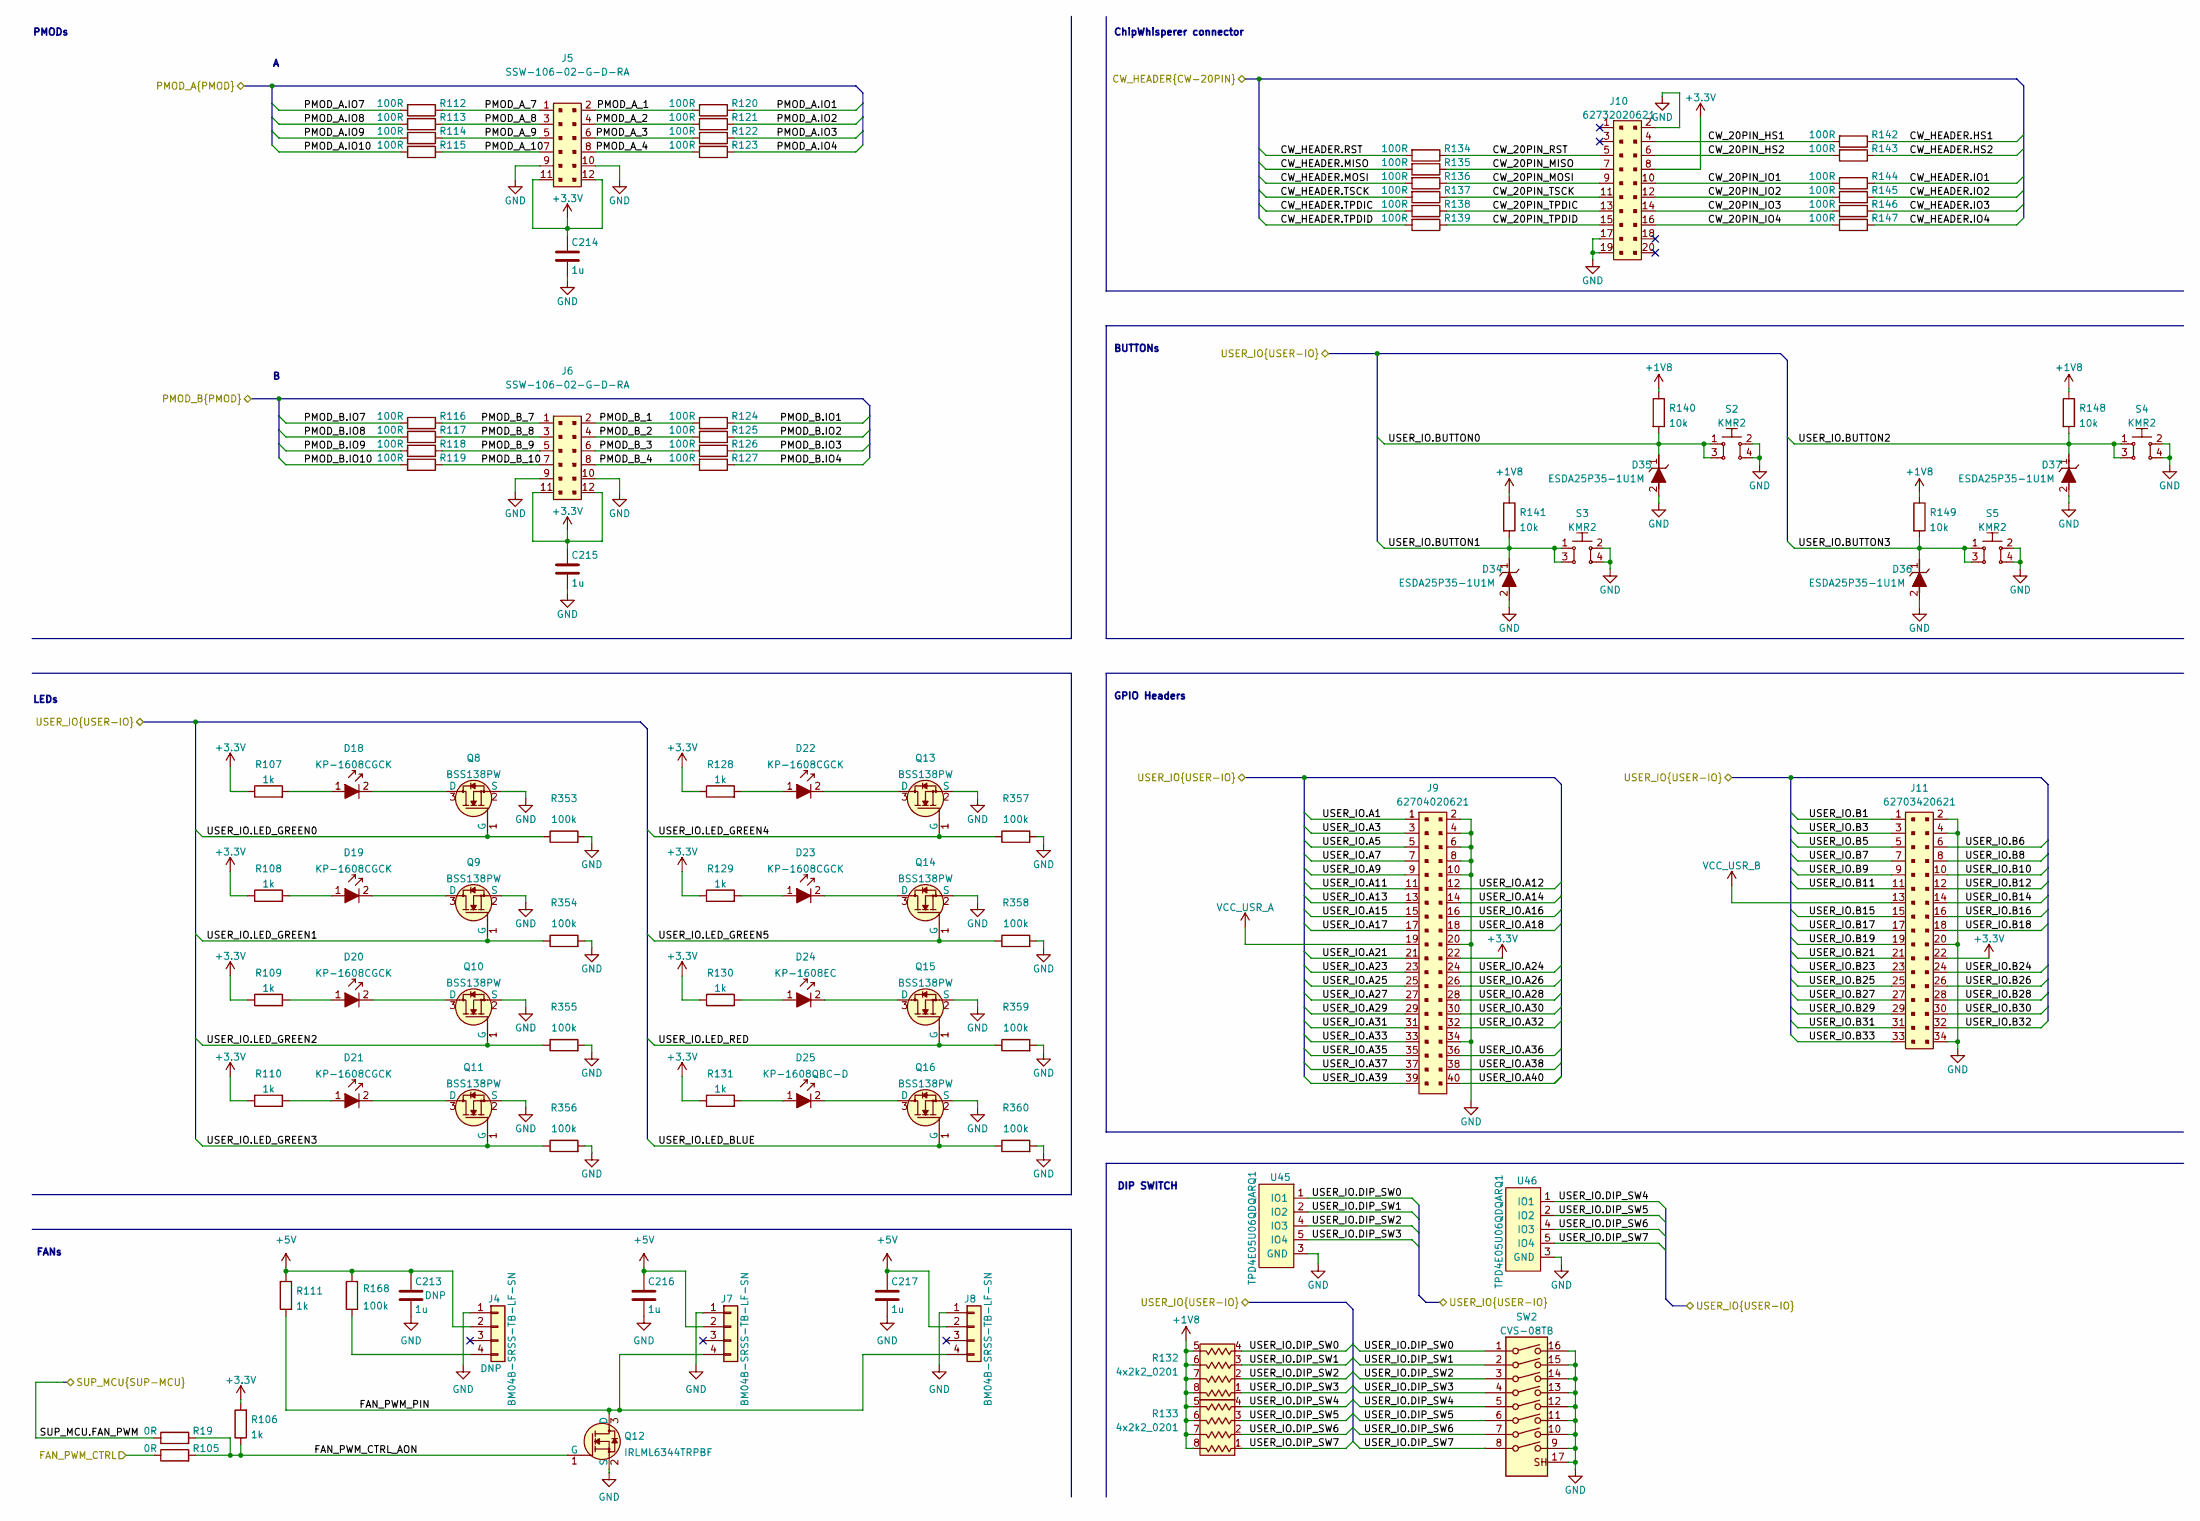
[picture p13: schematic user-gpio.kicad_sch]

Parts:
C213, C214, C215, C216, C217: C_1u_0402; 0402-cap; MPN C1005X6S1A105K050BC
D18, D19, D20, D21, D22, D23: KP-1608CGCK; LED_0603; MPN KP-1608CGCK
D24: KP-1608EC; LED_0603; MPN KP-1608EC
D25: KP-1608QBC-D; LED_0603; MPN KP-1608QBC-D
D34, D35, D36, D37: ESDA25P35-1U1M; 0603-diode; MPN ESDA25P35-1U1M
J4, J7, J8: BM04B-SRSS-TB-LF-SN; MPN BM04B-SRSS-TB(LF)(SN)
J5, J6: SSW-106-02-G-D-RA; SAMTEC_SSW-106-02-G-D-RA; MPN SSW-106-02-G-D-RA
J9: 62704020621; 627x4020621; MPN 62704020621
J10: 62732020621; 627x2020621; MPN 62732020621
J11: 62703420621; 627x3420621; MPN 62703420621
Q8, Q9, Q10, Q11, Q13, Q14, Q15, Q16: BSS138PW; SC70-3; MPN BSS138PW
Q12: IRLML6344TRPBF; SOT-23-3; MPN IRLML6344TRPBF
R19, R105: R_0R_0402; 0402-res; MPN ERJ2GE0R00X
R106, R107, R108, R109, R110, R111, R128, R129, R130, R131: R_1k_0402; 0402-res; MPN CR0402-FX-1001GLF
R112, R113, R114, R115, R116, R117, R118, R119, R120, R121, R122, R123, R124, R125, R126, R127, R134, R135, R136, R137, R138, R139, R142, R143, R144, R145, R146, R147: R_100R_0402; 0402-res; MPN CR0402-FX-1000GLF
R132, R133: 4x10k_0201_array; EXB18V; MPN EXB-18V103JX
R140, R141, R148, R149: R_10k_0402; 0402-res; MPN CRCW040210K0FKEDHP
R168, R353, R354, R355, R356, R357, R358, R359, R360: R_100k_0402; 0402-res; MPN CRCW0402100KFKEDHP
S2, S3, S4, S5: KMR2; SW_SPST_4.2x2.8; MPN KMR211NGLFS
SW2: CVS-08TB; SW_DIP_SPSTx08_Slide_Copal_CVS-08xB_W5.9mm_P1mm; MPN CVS-08TB
U45, U46: TPD4E05U06QDQARQ1; USON-10_2.5x1.0mm_P0.5mm; MPN TPD4E05U06QDQARQ1

Connections:
+1V8: R132.5, R132.6, R132.7, R132.8, R133.5, R133.6, R133.7, R133.8, R140.1, R141.1, R148.1, R149.1
+3.3V: C214.1, C215.1, J5.11, J5.12, J6.11, J6.12, J9.22, J10.8, J11.22, R106.2, R107.1, R108.1, R109.1, R110.1, R128.1, R129.1, R130.1, R131.1
+5V: C213.1, C216.1, C217.1, J4.2, J7.2, J8.2, R111.2, R168.2
CW_20PIN_HS1: J10.4, R142.2
CW_20PIN_HS2: J10.6, R143.2
CW_20PIN_IO1: J10.10, R144.2
CW_20PIN_IO2: J10.12, R145.2
CW_20PIN_IO3: J10.14, R146.2
CW_20PIN_IO4: J10.16, R147.2
CW_20PIN_MISO: J10.7, R135.1
CW_20PIN_MOSI: J10.9, R136.1
CW_20PIN_RST: J10.5, R134.1
CW_20PIN_TPDIC: J10.13, R138.1
CW_20PIN_TPDID: J10.15, R139.1
CW_20PIN_TSCK: J10.11, R137.1
CW_HEADER.HS1: R142.1
CW_HEADER.HS2: R143.1
CW_HEADER.IO1: R144.1
CW_HEADER.IO2: R145.1
CW_HEADER.IO3: R146.1
CW_HEADER.IO4: R147.1
CW_HEADER.MISO: R135.2
CW_HEADER.MOSI: R136.2
CW_HEADER.RST: R134.2
CW_HEADER.TPDIC: R138.2
CW_HEADER.TPDID: R139.2
CW_HEADER.TSCK: R137.2
FAN_PWM_CTRL: R105.1
FAN_PWM_CTRL_AON: Q12.1 (G), R19.2, R105.2, R106.1
FAN_PWM_PIN: J7.4, J8.4, Q12.3 (D), R111.1
GND: C213.2, C214.2, C215.2, C216.2, C217.2, D34.2, D35.2, D36.2, D37.2, J4.1, J5.9, J5.10, J6.9, J6.10, J7.1, J8.1, J9.2, J9.4, J9.6, J9.8, J9.10, J9.20, J9.34, J10.2, J10.17, J10.19, J11.2, J11.4, J11.20, J11.34, Q8.2 (S), Q9.2 (S), Q10.2 (S), Q11.2 (S), Q12.2 (S), Q13.2 (S), Q14.2 (S), Q15.2 (S), Q16.2 (S), R353.2, R354.2, R355.2, R356.2, R357.2, R358.2, R359.2, R360.2, S2.2, S2.4, S3.2, S3.4, S4.2, S4.4, S5.2, S5.4, SW2.9, SW2.10, SW2.11, SW2.12, SW2.13, SW2.14, SW2.15, SW2.16, SW2.17 (SH), U45.3 (GND), U45.8 (GND), U46.3 (GND), U46.8 (GND)
unnamed: D18.1, R107.2
unnamed: D18.2, Q8.3 (D)
unnamed: D19.1, R108.2
unnamed: D19.2, Q9.3 (D)
unnamed: D20.1, R109.2
unnamed: D20.2, Q10.3 (D)
unnamed: D21.1, R110.2
unnamed: D21.2, Q11.3 (D)
unnamed: D22.1, R128.2
unnamed: D22.2, Q13.3 (D)
unnamed: D23.1, R129.2
unnamed: D23.2, Q14.3 (D)
unnamed: D24.1, R130.2
unnamed: D24.2, Q15.3 (D)
unnamed: D25.1, R131.2
unnamed: D25.2, Q16.3 (D)
unnamed: J4.4, R168.1
PMOD_A.IO1: R120.1
PMOD_A.IO2: R121.1
PMOD_A.IO3: R122.1
PMOD_A.IO4: R123.1
PMOD_A.IO7: R112.2
PMOD_A.IO8: R113.2
PMOD_A.IO9: R114.2
PMOD_A.IO10: R115.2
PMOD_A_1: J5.2, R120.2
PMOD_A_2: J5.4, R121.2
PMOD_A_3: J5.6, R122.2
PMOD_A_4: J5.8, R123.2
PMOD_A_7: J5.1, R112.1
PMOD_A_8: J5.3, R113.1
PMOD_A_9: J5.5, R114.1
PMOD_A_10: J5.7, R115.1
PMOD_B.IO1: R124.1
PMOD_B.IO2: R125.1
PMOD_B.IO3: R126.1
PMOD_B.IO4: R127.1
PMOD_B.IO7: R116.2
PMOD_B.IO8: R117.2
PMOD_B.IO9: R118.2
PMOD_B.IO10: R119.2
PMOD_B_1: J6.2, R124.2
PMOD_B_2: J6.4, R125.2
PMOD_B_3: J6.6, R126.2
PMOD_B_4: J6.8, R127.2
PMOD_B_7: J6.1, R116.1
PMOD_B_8: J6.3, R117.1
PMOD_B_9: J6.5, R118.1
PMOD_B_10: J6.7, R119.1
SUP_MCU.FAN_PWM: R19.1
USER_IO.A1: J9.1
USER_IO.A3: J9.3
USER_IO.A5: J9.5
USER_IO.A7: J9.7
USER_IO.A9: J9.9
USER_IO.A11: J9.11
USER_IO.A12: J9.12
USER_IO.A13: J9.13
USER_IO.A14: J9.14
USER_IO.A15: J9.15
USER_IO.A16: J9.16
USER_IO.A17: J9.17
USER_IO.A18: J9.18
USER_IO.A21: J9.21
USER_IO.A23: J9.23
USER_IO.A24: J9.24
USER_IO.A25: J9.25
USER_IO.A26: J9.26
USER_IO.A27: J9.27
USER_IO.A28: J9.28
USER_IO.A29: J9.29
USER_IO.A30: J9.30
USER_IO.A31: J9.31
USER_IO.A32: J9.32
USER_IO.A33: J9.33
USER_IO.A35: J9.35
USER_IO.A36: J9.36
USER_IO.A37: J9.37
USER_IO.A38: J9.38
USER_IO.A39: J9.39
USER_IO.A40: J9.40
USER_IO.B1: J11.1
USER_IO.B3: J11.3
USER_IO.B5: J11.5
USER_IO.B6: J11.6
USER_IO.B7: J11.7
USER_IO.B8: J11.8
USER_IO.B9: J11.9
USER_IO.B10: J11.10
USER_IO.B11: J11.11
USER_IO.B12: J11.12
USER_IO.B14: J11.14
USER_IO.B15: J11.15
USER_IO.B16: J11.16
USER_IO.B17: J11.17
USER_IO.B18: J11.18
USER_IO.B19: J11.19
USER_IO.B21: J11.21
USER_IO.B23: J11.23
USER_IO.B24: J11.24
USER_IO.B25: J11.25
USER_IO.B26: J11.26
USER_IO.B27: J11.27
USER_IO.B28: J11.28
USER_IO.B29: J11.29
USER_IO.B30: J11.30
USER_IO.B31: J11.31
USER_IO.B32: J11.32
USER_IO.B33: J11.33
USER_IO.BUTTON0: D35.1, R140.2, S2.1, S2.3
USER_IO.BUTTON1: D34.1, R141.2, S3.1, S3.3
USER_IO.BUTTON2: D37.1, R148.2, S4.1, S4.3
USER_IO.BUTTON3: D36.1, R149.2, S5.1, S5.3
USER_IO.DIP_SW0: R132.4, SW2.1, U45.1 (IO1), U45.10 (IO1)
USER_IO.DIP_SW1: R132.3, SW2.2, U45.2 (IO2), U45.9 (IO2)
USER_IO.DIP_SW2: R132.2, SW2.3, U45.4 (IO3), U45.7 (IO3)
USER_IO.DIP_SW3: R132.1, SW2.4, U45.5 (IO4), U45.6 (IO4)
USER_IO.DIP_SW4: R133.4, SW2.5, U46.1 (IO1), U46.10 (IO1)
USER_IO.DIP_SW5: R133.3, SW2.6, U46.2 (IO2), U46.9 (IO2)
USER_IO.DIP_SW6: R133.2, SW2.7, U46.4 (IO3), U46.7 (IO3)
USER_IO.DIP_SW7: R133.1, SW2.8, U46.5 (IO4), U46.6 (IO4)
USER_IO.LED_BLUE: Q16.1 (G), R360.1
USER_IO.LED_GREEN0: Q8.1 (G), R353.1
USER_IO.LED_GREEN1: Q9.1 (G), R354.1
USER_IO.LED_GREEN2: Q10.1 (G), R355.1
USER_IO.LED_GREEN3: Q11.1 (G), R356.1
USER_IO.LED_GREEN4: Q13.1 (G), R357.1
USER_IO.LED_GREEN5: Q14.1 (G), R358.1
USER_IO.LED_RED: Q15.1 (G), R359.1
VCC_USR_A: J9.19
VCC_USR_B: J11.13

Notes on the sheet:
DIP SWITCH
GPIO Headers
LEDs
FANs
PMODs
BUTTONs
ChipWhisperer connector
