kangyuzhe666/kintex-410t-devboard/(notices)

Notices in the files:
parts and their libraries:
License: MIT
